mlh5599/volt-drive-mode-fixer/DESIGN.md

# Volt Drive Mode Fixer — Design

**Status:** deployed on the Pi (`voltpi`), field testing (Phase C).

- **Done:** mode-button input (`0x1E1`), current-mode status (`0x1F4` byte
  1), and shift/PRNDL (`0x1F5` byte 3) are confirmed on-road; the
  closed-loop menu walk has an on-road PASS. SOC is resolved via the
  `22 005B` UDS poll (`raw·100/255`, gauge↔SOC ≈ `7.07·bars + 19.6`,
  r = 0.999), so the level-triggered reconciler in "Mode policy" — SOC-HOLD
  floor keyed off that poll, `0x096` byte 3 as a coarse failsafe — is
  **implemented**. `--dry-run` is gone: the daemon boots **armed** on the
  first detent of the four-position selector (passive until the SOC floor
  engages), and `voltdmf-ctl disarm` is the mid-drive stop.
- **Not done:** migrating the out-of-repo `roles/voltdmf` ExecStart /
  `config.yaml` to match.

Running status, per-drive procedures, and outcomes: `docs/field-session-log.md`
and `docs/phase-c-field-checklist.md`.

## Problem

On an aging Gen 1 Chevy Volt (2011–2015), fully depleting the EV battery causes
the pack voltage to sag under load, which trips "reduced propulsion" mode: the
gas engine revs to near max RPM to generate power directly, and the car
becomes sluggish. The owner currently avoids this by manually switching
drive/charge modes before the battery runs low. This project automates that
with a device on the car's CAN bus that continuously reconciles the drive mode
(see "Mode policy" below) toward a desired mode, switching before the pack gets
low enough to cause the problem.

## Design requirements

- **DR1 — Prevent reduced-propulsion mode.** Act on EV battery SOC/range
  before the pack depletes far enough to cause voltage sag and trigger
  reduced-propulsion mode.
- **DR2 — Drive toward a chosen mode each drive cycle.** On every drive cycle
  (ignition on) hold a selected mode (MOUNTAIN or, by default, the SOC-HOLD
  floor). Realized as the reconciler's four-position selector — see "Mode
  policy".
- **DR3 — SOC floor.** When SOC drops to a configurable percentage, switch to
  Hold Mode and keep it there until the pack recovers. Realized as the floor
  in "Mode policy" — live in the `hold-soc`, `hold-now` and `mountain`
  detents, deliberately disabled in `off`.
- **DR4 — Off-the-shelf hardware preferred.** Favor a proven, reusable CAN
  interface over custom PCB/firmware design; hobbyist-level electronics
  work (soldering, wiring, light scripting) is acceptable where needed.
- **DR5 — Extensible to a future Trip Mode input.** The reconciler/injector
  architecture must accommodate a speed-based Hold input feeding the desired
  mode later without a redesign.

## Vehicle context

The Volt (both Gen 1 and Gen 2, model years 2011–2019) uses GM's **Global A**
CAN architecture. Unlike newer GM "Global B" vehicles, there is no
authenticating central gateway blocking the OBD-II port — the standard
driver-side OBD-II connector gives direct read/write access to the relevant
CAN buses. The Volt also has a second, auxiliary OBD-style connector
(passenger side) exposing the HV/battery-management bus, but the standard
port is sufficient for this project.

Gen 1 (this car) has a single physical mode button that **cycles** through
four modes, in order: **Normal → Sport → Mountain → Hold** (then presumably
back to Normal). This is the same kind of cycling control opendbc documents
for Gen 2 — plausibly even the same underlying signal (`0x1E1`, see below),
though that's only confirmed on a 2017 (Gen 2) car and needs verification on
this one.

Each mode's behavior:
- **Normal** — uses the full EV battery before switching to gasoline.
- **Sport** — same battery behavior as Normal, snappier throttle response.
- **Mountain** — lets the pack drain to ~50% SOC, then maintains ~50% by
  engaging the gas engine as needed.
- **Hold** — maintains the pack at *whatever SOC it's at* when engaged, by
  engaging the gas engine as needed.

Because it's a cycle button rather than discrete per-mode controls, reaching
a specific target mode means sending the same one button-press message a
computed number of times from the current mode — not one distinct message
per mode. See "Mode policy" and "Software architecture" below.

## Mode policy — continuous reconciler

> **Why a reconciler, not edge triggers.** An edge-triggered switch does
> nothing if the driver later bumps the mode by hand or a switch doesn't
> take. A single **level-triggered reconciler** that continuously drives the
> car toward a *desired* mode is simpler and self-healing, and satisfies both
> DR2 and DR3 without separate configurable triggers.
>
> This was originally reasoned from "ignition is effectively always on (the
> Pi only has power while the car runs), so there is no ignition edge to
> trigger on" — **falsified on-road, Session 13 (2026-09-19):** the car has a
> retained-power-like window (ignition off, door not opened) where the Pi,
> cluster, and cluster-related bus traffic all stay alive, and the reconciler
> kept trying to walk the menu in it. The level-triggered design itself still
> stands on the argument above, independent of ignition; what was missing was
> a *precondition* — **added Session 14 (2026-09-19):** `0x3ED` presence is a
> confirmed ignition-on signal, and `SafetyGate._precondition_failure()` now
> blocks both the reconciler and manual `set-mode` while it reads off.

**Desired mode = f(selector position, SOC).** One loop pass computes the mode
the car *should* be in. The result is concrete (HOLD / MOUNTAIN) **or `None`**
— `None` means "no target, leave the car alone", which is what the `hold-soc`
detent yields above the floor and what `off` yields unconditionally. If a concrete desired mode differs from
`state.drive_mode` (read from `0x1F4` byte 1) and the daemon is armed, it asks
the safety gate to walk the menu there — so a hand-picked mode change gets
walked back, at most once per 10 s cooldown. The reconcile is also skipped
entirely until `0x1F4` decodes a current mode (a fresh boot on a quiet or
just-woken bus does nothing until it can see where the menu cursor is).

**The four-position selector.** One panel button (SW1) is a rotary detent the
driver taps forward; a fifth tap returns to the first position. The daemon
owns the cycle (`voltdmf-ctl setpoint next`), so nothing can drift out of step
with it.

| position | pack above `hold_threshold_percent` | pack at/below `hold_threshold_percent` |
| --- | --- | --- |
| **1. `hold-soc`** — hold the pack at 30 % (boot default) | desired = **None** — leave the car alone | desired = **HOLD**, latched for the key cycle |
| **2. `hold-now`** — bank what is left, starting now | desired = **HOLD** | desired = **HOLD** |
| **3. `mountain`** — enforce MOUNTAIN | desired = **MOUNTAIN** | desired = **HOLD** (floor wins) |
| **4. `off`** — as if unplugged | desired = **None** | desired = **None** — *floor disabled* |

- **Position 1 is the product.** "Hold the battery at 30 %" is the whole point
  of the device, so it is both the first detent and the boot default. It is
  passive above the floor: the car drives on battery exactly as it normally
  would, and a mid-drive restart on a healthy pack leaves the car where the
  driver had it. The daemon only acts once the pack reaches
  `hold_threshold_percent`.
- **Position 2 is the same floor, brought forward.** `hold-now` asks for HOLD
  from loop 1 whatever the pack reads, and needs no SOC reading at all — for
  the drive where the driver decides *now* is the moment to stop spending
  charge (a highway leg before a city errand). It is enforcement, not the
  floor, so `floor_latched` stays false; the floor can still latch underneath
  it and would change nothing, since both ask for HOLD.
- **Position 4 turns the device off, floor included.** `off` short-circuits
  *before* the floor is evaluated and clears any standing latch, so the car
  behaves exactly as if the Pi were not plugged in. This is the one position
  in which the pack is unprotected — deliberate, so the driver always has a
  way to hand the car back to itself without pulling the connector. Entering
  `off` clears the latch rather than freezing it, because a latch surviving
  there would re-assert HOLD the instant the driver taps back round, on a
  reading that may be minutes stale — and it is, deliberately, the only way to
  release a latched floor without restarting.
- **The selector is not persisted.** The Pi runs a read-only root with an
  overlay filesystem, so there is nothing to write to, and **every boot starts
  at `default_position`** (`hold-soc`). A fresh key cycle is a fresh drive.
- **The floor latches for the key cycle.** At/below `hold_threshold_percent`
  (**30** — diag SOC from the `22 005B` poll) the floor engages (desired =
  HOLD) and **stays engaged** for the rest of the key cycle. There is no
  release percent: "drain to 30 %, then hold, and do not let it change".
  Regen or a long descent putting charge back into the pack must not hand the
  car back to EV mode and spend it again. The latch lives in memory only and
  is dropped on `reload` and on a restart; the selector position survives a
  reload — it is the driver's live choice.
- **Failsafe on a stale poll.** If the poll stops answering (older than
  ~45 s), `0x096` byte 3 ≤ `bar_failsafe_raw` (**9**, ≈ 2 gauge bars) forces
  HOLD. Because the latch is now permanent for the key cycle, the failsafe
  holds fire for the first ~45 s after start — long enough for the poll to get
  a word in — rather than committing the whole drive off a ~13 %-per-count
  proxy before the exact reading has had a chance to arrive. After that grace
  it fails safe into charge-sustaining HOLD.
- **Floor target = 2 gauge bars remaining.** On a full-drain drive the last
  bar (`1→0`) fell in **53 s** against a ~170 s average for the other nine —
  the bottom of the gauge is a cliff, so the floor engages while 2 bars still
  show. Gauge↔SOC: `SOC% ≈ 7.07·bars + 19.6` (r = 0.999); the 3→2 bar drop is
  **33.7 %** (raw 0x56), the 4→3 bar mark **41.2 %** (raw 0x69). The engage
  point is **30 %** — mid-2-bar, and the driver-facing name of position 1.
- **A spent pack takes HOLD off the menu.** Once the car gives up on the pack
  for a key cycle it starts the range extender and sits in NORMAL, and the
  centre stack stops offering HOLD and MOUNTAIN at all — observed in the field
  (a restart after parking on a nearly-flat pack) and caught on the wire in a
  full-drain capture. Walking a menu that has no such entry can
  only spend taps, so **engine running + car in NORMAL + no fresh SOC reading
  above 24 % ⇒ the reconciler withholds its target** and reports why
  (`reconciler.charge_sustaining_block`, surfaced as `ice_block` in `status`,
  `NO HOLD` on the LCD). The 24 % release keeps a cold-morning ERDTT start, an
  engine-maintenance cycle, or our own working HOLD from blocking anything.
  The check is level-triggered and self-clearing, fails **open** on an unknown
  engine reading (a car without `0x4C5`/`0x3F9` behaves exactly as before) and
  **closed** on an unknown SOC, and the SOC floor gets no exemption — a
  latched floor asking for HOLD on a written-off pack is the exact drive that
  produced it.
- **Give up after three walks.** The gate above covers the one failure we
  understand; `safety.AttemptBudget` covers every other one without needing to
  know what it is. The reconciler is level-triggered, so "mode != target"
  stays true forever if the walk never lands — before this, the only thing
  between that and a whole drive of 10 s tap bursts was the cooldown itself.
  Three walks, because a walk is already a closed loop that taps up to 12
  times reading the cursor back each time: a whole walk failing is not "a tap
  went missing", it is "the menu is not behaving", and a fourth identical walk
  is not new information. An **attempt** is a walk that put taps on the wire —
  a walk suppressed by the cooldown, a precondition, or the ICE block costs
  nothing, so a car with a quiet bus never burns the budget. It clears when
  the car reaches the mode (however it got there — the driver's own thumb
  counts), when the target changes, and on explicit intent: an SW1 tap, a
  `set-mode`, an `arm`, a `reload`, and the bus going quiet, which is this
  project's key-cycle boundary. Nothing is persisted and nothing expires on a
  timer: giving up is meant to be visible (`give_up` / `attempts` in `status`,
  `GAVE UP` on the LCD, one journal line per edge) and to stay given up until
  a person or the car says otherwise.
- **Reconcile cadence vs. the driver.** The reconcile runs every loop but
  every switch still goes through `SafetyGate` (preconditions + the 10 s
  cooldown), so if the driver fights the selector the daemon re-asserts at
  most once every ten seconds. The cooldown started at 60 s, when a runaway
  walk was the fear; field testing has landed 35/35 legs in ≤ 4 taps, and at
  60 s a driver who bumps the stalk could spend most of a minute in the wrong mode.
  10 s still rules out sustained transmission. The button is the intended
  override — tap round to `off` and the daemon stops asserting anything.

**Mechanics of reaching a target mode** (unchanged). The button cycles
Normal → Sport → Mountain → Hold, so "go to HOLD" means "press N times" where
N depends on the current mode. The current-mode status signal is confirmed
(`0x1F4` byte 1), so the controller reads it directly and closes the loop on
the live menu cursor (`0x1F4` bytes 4+5) rather than blind-counting. The
blind count `index(target) + 1` is in fact correct from any mode — the menu
always opens on NORMAL — so the closed loop buys early exit and a hard
failure on a dropped tap, not correctness.

**Trip Mode (DR5, future work — not building this yet).** The
[prior-art project](https://github.com/vix597/chevy-volt-trip-mode)'s
speed-based Hold (bank EV range on the highway, release it in the city) would
become a fifth detent or a modifier on the policy, reusing the same
reconcile + injector plumbing. Tracked, not scheduled.

Config (`config.example.yaml`; parsed by `voltdmf/config.py`):

```yaml
policy:
  default_position: hold-soc    # hold-soc | hold-now | mountain | off — boot
                                # detent, not persisted
  hold_threshold_percent: 30    # floor forces HOLD at/below this diag SOC and
                                # latches for the rest of the key cycle
  bar_failsafe_raw: 9           # 0x096 b3 <= this forces HOLD if the poll is stale

soc_poll:
  enabled: true                 # run the 22 005B UDS poll for ground-truth SOC
  period_seconds: 10            # request cadence
```

`parse_config` validates `default_position ∈ {hold-soc, hold-now, mountain,
off}`, `0 ≤ hold_threshold_percent ≤ 100`, `0 ≤ bar_failsafe_raw ≤ 255`, and
`period_seconds > 0`. The old key name `default_setpoint` is still read, and
the old detent names `auto` (two-way toggle) and `hold` (three-position cycle)
both map to `hold-soc` — that is what each meant at the time — so a config.yaml
from either era keeps loading; setting both keys is an error. The retired
`hold_reset_percent` is warned about and ignored rather than rejected, so a
host that has not converged yet still boots. The button GPIO pins live in the `button_helper.py`
unit, not here.

## Prior art (reuse this, don't rebuild it)

[`vix597/chevy-volt-trip-mode`](https://github.com/vix597/chevy-volt-trip-mode)
(blog writeup: [seanlaplante.com](https://seanlaplante.com/2021/11/13/hacking-my-chevy-volt-to-auto-switch-driving-modes-for-efficiency/))
is a 2017 Volt (Gen 2) project that does almost exactly this kind of
automation — it auto-switches modes based on speed rather than SOC, using a
comma.ai panda + Raspberry Pi. It's built directly on
[`commaai/opendbc`](https://github.com/commaai/opendbc)'s
`gm_global_a_powertrain.dbc`, which decodes the Volt/Bolt-era GM Global A
bus. Reuse this DBC file and its CAN signal IDs rather than
reverse-engineering the whole bus from scratch; this project reads/writes
CAN over PiCAN2's SocketCAN interface rather than panda, but the signal
discovery and injection logic transfer directly.

Its known gap, worth fixing rather than copying: it runs the panda in
`SAFETY_ALLOUTPUT` mode with no message whitelist, so the device is
technically capable of transmitting anything on the bus. This project has no
hardware-level safety firmware equivalent (PiCAN has none built in, unlike
panda), which makes the software-level "Safety model" below — the single
narrow send function and rate limiting — load-bearing rather than a second
layer of defense.

## Known CAN signals

| Signal | ID | Notes |
|---|---|---|
| EV battery SOC (exact) | `22 005B` (UDS PID) | **The daemon's SOC source.** `0x206` (the Gen 2 broadcast candidate) is not on this bus, and no passive frame carries SOC at usable resolution, so the daemon polls diagnostic PID `22 005B` ("Hybrid/EV Battery Pack Remaining Charge") every ~10 s: request `03 22 00 5B 55 55 55 55` to `0x7E4` then `0x7E0` (lock onto whichever answers), reply on `0x7E8..0x7EF`, `SOC% = d[4]·100/255`. Stays in the default diagnostic session, service-22 only — no session switch, no TesterPresent — so it can't suppress normal broadcasts. The poll is a second hard-coded TX path (`canio.send_soc_poll`), ungated by arm state, gated only by `soc_poll.enabled`. |
| EV battery SOC (coarse proxy / failsafe) | `0x096`, byte 3 | Only valid in the `x F0 0A xx` mux (`data[1]==0xF0 and data[2]==0x0A`). Steps ~13 % SOC per count — far too coarse to key the floor off, used only as the failsafe when the `22 005B` poll goes stale: b3 ≤ `bar_failsafe_raw` (9 ≈ 2 gauge bars ≈ 30 %) forces HOLD. `signals.decode_soc_bar_raw`. |
| Drive mode cycle button press | `0x1E1`, byte 4 bit 7 | **CONFIRMED on Gen 1, on-road.** `ASCMSteeringButton`; byte 4 low bits are a rolling counter, bit 7 is the press flag. Same ID/bit the Gen 2 prior art injects. `voltdmf/canio.send_mode_button_press()` (tracking-echo press) — one of the daemon's two hard-coded TX frames (the other is the `22 005B` SOC poll); this is the only one gated by arm state. |
| Ignition on/off | `0x3ED` (presence) | **CONFIRMED 2026-09-19, Session 14.** The Pi being powered from the switched accessory socket does *not* imply the daemon only runs while the car is on: Session 13 found a retained-power-like window ("RAP") — ignition off, door not opened — where the cluster, the Pi, and cluster-related bus traffic (`0x1F4`/`0x1F5`/`0x3E9`) all stay alive, and `state.bus_active` (fed by that same traffic) cannot tell RAP from ignition-on. Session 14's in-car ON/OFF/ON capture (reproduced across two cycles) found the ID that can: `0x3ED` is present (constant payload `80 00 00 00 00 FF`) only while the ignition is on, and vanishes entirely — the whole ID, not a byte within it — through the RAP window. `state.ignition_on`, fed by it, is now a `SafetyGate._precondition_failure()` precondition, so both the reconciler and manual `set-mode` refuse a switch in RAP. The Session-13 fast-abort mitigation (`MENU_UNRESPONSIVE_TAPS`) stays in place as defense in depth. Not yet measured: `0x3ED`'s own transmit period (`IGNITION_QUIET_TIMEOUT_S` borrows `BUS_QUIET_TIMEOUT_S` as a placeholder). |
| Vehicle speed | `0x3E9` | Bytes 0-1 big-endian ÷ 64 → km/h (× 0.621371 → mph). Per the GM Volt reverse-engineering wiki, cross-checked against a full-drain capture; not yet speedo-verified. DLC 8, 10 Hz; bytes 2 & 6 are a mux/rolling counter. Not needed for the SOC-triggered design but useful for bench testing/logging (`tools/soc_log.py` logs it plus a derived accel). |
| Shift/PRNDL position | `0x1F5`, byte 3 | **CONFIRMED on Gen 1.** `1` PARK, `2` REVERSE, `3` NEUTRAL, `4` DRIVE, `5` LOW. Reported in `status` / the trip log, **not** a `SafetyGate` precondition — a drive-mode change has no driveline implication, so PRNDL does not block a switch (see "Safety model"). `0x135` byte 0 also tracks the shifter but with a messier non-sequential encoding — left undecoded. |
| EV range remaining | — | **Not documented anywhere found.** The `22 005B` SOC poll (above) is the trigger signal instead — satisfies the design requirement to trigger on range or battery % (DR1/DR3) and is the metric that's actually accessible. |
| Reduced-propulsion / limp-mode indicator | — | **Not documented.** Not needed for this design since the goal is to act *before* this state, using the SOC threshold instead. |
| Range-extender engine running | `0x4C5` byte 2 (+ `0x3F9` bytes 1-2) | **CONFIRMED on Gen 1, offline from field captures.** `0x4C5` b2: `0x49` off, `0xDD` on an engine leg, `0x59`/`0x87`/`0xB5` a ~1.5 s ramp at either edge. `0x3F9` b1-2 BE is a fuelling accumulator whose *movement* corroborates it -- it leads `0x4C5` by 33-42 s at the head of a leg and freezes on overrun and at rest, so the two are read as a union (`VehicleState.engine_running`). Purpose: once the pack is spent the car runs the engine in NORMAL and drops HOLD/MOUNTAIN from the centre-stack menu, so the reconciler must stop walking to a mode that is not on offer (see "Mode policy" / `reconciler.charge_sustaining_block`). `docs/analysis/session12-engine-signal.md`. |
| Current drive mode (status, not button-press) | `0x1F4`, byte 1 | **CONFIRMED on Gen 1.** Latched mode: `0x00` NORMAL, `0x80` SPORT, `0x20` MOUNTAIN, `0x08` HOLD. byte 4 = live drive-mode menu cursor (steps ~40 ms after each tap; distinct byte codes), byte 5 bit 7 = menu-open hint. The daemon reads byte 1 as its current-mode source — the press-counting fallback is retired. |

## Hardware design

### Alternatives considered

DR1–DR3 require a device that can both read and write raw CAN traffic on
the vehicle's buses — not just standard OBD-II diagnostic PIDs. That rules
out generic ELM327-style OBD2 USB/Bluetooth adapters (e.g. the ones used
with Torque): they speak the OBD2 diagnostic request/response protocol
only, can't sniff non-standard manufacturer IDs like `0x206` (SOC) or the
mode-cycle button message, and generally can't transmit arbitrary frames at
all. Among devices that do speak raw CAN:

| Device | Read+Write | Approx. price | Why not chosen |
|---|---|---|---|
| **CANable / CANtact** | Yes | $30–60 | SocketCAN-compatible, works with generic `python-can`, but no GM-specific precedent or safety/ignition features — this project would own all the reverse-engineering and safety-model work with no reference to check against. |
| **PCAN-USB (PEAK-System)** | Yes | $200+ | Industrial-grade and very reliable, but priced and positioned for professional automotive tooling rather than the hobbyist car-hacking community — little overlap with existing GM Global A tribal knowledge. |
| **Kvaser Leaf Light** | Yes | $200–400+ | Similar tier to PCAN-USB — professional-grade and overkill for this project's scope. |
| **Macchina M2** | Yes | — | Purpose-built for vehicle hacking, similar spirit to panda, but reportedly hard to source or discontinued. |
| **ESP32 + SN65HVD230 transceiver** (DIY) | Yes | $20–25 | Cheapest option, but the whole CAN stack, message filtering, and safety logic would need to be written from scratch — the most custom-firmware work of any option, cutting against the off-the-shelf/light-scripting preference (DR4). |
| **Freematics ONE+** | Yes | — | Telematics-focused (built-in GPS/logging); CAN-capable but little presence in the GM/opendbc hobbyist community. |
| **comma.ai panda (red)** | Yes | $99 | Only option with a documented Volt-specific precedent ([`vix597/chevy-volt-trip-mode`](https://github.com/vix597/chevy-volt-trip-mode)) and comes with openpilot's safety-firmware rate-limiting built in. Ruled out on sourcing grounds: the red panda's vehicle-side port is a proprietary "OBD-C" connector, not standard OBD-II — reaching a vehicle's OBD-II port needs a $49 third-party adapter ([konik.ai OBD2C connector](https://konik.ai/shop/obd2c-connector/)) that ships only from an EU warehouse, with no US stock or reseller found. Older pandas with a native OBD-II connector (white/grey/black) are discontinued and only findable used. |
| **PiCAN2 / PiCAN3** (Raspberry Pi HAT) — **chosen** | Yes | $37–78 + a Pi | See below. |

**Why PiCAN2:** PiCAN2 and PiCAN3 use identical CAN silicon (MCP2515
controller / MCP2551 transceiver) — read/write capability is the same on
both. PiCAN3 adds Pi 4 support, an onboard automotive-range SMPS, reverse-polarity
protection, and an RTC, none of which this project needs: **PiCAN2** paired
with a Pi 3B is the simpler, cheaper choice. Both expose a DB9 connector
(jumper-selectable for an "OBD-II cable" pinout), and standard off-the-shelf
OBD-II-to-DB9 cables exist that carry exactly the three wires needed
(CAN-H, CAN-L, ground) — e.g. the
[iKKEGOL DB9-to-OBD2 cable](https://www.amazon.com/iKKEGOL-Adapter-Diagnostic-Extension-Connector/dp/B077SHQQ1D)
(~$10–15, ships from a US Amazon warehouse). This sidesteps the sourcing
problem that ruled out panda entirely — no proprietary connector, no
overseas shipping, no DIY fabrication required. It satisfies DR4 better
than panda on balance: slightly more wiring/config work (SocketCAN device-tree
overlay setup) in exchange for a fully off-the-shelf, US-available parts
list. Because PiCAN exposes standard Linux **SocketCAN** (`can0`), the same
interface `python-can`/`cansend` use everywhere, the reference project's
`opendbc`-based injection logic ports over by swapping the transport
backend (socketcan instead of panda), not rewriting the injection logic.
The read+write pattern itself is proven on this hardware generically (e.g.
[skpang/PiCAN-Python-examples](https://github.com/skpang/PiCAN-Python-examples)
transmits live CAN frames to drive a real instrument cluster gauge) —
there's no GM/Volt-specific PiCAN precedent, but none was needed once the
signal IDs are confirmed from the panda-based reference project's work.

Note: PiCAN2 draws its 5V entirely from the Pi's own 40-pin GPIO
header — it has no separate power input of its own. This matters for the
power design below.

**BOM — ordered 2026-08-23:**

| Part | Role | Price paid | Source |
|---|---|---|---|
| PiCAN2 (SK Pang, base version) | CAN read/write interface, DB9 connector | $59.95 | [Copperhill Technologies](https://copperhilltech.com/pican-2-can-bus-interface-for-raspberry-pi/) |
| Raspberry Pi 3B | Runs the monitor/injector daemon; PiCAN2 mounts directly on it | $35.00 | [Adafruit #3055](https://www.adafruit.com/product/3055) |
| OBD-II-to-DB9 cable (iKKEGOL) | Connects PiCAN2's DB9 port to the vehicle's OBD-II port | ~$10–15 | [Amazon](https://www.amazon.com/iKKEGOL-Adapter-Diagnostic-Extension-Connector/dp/B077SHQQ1D) — also Copperhill's own recommended replacement for their now-discontinued OBD2-DB9 cable, confirming the pinout matches PiCAN2's OBD-II jumper setting (CAN-H → OBD pin 6 → DB9 pin 3; CAN-L → OBD pin 14 → DB9 pin 5; ground → OBD pins 4/5 → DB9 pins 1/2) |
| 12V cigarette-lighter/accessory-socket USB car charger (5V) | Power for the Pi | ~$8–10 | any standard USB car charger |
| microSD card | OS storage | ~$8 | any Class 10/A1-rated card |

This is a smaller footprint than the reference project (which added a
touchscreen for a manual UI) since this design's whole point is to run
unattended — no display needed. Mount the Pi + PiCAN2 somewhere accessible
(e.g. under the dash near the OBD port) so it's easy to unplug entirely if
something needs to be debugged or disabled — that's the physical kill
switch, and it's free.

**Power.** This Volt's accessory (cigarette-lighter) socket is switched
with the car rather than always-hot, so a standard USB car charger plugged
into it is sufficient — no relay, no separate switched-12V tap, and no
ignition-sense circuitry needed to avoid draining the 12V battery while
parked. That still means power gets cut abruptly (no clean OS shutdown) on
every drive cycle, which is addressed at the OS level instead of with extra
hardware: configure Raspberry Pi OS's built-in **Overlay File System**
(`raspi-config` → Performance Options) so the root partition is mounted
read-only with a RAM (tmpfs) overlay for writes — nothing is physically
written to the SD card during normal operation, so an abrupt power cut
can't corrupt it. This requires also write-protecting `/boot/firmware`
(asked as a separate prompt in the same raspi-config flow) and disabling
swap, both easy to miss. The tradeoff: anything not explicitly persisted
outside the overlay (logs, runtime config changes) is lost on every power
cycle — acceptable here since drive-mode state is re-derived from the CAN
bus on each boot, but something to keep in mind if the daemon later needs
to persist SOC-threshold calibration or logs across drives.

**Ignition-off power blip (owner-observed 2026-09-19, not yet root-caused).**
The power cut at key-off is not always clean: pressing the ignition button
puts a momentary blip/brownout on the switched accessory socket that resets
the Pi outright. It then reboots into the RAP window described above (see
the "Ignition/drive-cycle start" row) with the daemon starting fresh —
systemd brings it up **armed**, and it immediately faces a bus that is still
carrying cluster traffic from a car that is actually off. This reframes the
Session 13 failure: it is not a long-running daemon misreading a stale
signal, it is a cold boot walking straight into RAP. Candidate fix: bulk
capacitance on the Pi's supply to ride through the blip — not yet sized or
installed. Until then, any capture meant to isolate the ignition-off
transition cleanly (e.g. `tools/ignition_diff.py`) needs the Pi on an
external battery/UPS, not the stock USB charger, or the capture process
dies with the reset. **Session 14 update:** a cold boot into RAP is no
longer a walk waiting to happen — `state.ignition_on` (fed by `0x3ED`) is a
`SafetyGate` precondition, so a fresh daemon booting straight into a RAP
window now reads ignition off and refuses to walk, same as any other RAP
case. The power-blip hardware fix is still worth doing (an unplanned reboot
mid-drive is its own problem), but it is no longer what stands between a
cold boot and a doomed menu walk.

## Software architecture

Reuse rather than rebuild:
- **`opendbc`**'s `gm_global_a_powertrain.dbc` for decoding/encoding CAN
  frames (SOC, speed, shift position, and — once discovered — the Gen 1 mode
  button signal).
- **`python-can`** (with its SocketCAN backend) for talking to PiCAN2's
  `can0` interface from the Pi.
- **SavvyCAN** (has native SocketCAN support on Linux) or **can-utils**'
  `candump`/`cansend` for the manual reverse-engineering phase (see below)
  — no need to write custom logging tools. (`cabana`, used in the panda-based
  reference project, is panda-specific and doesn't apply here.)

The custom code needed is small and specific to this project:

1. **Config loader** — reads the YAML above, validates it (detent name,
   percentage and byte ranges), and produces the policy for the run.
2. **SOC poller** — an inline loop step (`daemon._service_soc_poll`) that
   sends `22 005B` every `soc_poll.period_seconds` (`canio.send_soc_poll`,
   ungated by arm state); the RX listener folds replies on `0x7E8..0x7EF`
   into `state.soc_percent` / `soc_raw` / `soc_percent_monotonic`. `0x096`
   byte 3 is decoded passively into `state.soc_bar_raw` as the failsafe
   proxy. `0x206` is absent on this bus.
3. **Reconciler** (`voltdmf/reconciler.py`, replaces `triggers.py`) — a pure
   object, `Reconciler.desired_mode(state) -> DriveMode` (always concrete),
   per the "Mode policy" table, plus the in-memory floor-latch hysteresis and
   the b3 failsafe. The loop calls it every pass and, when `desired` differs
   from `state.drive_mode` and the daemon is armed, hands `desired` to the
   safety gate. No per-drive edge state, no once-only latch.
4. **Button helper** — a tiny separate process (system Python, `gpiozero`)
   that owns the two PiCAN2 pads (SW1 = BCM 24, SW2 = BCM 23) and dispatches
   by gesture:
   - **SW1 tap** → `voltdmf-ctl setpoint next`: advance the selector one
     detent (`hold` → `mountain` → `off` → `hold`). The daemon owns the
     cycle; the helper keeps no index of its own, so a daemon restart or a
     `setpoint` from the shell can never leave the button a tap behind.
   - **SW1 held alone ≥ 8 s, then released** → `voltdmf-ctl walk-test`: the
     daemon cycles the closed-loop mode walk through every drive mode, scores
     each landing off `0x1F4`, and walks back to the starting mode. The 5–8 s
     SW1-solo window is a dead zone so a slow reach for the combo can't trip
     it; result shows on the LCD watch screen.
   - **SW2 held ~5 s alone, then released** → launch the charge-current
     setpoint capture (`voltdmf-chargelog.service`; checklist §2e). Fires on
     release with SW1 never joined, so a hand travelling toward the combo
     below can't trip it.
   - **SW1 + SW2 held ~5 s** → launch the SOC-discovery capture
     (`voltdmf-soclog.service`).

   Both launches free the GPIO lines, claim the LCD hand-off lock, `systemctl
   start` the oneshot and block until it exits (polling `is-active`, never
   trusting the queued `start`), then re-acquire — and wait for both pads to
   be released before reading gestures again so the capture's hold-BOTH stop
   can't roll into a fresh launch. The gesture rules live in a side-effect-free
   `_Gestures` state machine (unit-tested off-Pi). Kept out of the daemon so
   its venv gains no GPIO dependency and its privilege set is unchanged; it
   reaches the daemon only through the existing control socket. Its own
   systemd unit in `roles/voltdmf`.
5. **Mode-cycle controller** — reads current mode from the status signal
   (`0x1F4` byte 1, confirmed), walks the drive-mode menu to the requested
   `target_mode` along the fixed Normal→Sport→Mountain→Hold cycle order —
   closing the loop on the live menu cursor (`0x1F4` bytes 4+5) — and sends the
   taps through the safety wrapper below. This is the one place that needs the
   actual button-press CAN frame; the reconciler and `set-mode` both just ask
   it for a `target_mode` and it doesn't care which asked.
6. **Safety wrapper** (see next section) — the only code path allowed to
   transmit.

The button-press signal (`0x1E1`) and the current-mode readback (`0x1F4`)
are both confirmed on-vehicle, so this controller now exists
(`voltdmf/modecycle.py`). The original caution still holds as a principle: a
controller built against a guessed CAN ID, or one that can't tell what mode
it's starting from, is worse than not having one.

## Safety model

CAN has no authentication, and the reference project's `SAFETY_ALLOUTPUT`
approach means the panda can transmit *anything*, not just the one message
this project needs. Tighten that:

- **Two narrow send functions, no generic sender.** `canio` has exactly two
  functions that put a frame on the bus: `send_mode_button_press()`
  (hard-coded `0x1E1` press — every mode transition reuses this one message,
  gated by arm state) and `send_soc_poll()` (hard-coded `22 005B` request,
  ungated — a read-only diagnostic poll). Each hard-codes its ID + payload;
  there is no general-purpose "send arbitrary frame" path.
- **Two sockets, split by job.** `open()` binds *two* SocketCAN sockets to the
  same interface: `_bus`, which the RX `can.Notifier` owns, and `_echo_bus`,
  hardware-filtered to `0x1E1` and used only by the press path. This is a
  correctness requirement, not an optimization. The tracking-echo press must
  mirror the module's *current* `0x1E1` counter — a stale counter is the
  frozen-counter frame the cluster ignores — and sharing one socket breaks
  that two different ways, both measured on-vehicle:
  `recv()` alongside the Notifier lost 21% of taps, because SocketCAN gives
  each frame to exactly one reader; taking the frame from the Notifier's
  decoded state instead was *worse* at 36%, because that thread lags on a busy
  Global A bus and hands back an already-stale frame. A second bound socket
  gets its own copy of every frame, so the echo is neither contended nor
  stale. It widens no privilege: the filter means it only ever queues `0x1E1`,
  and the only thing written to it is the one hard-coded press frame.
- **Rate limiting.** Cap both the size and rate of a press burst — at most
  3 presses (Normal→Hold, the longest possible cycle) with realistic
  inter-press spacing, never a sustained/looping transmission. Re-check the
  current mode (if readable) after sending to confirm it landed on the
  intended target rather than blindly trusting the press count.
- **Bounded persistence.** Rate limiting bounds how *fast* the daemon can
  tap; it does nothing about how *long*. A level-triggered reconciler chasing
  a mode the car will not take is a slow-motion runaway, and one whole drive
  of it is what a real field failure looked like. `safety.AttemptBudget`
  bounds the total: three walks per target, then it stops and says so, until
  the car reaches the mode or a person intervenes (see "Mode policy").
- **Preconditions before injecting**: a live bus and a plausible speed. Both
  are checks on the *bus* — a quiet bus means nobody is listening, an
  implausible speed means the frames being decoded are garbage. **Shift/PRNDL
  is deliberately not a precondition.** The button being pressed is the
  centre-stack energy-mode menu (Normal/Sport/Mountain/Hold); it changes how
  the car spends the pack, never what the driveline does, so pressing it
  stopped in Park is exactly what a driver does. Gating on Drive bought no
  safety and cost real behaviour — it stopped the reconciler settling the
  mode in the driveway or at a charger before the car moved. Shift is still
  decoded and reported, just not enforced.
- **Fail passive.** If the daemon crashes or hangs, it should simply stop
  transmitting — never get stuck mid-loop retrying a send. Run it under a
  process supervisor (e.g. `systemd` with restart-on-failure). The daemon
  keeps **no persisted state** (read-only overlay root): a fresh start boots
  armed at `default_position` (`hold-soc` on the shipped config → passive above
  the floor) with the floor latch clear and re-derives everything from the
  live bus, so there is no stale latch to re-fire and — absent a low pack —
  nothing to walk.
- **Physical kill switch**: unplugging the OBD connector fully removes the
  device from the bus — keep it physically easy to reach for exactly this
  reason during early testing.
- **Bench test before live testing.** Validate the discovered mode-switch
  message with the car safely stationary (ignition on, engine off, or on
  jack stands) before relying on it while driving.
- **Runtime control does not widen the transmit surface.** The daemon runs
  permanently as root under systemd; operators drive it from an unprivileged
  account through a control socket (see "Runtime control" below). Every
  command that could transmit still funnels through the *same*
  `SafetyGate.request*()` → single `send_mode_button_press()` path the
  reconciler uses. A manual `set-mode` is an out-of-band nudge that does not
  move the selector — it is still subject to preconditions, the press cap, the
  cooldown, and the menu-cursor readback, and the reconciler will pull the mode
  back on its next pass. There is still no "send arbitrary frame" path.

### Runtime control

The daemon is a long-running root service, not a set of one-shot CLI
invocations. State changes come in over an `AF_UNIX` stream socket
(`voltdmf/control.py`), reached with the unprivileged `voltdmf-ctl` client:

| command | effect | path |
| --- | --- | --- |
| `status` | daemon + vehicle snapshot | answered read-only on the socket thread |
| `arm` / `disarm` | flip the runtime transmit-enable | queued → loop thread |
| `setpoint <hold-soc\|hold-now\|mountain\|off\|next>` | move the four-position selector to a named detent, or `next` for one detent forward (what the panel button sends) | queued → loop thread |
| `set-mode <mode>` | request one mode switch now, out of band | queued → `SafetyGate.request_verbose()` |
| `reload` | re-read the config file, rebuild the policy | queued → loop thread |
| `walk-test` | self-test the closed-loop mode walk: cycle every drive mode, score each landing, restore the start mode | queued → sets a flag; the loop thread runs the ~1 min cycle inline (reconciler skipped) and reports on the LCD + journal |
| `test-mode <on\|off>` | suspend / resume the reconciler for an interactive probe session (in memory — a restart brings protection back) | queued → loop thread sets a flag; the reconcile pass is skipped while on |
| `probe <mode>` | one operator-chosen closed-loop walk to `<mode>`, densely tracing the `0x1F4` cursor; records a `LANDED` / `CURSOR_ONLY` / `MISS` / `BLOCKED` verdict in `status` + the journal | queued → sets a flag; the loop thread runs it inline with a ~50 ms cursor sampler thread |

> **All commands are implemented.** `setpoint` drives the reconciler;
> `tools/button_helper.py`'s SW1 tap drives a real toggle. `walk-test` (SW1
> solo hold ≥ 8 s) drives its own cooldown-free `SafetyGate` around the shared
> controller, so the real 10 s gate and the single-threaded TX path are
> untouched; it needs the daemon armed and refuses if a run is already queued.
> `test-mode` + `probe` are the focused replacement for blind walk-test
> debugging: an operator suspends the reconciler, sets a known start mode by
> hand, asks for one target, and reads the per-tap + dense-sample cursor trace
> back — see `docs/analysis/session10-walk-probe.md`.

- **Privilege boundary = file mode.** The `.socket` unit binds it
  `0660 root:voltdmf`; operators join the `voltdmf` group. No setuid, no
  polkit, no D-Bus.
- **systemd socket activation.** `voltdmf.socket` passes an already-bound
  listening fd as fd 3; `control.inherited_listener()` picks it up with no
  `python-systemd` dependency. The service still runs continuously
  (`WantedBy=multi-user.target`) — activation only supplies the fd, it does
  not make the daemon on-demand.
- **Single-threaded transmit preserved.** `status` is answered directly from
  a state snapshot. Everything that can transmit or mutate state is put on a
  `queue.Queue` and executed by the daemon's one loop thread — the CAN TX
  path and `SafetyGate` are never touched from the socket thread.
- **One gate: armed / disarmed.** There is no `--dry-run`. The service boots
  **armed** — injection efficacy is on-road-confirmed, so there is no reason
  to hold it back a key cycle at a time — but with `default_position: hold-soc` it
  has no target and enforces nothing until the SOC floor engages or the driver
  taps SW1 round to `hold-now` or `mountain` (see "Mode policy"). Tapping round to `off`
  stands the device down entirely, floor included. `voltdmf-ctl disarm` is the
  mid-drive stop; `voltdmf-ctl arm` undoes it. While disarmed the reconciler
  still runs and logs what it *would* do, and the `22 005B` SOC poll still
  transmits (it is a read-only diagnostic request, not a mode change).
  `--start-disarmed` boots into the stopped state for bench work.
- **`setpoint` is the normal control.** It moves the four-position selector
  (`hold-soc` → `hold-now` → `mountain` → `off`, `next` to advance one
  detent). The CLI deliberately does not accept a bare `hold`: with two hold
  detents a human typing it today could mean either. The reconciler
  then drives the car toward whatever the detent implies and holds it there,
  self-healing if the driver bumps the stalk. The position lives in memory
  only — every boot starts at `default_position` (no persisted state; see
  "Mode policy").
- **`set-mode` is a soft, out-of-band nudge.** It asks the mode-cycle
  controller for one switch now without moving the selector, so the reconciler
  will pull the mode back on its next pass (after the cooldown). Use it for
  bench pokes, not steady-state control.
- **`reload` re-reads the config file.** It rebuilds the `policy:` /
  `soc_poll:` blocks and the reconciler. The live selector position is
  preserved (the driver's choice, not a file value); the floor-latch state
  is dropped, so the floor re-evaluates from the current SOC.

## Phased plan

1. **Signal discovery (on-vehicle, stationary).** Connect PiCAN2 + laptop
   (skip the Pi for now, or use the Pi itself with a monitor/SSH), log CAN
   traffic with SavvyCAN or `candump`.
   Confirm `0x206` tracks SOC sensibly on this car. Then, with the car
   safely stationary:
   - Press the mode button once and diff CAN traffic before/after. Check
     first whether it matches `0x1E1` bit 39 from `gm_global_a_powertrain.dbc`
     — if so, this signal transfers directly from the Gen 2 reference
     project and saves the rest of this reverse-engineering step.
   - Cycle through all four modes (Normal→Sport→Mountain→Hold) while
     logging, watching for any *other* message that changes value in sync
     with the mode change — that's the current-mode status signal the
     controller needs. A good place to check: whatever message drives the
     dash cluster's mode indicator icon, since that has to be broadcast on
     the bus regardless of what triggered the change.
   - Ignition-cycle mode persistence is no longer on the critical path: the
     reconciler is level-triggered and reads the live mode from `0x1F4` every
     pass, so it converges regardless of what mode the car powers up in.
2. **Bench-safe injection test.** Using the discovered button-press message,
   replay presses from the laptop (still stationary) and confirm the mode
   actually advances one step per press, in the expected order, and that
   nothing else on the bus reacts badly (watch for new DTCs, warning
   lights).
3. **Daemon development.** Write the config loader, the SOC poller, the
   reconciler, the button helper, and safety-wrapped injector(s) described
   above, using the confirmed CAN IDs. Test on the Pi with the overlay
   filesystem enabled (see "Hardware design") before final deployment — the
   read-only root is why the reconciler keeps no persisted state.
4. **Deployment.** Mount the Pi + PiCAN2 in the car, power from the
   accessory socket, and test across several real drive cycles, tuning the
   SOC threshold based on how early the switch needs to happen to reliably
   avoid reduced-propulsion mode.

## Open items

### Resolved on-vehicle (Gen 1, HS-CAN 500k)

Full detail in `docs/signals-confirmed.md`; decoders in `voltdmf/signals.py`.

- **Mode-cycle button press → `0x1E1` byte 4 bit 7** — same ID/bit as the Gen
  2 prior art; the one frame the daemon transmits. Drove a closed-loop walk
  to all four modes on the road.
- **Current drive mode → `0x1F4` byte 1** (`0x00`/`0x80`/`0x20`/`0x08` =
  N/S/M/H) — the daemon's current-mode source. Bytes 4+5 are one field, the
  live menu cursor used to close the loop on a walk (`00`/`80` = NORMAL,
  `80`/`00` SPORT, `40` MOUNTAIN, `20` HOLD, both `00` = menu closed).
- **Shift/PRNDL → `0x1F5` byte 3** (`1`–`5` = P/R/N/D/L). Decoded and
  reported; not a `SafetyGate` precondition (see "Safety model").
- **SOC → `22 005B` UDS poll.** Exact pack percent = `raw·100/255`
  from a ~10 s service-22 poll; the gauge↔SOC curve is `SOC% ≈
  7.07·bars + 19.6` (r = 0.999). The floor engages at 30 % (mid-2-bar) and
  latches for the rest of the key cycle. This unblocked the armed reconciler.
- **Ignition on/off → `0x3ED` presence** (Session 14, 2026-09-19). Present
  with a constant payload while the ignition is on; the whole ID vanishes,
  including through the RAP window, the instant it goes off. A
  `SafetyGate._precondition_failure()` precondition for both the reconciler
  and manual `set-mode`, closing the gap Session 13 found.

### Still open

- **Drop the poll for a passive signal.** The `22 005B` poll works but it is
  an active TX on the vehicle bus every 10 s; a passive broadcast field would
  be cleaner. `0x096` byte 3 (the failsafe proxy) is far too coarse
  (~13 % SOC/count). The three broadcast candidates found in field captures — `0x3E3` bytes
  0/1/6, `0x228` byte 2, `0x186` byte 6 — still have no raw→% scaling anchor;
  the running trip logs (SOC % vs. each candidate raw, stamped every line by
  `soc_log.py`) are the data set to calibrate one against and eventually
  retire the poll.
- **Validate the 33 / b3≤9 timing on the road.** Watch the trip logs over
  several drives — does the floor engage early enough that the pack never
  reaches the 1→0 bar cliff, and does the b3 failsafe hold if a poll gap
  lands at the wrong moment.
- **Measure `0x3ED`'s transmit period.** Session 14 (2026-09-19) confirmed
  `0x3ED` presence as the real ignition-state signal (see the "Known CAN
  signals" table and `docs/field-session-log.md` Session 14) and wired it
  into `SafetyGate._precondition_failure()`, but its own frame rate wasn't
  captured before the Pi dropped off the network mid-session.
  `IGNITION_QUIET_TIMEOUT_S` (`voltdmf/state.py`) currently borrows
  `BUS_QUIET_TIMEOUT_S` (2.0 s) as a placeholder — tighten or loosen once a
  real rate is measured.

### Deferred (not blocking)

- **Drive-mode persistence across ignition cycles.** Off the critical path
  under the reconciler (it reads the live mode from `0x1F4` and converges from
  any starting mode). Still mildly interesting for tuning the first-pass delay
  — `tools/ignition_check.py`, whenever it's convenient.

### Stretch goal — force 12 A Level 1 charging

Not part of the drive-mode mission; a low-risk add-on that would reuse the
same bus tap and the same arm-gated injector safety wrapper.

The center-stack setting that raises 120 V charging from **8 A to 12 A** can
be changed at any time (even while driving), but **reverts to 8 A every time
the car leaves Park** — GM's guard against an unknown / marginal wall circuit.
The owner only ever charges on a known-good home circuit, so the revert is
pure friction; the goal is to make the car *always* Level-1-charge at 12 A.

Approach: detect the Park-exit revert (or just assert continuously) and
re-send the "12 A" setpoint frame so the faster rate always sticks.

Unknowns, all answerable from **one capture**: the setpoint frame ID / byte /
encoding (likely `0x08`↔`0x0C` amps, or `0x28`↔`0x3C` in the 0.2 A units OVMS
documents for charger telemetry on `0x5EC`), whether it carries a rolling
counter / checksum, and whether the HMI re-asserts fast enough to need
continuous TX vs a single post-revert shot. Discovery is a **standalone
garage session** — car in READY and Park, toggle the menu setting while
capturing, no drive and no discharged pack needed — see
`docs/phase-c-field-checklist.md` §2e. A P→R→P shift in the garage exercises
the forced 8 A revert; it lands on the same timestamp as `0x1F5` byte 3
leaving `0x01` (Park), a free labeled edge for the offline analysis.

Safety: 12 A at 120 V is 1.44 kW — within the car's own menu option and the
Lear charger's ~12.7 A ceiling. The only real-world caveat (the wall circuit
being rated for 12 A continuous) is one the owner controls by only ever
plugging in at home. No safety-of-motion dimension. It is still a bus TX, so
it goes through the same arm gate, error-frame watch, and DTC scan as
mode injection.

## Sources

- [vix597/chevy-volt-trip-mode](https://github.com/vix597/chevy-volt-trip-mode)
- [seanlaplante.com writeup](https://seanlaplante.com/2021/11/13/hacking-my-chevy-volt-to-auto-switch-driving-modes-for-efficiency/)
- [commaai/opendbc](https://github.com/commaai/opendbc)
- [PiCAN2 (SK Pang Electronics)](https://www.skpang.co.uk/products/pican2-can-bus-board-for-raspberry-pi-2-3)
- [skpang/PiCAN-Python-examples](https://github.com/skpang/PiCAN-Python-examples)
- [Raspberry Pi Overlay File System (read-only root)](https://learn.adafruit.com/read-only-raspberry-pi/overview)
- [OVMS voltampera_canbusnotes.txt](https://github.com/openvehicles/Open-Vehicle-Monitoring-System/blob/master/vehicle/Car%20Module/VoltAmpera/voltampera_canbusnotes.txt)
- [GM Volt Reverse Engineering Wiki](https://vehicle-reverse-engineering.fandom.com/wiki/GM_Volt)
- [GM-Volt.com OBD2 FAQ](https://www.gm-volt.com/threads/obd2-obdii-obd-ii-device-faq.110641/)
- [Understanding the openpilot Safety Model](https://blog.comma.ai/understanding-the-openpilot-safety-model/)
