mlh5599/volt-drive-mode-fixer/voltdmf/canio.py

"""SocketCAN I/O: the RX decode loop and the transmit paths.

Exactly two functions in this whole project put a frame on the bus, each
hard-coding its one address and payload:

* :meth:`CanInterface.send_mode_button_press` -- the drive-mode button tap on
  0x1E1. Gated: only transmits while the daemon is armed.
* :meth:`CanInterface.send_soc_poll` -- one ``22 005B`` UDS request. Ungated:
  it is a read, runs armed or disarmed, and every drive wants ground-truth
  SOC.

There is no "send arbitrary frame" path anywhere (DESIGN.md "Safety model").
"""

from __future__ import annotations

import logging
import time
from typing import Callable

import can

from . import signals
from .signals import SIGNAL_IDS, DriveMode
from .state import VehicleState

log = logging.getLogger(__name__)

# --- The one message this project is allowed to transmit -------------------
#
# Confirmed 2026-08-29 on-vehicle: on the Gen 1 HS-CAN (500k) the drive-mode
# button and the current-mode status share arbitration ID 0x1F4. The body
# module streams `00 <mode> 00 00 00 00` at ~40 Hz (byte 1 = latched mode).
# The mode latches ~2-3 s after the last press.
#
# (An earlier revision of this note claimed a physical tap sets 0x1F4 byte 5
# to 0x80 and then "ramps" byte 4 80->40->20 while held. That was a
# misreading: bytes 4+5 are the MENU CURSOR, and the "ramp" was the cursor
# advancing NORMAL->SPORT->MOUNTAIN->HOLD under the cluster's key-repeat.
# See the 0x1F4 block comment in signals.py.)
#
# Two different IDs:
#   MODE_STATUS_ADDR 0x1F4 -- body module streams `00 <mode> 00 00 <cursor>
#     <cursor>` at ~40 Hz; byte 1 = latched mode. READ ONLY (read_drive_mode).
#   MODE_BUTTON_ADDR 0x1E1 -- "ASCMSteeringButton". byte 4 bit 7 = drive-mode
#     button pressed. This is what we TRANSMIT. Confirmed session 2
#     (2026-08-29): during a physical press 0x1E1 byte 4 goes 00/01/02/03 ->
#     80/81/82/83 (low bits are a rolling counter; bit 7 is the press flag).
#     Same ID/bit/payload the Gen 2 prior art (vix597/chevy-volt-trip-mode)
#     injects successfully.
#
# Injection model: TRACKING ECHO PRESS.
# 0x1E1 is NOT a static frame here. byte 4 low 2 bits are a rolling counter,
# bytes 5-6 are a counter-derived tail, and the module streams the frame at
# ~40 Hz. A captured *physical* press (session 2, 2026-08-29) is ~14
# consecutive frames with byte 4 bit 7 set, the counter still advancing
# normally (..83 82 81 80..), then bit 7 clears -- ~350 ms total.
#
# We deliberately do NOT replay all ~14: that captured press was long enough
# to trigger the cluster's key-repeat (~50 ms period) and walk the menu
# several rows. A discrete single-step press is ONE frame -- see
# PRESS_TRACK_FRAMES for the on-vehicle numbers. (A human holding the button
# gets key-repeat too; they just watch the menu and let go.)
#
# For PRESS_TRACK_FRAMES iterations we wait for the
# module's next live 0x1E1, OR 0x80 into its byte 4, and send that back into
# the ~24 ms gap before the module's next frame. Every injected frame carries
# the module's current counter + tail (only bit 7 differs), and it lands
# *between* module frames rather than colliding with one -- so the cluster's
# ~40 Hz poll sees a clean run of "pressed" frames with a valid advancing
# counter, then a release edge when we stop. The caller leaves >=
# RELEASE_GAP_S of silence before the next press.
#
# What did NOT work (session 2, on-vehicle): the wrong ID (0x1F4, a status
# echo); time.sleep()-paced 0x1E1 that collided with the module (TEC ->
# ERROR-PASSIVE); a static 0x1E1 frame with a frozen counter (ignored / only
# woke the menu); and a blind back-to-back blast of a frozen echo frame --
# long blasts get punched through by module frames at random points, so the
# cluster saw an unpredictable 0-2 presses per burst.
#
# This menu takes a wake press first: from an idle menu, press 1 only opens
# it -- and it always opens with the cursor on NORMAL regardless of the
# current mode (confirmed 2026-09-03; this is why presses_to_reach is
# index(target)+1 from any mode). Spacing presses ~1.4 s apart registers each
# one cleanly and stays inside the ~3 s menu-open window. Both are the
# caller's problem (ModeCycleController), not this function's.
#
# (An earlier note here claimed the cluster rate-limits to ~5 s and ignores
# presses ~2 s apart. That was an artifact of the old 16-frame press: those
# were being key-repeated into multi-row jumps, not ignored. At 1 frame,
# 1.4 s spacing is reliable -- measured on-vehicle 2026-09-03.)
#
# Injection efficacy is on-road-confirmed: the tracking-echo press drove a
# closed-loop walk to all four modes (2026-08-29, see the 0x1E1 note in
# signals.py). tools/inject_test.py remains the bench harness for the TX path.
MODE_STATUS_ADDR = 0x1F4
MODE_BUTTON_ADDR = 0x1E1
PRESS_BYTE4 = 0x80               # 0x1E1 byte 4 bit 7 = button pressed
# Frames with bit 7 set per logical press. MUST be exactly 1: the cluster
# key-REPEATS a held button roughly every 50 ms, so any longer run of
# "pressed" frames walks the menu extra rows on what the caller thinks is one
# tap. Measured on-vehicle 2026-09-03 with tools/press_calibrate.py:
#     16 frames -> ~5-6 steps per tap   (the old value; the dominant bug)
#      8 frames -> 2 steps
#      2 frames -> 1 step, but DOUBLE-steps ~1 run in 8 (3/24 across all
#                  sessions; caught live by the probe sampler, which logged
#                  the cursor going mountain -> hold 51 ms apart on one tap)
#      1 frame  -> 1 step, 22/22, never a double
# 1 frame does occasionally get DROPPED (~5-10%: 1/22 isolated presses, and
# 1 of 10 presses in a back-to-back walk). That is the right failure to have.
# A dropped tap is visible to ``ModeCycleController._walk_closed_loop`` -- the
# cursor simply did not move -- and costs one extra tap out of MAX_WALK_TAPS
# (12, against a 4-tap worst-case walk), while the loop's 1.6 s per iteration
# stays inside the ~3 s menu-open window so nothing commits early. An
# overshoot is not recoverable in the same way: it commits the WRONG mode.
# So: never overshoot, let the closed loop absorb the drops.
PRESS_TRACK_FRAMES = 1
_TRACK_FRAME_TIMEOUT_S = 0.1    # give up waiting for the next live 0x1E1
RELEASE_GAP_S = 0.75            # min silence after a press = the "button up"
                                # (reference project's BUTTON_PRESS_COOLDOWN)
_TX_SEND_TIMEOUT_S = 0.1        # let python-can wait for a TX slot instead of
                                # raising "Transmit buffer full" immediately

# Back-compat: the old blast knobs some callers/tests still poke.
PRESS_FRAME_INTERVAL_S = 0.0
PRESS_BURST_FRAMES = PRESS_TRACK_FRAMES

#: Fallback 0x1E1 "button down" payload (no live counter) -- matches
#: vix597/chevy-volt-trip-mode's PRESS_MSG. Used only if no live 0x1E1 can be
#: read at all; the cluster has been seen to ignore this on the Gen 1.
_STATIC_PRESS_PAYLOAD = bytes((0x00, 0x00, 0x00, 0x00, PRESS_BYTE4, 0x00, 0x00))

#: Frames per logical press (compat alias for callers/tests).
SEND_CLUSTER_SIZE = PRESS_TRACK_FRAMES


class CanInterface:
    def __init__(
        self,
        channel: str = "can0",
        *,
        tx_gate: Callable[[], bool] | None = None,
    ) -> None:
        self._channel = channel
        # Runtime transmit enable, checked live on every button press. This is
        # the toggle the control socket's arm/disarm flips -- the project's one
        # and only TX lock now (``--dry-run`` is gone). When it returns False
        # ``send_mode_button_press`` logs the intended press and transmits
        # nothing. ``send_soc_poll`` ignores this -- a poll is a read.
        self._tx_gate = tx_gate
        self._bus: can.BusABC | None = None
        self._notifier: can.Notifier | None = None
        #: Second socket, filtered to 0x1E1, dedicated to the tracking-echo
        #: press -- see :meth:`open`.
        self._echo_bus: can.BusABC | None = None

    def _tx_suppressed(self) -> bool:
        return self._tx_gate is not None and not self._tx_gate()

    # -- lifecycle --------------------------------------------------------
    def open(self) -> None:
        self._bus = can.Bus(interface="socketcan", channel=self._channel)
        # SECOND socket for the press path. SocketCAN delivers every frame to
        # every socket bound to the interface, so this costs nothing and buys
        # two things the shared socket could not give at once:
        #
        #   * no contention -- a Notifier on ``_bus`` (the daemon) and a
        #     ``recv()`` here are no longer pulling from the same queue, where
        #     each frame goes to exactly one of them.
        #   * freshness -- the echo must mirror the module's CURRENT counter.
        #     Taking it from the Notifier's decoded state instead was tried
        #     (71f0fc3) and was WORSE, 36% dropped taps against 21%: the
        #     listener thread lags on a busy Global A bus, so the frame it had
        #     stashed was often already stale and the cluster ignored the echo
        #     exactly like the frozen-counter frame in session 2.
        #
        # The hardware filter means this socket only ever queues 0x1E1, so a
        # recv() here returns the newest button frame with minimal latency.
        # ``receive_own_messages`` stays False (python-can's default) so our
        # own injected frames never come back and get mistaken for the
        # module's.
        self._echo_bus = can.Bus(
            interface="socketcan", channel=self._channel,
            can_filters=[{"can_id": MODE_BUTTON_ADDR, "can_mask": 0x7FF}])
        log.info("opened %s (+ 0x%03X-filtered echo socket)",
                 self._channel, MODE_BUTTON_ADDR)

    def start_rx(self, state: VehicleState) -> None:
        if self._bus is None:
            raise RuntimeError("open() first")
        # The Notifier takes over ``_bus``. The press path is unaffected: it
        # lives on ``_echo_bus``, its own socket.
        self._notifier = can.Notifier(self._bus, [_DecodeListener(state)])

    def close(self) -> None:
        if self._notifier is not None:
            self._notifier.stop()
            self._notifier = None
        if self._echo_bus is not None:
            self._echo_bus.shutdown()
            self._echo_bus = None
        if self._bus is not None:
            self._bus.shutdown()
            self._bus = None

    def __enter__(self) -> "CanInterface":
        self.open()
        return self

    def __exit__(self, *exc) -> None:
        self.close()

    # -- observation helpers (used by the injection test) ---------------
    def _latest_status(self, decode, timeout: float) -> DriveMode | None:
        """Newest decodable 0x1F4 currently in the RX queue.

        ``recv()`` hands back the OLDEST queued frame first, and this socket
        buffers 0x1F4 at ~40 Hz the whole time ``send_mode_button_press()``
        runs (that path only drains 0x1E1). Returning the first 0x1F4 we see
        gives the caller a reading that can be >1 s stale -- enough to desync
        the closed-loop walk: it read "SPORT" while the cursor had already
        stepped to MOUNTAIN (field session 3, 2026-08-29). So block up to
        ``timeout`` for the first hit, then sweep the rest of the queue
        non-blocking and keep only the newest.
        """
        if self._bus is None:
            raise RuntimeError("open() first")
        end = time.time() + timeout
        latest: DriveMode | None = None
        while True:
            wait = 0.0 if latest is not None else max(0.0, end - time.time())
            msg = self._bus.recv(timeout=wait)
            if msg is None:
                if latest is not None or time.time() >= end:
                    return latest
                continue
            if msg.arbitration_id != MODE_STATUS_ADDR:
                continue
            decoded = decode(bytes(msg.data))
            if decoded is not None:
                latest = decoded

    def read_drive_mode(self, timeout: float = 1.0) -> DriveMode | None:
        """Return the *committed* drive mode (0x1F4 byte 1 -- lags a menu
        commit by ~3 s), from the newest frame in the RX queue."""
        return self._latest_status(signals.decode_drive_mode, timeout)

    def read_menu_cursor(self, timeout: float = 0.5) -> DriveMode | None:
        """Return the LIVE drive-mode menu cursor (0x1F4 bytes 4+5 -- steps
        ~40 ms after each button tap; see ``signals.decode_menu_cursor``),
        from the newest frame in the RX queue. Used to close the loop on a
        walk, so it MUST be current -- see :meth:`_latest_status`.

        NOTE ``_latest_status`` keeps only frames that *decode*, so a closed
        menu (cursor ``None``) is skipped rather than returned here. That is
        right for this caller -- it polls for the cursor to reach a target --
        but it is why the daemon's closed loop reads ``state.menu_cursor``
        instead, which does see the menu close."""
        return self._latest_status(signals.decode_menu_cursor, timeout)

    # -- the only transmit path ----------------------------------------
    def _next_button_frame(self, timeout: float) -> bytes | None:
        """Block up to ``timeout`` for the module's NEXT live 0x1E1 (>=7 B).

        Reads the dedicated ``_echo_bus`` socket, which is hardware-filtered to
        0x1E1 (see :meth:`open`). Nothing else consumes that socket, so this
        never races the daemon's Notifier and always returns a CURRENT frame --
        the echo has to carry the module's current counter or the cluster
        ignores it.

        DRAINS the queue first, then blocks for the next arrival. Both halves
        are load-bearing. Nothing reads this socket between taps, so during the
        walk's ~1.6 s inter-tap gap it silently accumulates a backlog, and
        ``recv()`` hands back the OLDEST frame in it. Measured on-vehicle
        2026-09-04, 0x1E1 at ~32 Hz:

            idle 0.0 s -> first recv is fresh,     0 frames queued behind it
            idle 0.2 s -> first recv  170 ms old,  5 queued
            idle 0.8 s -> first recv  791 ms old, 26 queued
            idle 1.6 s -> first recv 1582 ms old, 52 queued

        A 1.6 s-old counter is ~52 counts behind the module: exactly the
        frozen-counter echo the cluster ignored in session 2. That is why the
        walk saw the menu refuse to open for 11 straight taps. After the drain
        the returned frame is at most one frame period (~31 ms) old.
        """
        bus = self._echo_bus
        if bus is None:
            raise RuntimeError("open() first")
        while bus.recv(timeout=0.0) is not None:
            pass                      # discard the idle backlog; all stale
        end = time.time() + timeout
        while time.time() < end:
            msg = bus.recv(timeout=max(0.0, end - time.time()))
            if msg is not None and len(msg.data) >= 7:
                return bytes(msg.data)
        return None

    def send_mode_button_press(self) -> None:
        """Inject ONE logical button press on 0x1E1: a tracking echo press.

        For PRESS_TRACK_FRAMES iterations: wait for the module's next live
        0x1E1, OR 0x80 into its byte 4, and send that straight back into the
        ~24 ms gap before the module's next frame. The result on the wire is
        ~PRESS_TRACK_FRAMES frames with bit 7 set and the counter still
        advancing normally -- a replica of the captured ~14-frame physical
        press -- followed by a release edge when we stop. No collisions with
        the module (we transmit between its frames, not on top of them).

        The caller MUST leave >= RELEASE_GAP_S of silence before the next
        press, must send a wake press first if the menu is idle, and must
        space presses ~5 s apart (the cluster rate-limits) -- see the module
        comment. The car commits the new mode ~2-3 s later.
        """
        if self._tx_suppressed():
            log.info("[disarmed] would inject 0x1E1 press: track module + "
                     "byte4|=0x%02x x%d, then stop TX for >=%.2fs",
                     PRESS_BYTE4, PRESS_TRACK_FRAMES, RELEASE_GAP_S)
            return
        if self._echo_bus is None:
            raise RuntimeError("open() first")
        sent = misses = 0
        for _ in range(PRESS_TRACK_FRAMES):
            base = self._next_button_frame(_TRACK_FRAME_TIMEOUT_S)
            if base is None:
                misses += 1
                if misses > 3:
                    break  # bus went quiet -- stop rather than spin
                continue
            buf = bytearray(base)
            buf[4] |= PRESS_BYTE4
            frame = can.Message(arbitration_id=MODE_BUTTON_ADDR,
                                data=bytes(buf), is_extended_id=False)
            try:
                self._echo_bus.send(frame, timeout=_TX_SEND_TIMEOUT_S)
            except can.CanError as exc:
                log.warning("0x1E1 press: TX backpressure after %d/%d (%s)",
                            sent, PRESS_TRACK_FRAMES, exc)
                time.sleep(0.005)
                continue
            sent += 1
        if sent == 0:
            log.warning("0x1E1 press: no live frame to track -- sending static "
                        "fallback once (cluster may ignore it)")
            try:
                self._echo_bus.send(
                    can.Message(arbitration_id=MODE_BUTTON_ADDR,
                                data=_STATIC_PRESS_PAYLOAD, is_extended_id=False),
                    timeout=_TX_SEND_TIMEOUT_S)
            except can.CanError:
                pass
        else:
            log.debug("0x1E1 press: %d/%d tracked frames on the wire",
                      sent, PRESS_TRACK_FRAMES)
        # No explicit release frame -- the module's own bit-7-clear stream is it.

    def send_soc_poll(self, req_id: int) -> None:
        """Transmit ONE ``22 005B`` UDS request -- the only other frame this
        project puts on the bus.

        A fixed 8-byte ISO-TP single frame (``03 22 00 5B 55 55 55 55``) to
        ``req_id``. The caller cycles 0x7E4 / 0x7E0 until an ECU answers, then
        pins the id that did. Runs regardless of arm state -- a poll is a read,
        and every drive wants ground-truth SOC. Stays in the default
        diagnostic session, service 0x22 only (no session control, no
        TesterPresent), so it never suppresses the normal broadcasts.
        """
        if self._bus is None:
            raise RuntimeError("open() first")
        frame = can.Message(arbitration_id=req_id,
                            data=signals.uds_soc_request_payload(),
                            is_extended_id=False)
        try:
            self._bus.send(frame, timeout=_TX_SEND_TIMEOUT_S)
        except can.CanError as exc:
            log.warning("SOC poll: TX failed for 0x%03X (%s)", req_id, exc)


class _DecodeListener(can.Listener):
    """Decodes the handful of known frames into the shared VehicleState."""

    def __init__(self, state: VehicleState) -> None:
        self._state = state
        self._speed_addr = SIGNAL_IDS["speed"].addr
        self._shift_addr = SIGNAL_IDS["shift"].addr  # 0x1F5 (0x135 not decoded)
        self._status_addr = MODE_STATUS_ADDR  # 0x1F4 byte 1 = committed mode

    def on_message_received(self, msg: can.Message) -> None:
        addr = msg.arbitration_id
        if not signals.is_signal_frame(addr):
            return
        data = bytes(msg.data)
        if addr == signals.SOC_BAR_ADDR:  # 0x096 -- coarse passive SOC proxy
            raw = signals.decode_soc_bar_raw(data)
            if raw is not None:
                self._state.soc_bar_raw = raw
        elif signals.UDS_RESP_ID_LO <= addr <= signals.UDS_RESP_ID_HI:
            self._ingest_uds_soc(addr, data)
        elif addr == self._speed_addr:
            mph = signals.decode_speed_mph(data)
            if mph is not None:
                self._state.speed_mph = mph
        elif addr == self._shift_addr:  # 0x1F5 byte 3 = PRNDL
            self._state.shift = signals.decode_shift(data)
        elif addr == signals.ENGINE_STATE_ADDR:  # 0x4C5 b2 = engine run state
            self._state.engine_state = signals.decode_engine_state(data)
        elif addr == signals.ENGINE_RUN_COUNTER_ADDR:  # 0x3F9 b1-2 = run counter
            counter = signals.decode_engine_run_counter(data)
            if counter is not None:
                self._state.note_engine_run_counter(counter)
        elif addr == signals.IGNITION_ADDR:  # 0x3ED presence = ignition on
            self._state.mark_ignition_seen()
        elif addr == self._status_addr:  # 0x1F4 byte 1 = committed drive mode
            mode = signals.decode_drive_mode(data)
            if mode is not None:
                self._state.drive_mode = mode
            # Bytes 4+5 = the LIVE menu cursor (steps ~40 ms after each tap),
            # or None while the menu is closed. Assign UNCONDITIONALLY: the
            # None is real information -- it tells the closed-loop walk the
            # menu has shut, and latching the last cursor instead would let a
            # stale value match the target and stop a walk early.
            self._state.menu_cursor = signals.decode_menu_cursor(data)
            # Diagnostics only (walk-test per-tap trace): the raw byte-4/5
            # codes, kept even when they decode to nothing. Neither drives the
            # closed loop.
            if len(data) >= 6:
                self._state.menu_cursor_raw = data[4]
                self._state.menu_open_hint = signals.menu_is_open(data)
        # 0x135 is a known signal frame (keeps mark_signal_seen fresh) but its
        # shifter encoding is messier than 0x1F5 -- not decoded.
        self._state.mark_signal_seen()

    def _ingest_uds_soc(self, addr: int, data: bytes) -> None:
        """Fold a 0x7E8..0x7EF frame (our ``22 005B`` poll reply) into state."""
        kind, raw = signals.decode_uds_soc(data)
        if kind == "ok" and raw is not None:
            self._state.soc_raw = raw
            self._state.soc_percent = signals.uds_soc_percent(raw)
            self._state.soc_percent_monotonic = time.monotonic()
            self._state.soc_source = "poll"
            self._state.uds_resp_id = addr
            self._state.uds_replies += 1
        elif kind == "nrc":
            self._state.uds_nrcs += 1
