mlh5599/volt-drive-mode-fixer/voltdmf/lcddash.py

"""The idle *watch* screen the daemon paints on the LCD.

When the daemon is up and nothing else has claimed the panel (see
:mod:`voltdmf.lcdlock`), a background thread mirrors a small status screen
to the SparkFun 4x20:

    +--------------------+
    |ACTIVE -            |
    |sel 1/4 HOLD-SOC    |
    |gear D  DM MOUNTAIN |
    |SOC       84.3%     |
    +--------------------+

Row 0  the live bus state, spelled out in full (see :func:`bus_label`):
       ACTIVE spins a trailing tick so a hung watch thread would visibly
       stop, WARNING/BUS-OFF blink so a fault is something you notice.
Row 1  the VDMF selector: which of the four SW1 detents is live, and
       whether the SOC-HOLD floor has latched on top of it. Right after a
       SW1 tap this instead flashes the newly-picked setting (``-> LABEL``)
       for ``SELECTOR_FLASH_S``, then settles back to the steady-state line.
Row 2  committed drive mode (0x1F4 byte 1, labelled DM) + PRNDL gear
       (0x1F5 byte 3).
Row 3  diag SOC % from the 22 005B poll -- the one number the instrument
       cluster never shows. A trailing ``~`` marks a % that is not a live
       poll reading (poll gone stale, or the coarse bar failsafe took over).
       Right-aligned after it: ``ICE`` while the range-extender is running,
       or ``NO HOLD`` when it is running on a spent pack, which is the state
       in which the car stops offering HOLD and the daemon stops asking --
       or ``GAVE UP`` when a walk was tried and the mode would not take.

Everything here is fail-soft: the thread never raises into the daemon, a
missing / unusable serial port just means the screen stays dark, and a
purpose-driven tool taking :func:`voltdmf.lcdlock.hold` makes the thread
close the port and wait rather than fight for it.
"""

from __future__ import annotations

import logging
import re
import subprocess
import threading
import time

from . import lcdlock
from .lcd import SerLcd
from .signals import DriveMode, ShiftPosition
from .state import VehicleState

log = logging.getLogger(__name__)

#: SocketCAN "can state <x>" -> the full word :func:`bus_label` shows.
_BUS_WORD = {
    "ERROR-ACTIVE": "ACTIVE", "ERROR-WARNING": "WARNING",
    "ERROR-PASSIVE": "PASSIVE", "BUS-OFF": "BUS-OFF", "STOPPED": "STOPPED",
}
_GEAR_LETTER = {
    ShiftPosition.PARK: "P", ShiftPosition.REVERSE: "R",
    ShiftPosition.NEUTRAL: "N", ShiftPosition.DRIVE: "D",
    ShiftPosition.LOW: "L", ShiftPosition.UNKNOWN: "?",
}

_SPINNER = "-\\|/"
#: A fault should catch the eye, not blend into the row -- these blink.
_BLINKING_TAGS = ("WARNING", "BUS-OFF")

#: How often the thread repaints, and how often it forces a full refresh
#: (to recover a panel that browned out under us).
_REPAINT_S = 2.0
_REFRESH_EVERY = 15


def can_state(channel: str) -> str:
    try:
        out = subprocess.run(["ip", "-details", "link", "show", channel],
                             capture_output=True, text=True, timeout=3).stdout
    except (OSError, subprocess.SubprocessError):
        return "?"
    m = re.search(r"can state (\S+)", out)
    return m.group(1) if m else "?"


def _bus_tag(channel: str, state: VehicleState) -> str:
    if not state.bus_active:
        return "QUIET"
    if not state.ignition_on:
        # Bus alive, ignition confirmed off (0x3ED gone) -- the RAP window
        # (Session 13/14). Distinct from QUIET: this is the exact state that
        # used to read as ACTIVE and let the reconciler try to walk the menu.
        return "RAP"
    raw = can_state(channel)
    return _BUS_WORD.get(raw, raw)


def bus_label(tag: str, ticks: int) -> str:
    """Full word for a bus tag from :func:`_bus_tag`, animated.

    ACTIVE gets a spinning suffix -- a heartbeat that a hung watch thread
    would visibly stop, unlike static text. WARNING/BUS-OFF blink the whole
    word instead, so a fault is something you notice, not read.
    """
    if tag == "ACTIVE":
        return "ACTIVE" + _SPINNER[ticks % len(_SPINNER)]
    if tag in _BLINKING_TAGS and ticks % 2:
        return ""
    return tag or "?"


def _soc_label(state: VehicleState) -> str:
    if state.soc_percent is None:
        return "--"
    return f"{state.soc_percent:.1f}%"


def _status_tag(state: VehicleState, ice_blocked: bool,
                gave_up: bool = False) -> str:
    """Right-hand tag for the SOC row: why the device is or is not acting.

    Most specific first, because only one fits in the row:

    * ``NO HOLD`` -- the engine is running on a spent pack, so the car is not
      offering HOLD and the device is deliberately not reaching for it. The
      one the driver actually needs.
    * ``GAVE UP`` -- the walk was tried and did not take (see
      :class:`voltdmf.safety.AttemptBudget`); the device has stopped asking
      until the driver taps SW1 or the car reaches the mode by itself.
    * ``ICE`` -- the benign case: engine on, HOLD still on the menu (or
      already engaged).
    """
    if ice_blocked:
        return "NO HOLD"
    if gave_up:
        return "GAVE UP"
    return "ICE" if state.engine_running else ""


def render_screen(state: VehicleState, *, bus_label: str, position_label: str,
                  position_index: int, cycle_len: int, floor_latched: bool,
                  soc_fresh: bool, ice_blocked: bool = False,
                  gave_up: bool = False, flashing: bool = False) -> list[str]:
    """Compose the four watch-screen rows. Pure -- easy to unit-test.

    ``bus_label`` is a resolved string, not the :func:`bus_label` function --
    the caller resolves the tag and animation tick before calling this.
    ``soc_fresh`` marks the displayed % with ``~`` when it is not a live
    poll reading (stale poll, or the coarse bar failsafe took over) -- the
    number stays on screen either way, but a stale one should not be trusted
    the way a live one is. ``flashing`` swaps the selector row for a "new
    setting" confirmation right after a SW1 tap -- the caller (the daemon)
    owns the timeout, this just draws whichever state it's told.
    """
    mode = state.drive_mode.value.upper() if state.drive_mode else "no 1F4"
    gear = _GEAR_LETTER.get(state.shift, "?")
    if flashing:
        sel = f"-> {position_label.upper()}"
    else:
        sel = f"sel {position_index}/{cycle_len} {position_label.upper()}"
        if floor_latched:
            sel += " FLR"
    stale_mark = "" if (state.soc_percent is None or soc_fresh) else "~"
    soc_row = f"SOC {_soc_label(state):>6}{stale_mark}"
    tag = _status_tag(state, ice_blocked, gave_up)
    if tag:
        soc_row = f"{soc_row}{tag:>{20 - len(soc_row)}}"
    rows = [
        bus_label,
        sel,
        f"gear {gear}  DM {mode}",
        soc_row,
    ]
    return [r[:20] for r in rows]


def _default_selector() -> dict:
    return {"label": "--", "index": 0, "floor_latched": False,
            "soc_fresh": False, "ice_blocked": False, "gave_up": False,
            "flashing": False}


class LcdDashboard:
    """Background thread that paints :func:`render_screen` on a real LCD.

    Parameters
    ----------
    state:        the shared :class:`VehicleState` the RX loop updates.
    selector_fn:  ``() -> dict`` with ``label``, ``index``, ``floor_latched``
                  -- the daemon's live reconciler position. Defaults to a
                  placeholder so callers that don't care (most tests) don't
                  have to supply one.
    """

    def __init__(self, state: VehicleState, *, selector_fn=None,
                 channel: str = "can0", port: str = "/dev/serial0",
                 baud: int = 9600, backlight: int = 45,
                 interval: float = _REPAINT_S, dry_run: bool = False) -> None:
        self._state = state
        self._selector_fn = selector_fn or _default_selector
        self._channel = channel
        self._lcd_kwargs = dict(port=port, baud=baud, backlight=backlight,
                                dry_run=dry_run)
        self._interval = interval
        self._stop = threading.Event()
        self._thread: threading.Thread | None = None
        self._lcd: SerLcd | None = None
        self._yielded = False
        self._open_warned = False

    # -- lifecycle -----------------------------------------------------
    def start(self) -> None:
        self._thread = threading.Thread(target=self._run, name="lcd-dash",
                                        daemon=True)
        self._thread.start()
        log.info("LCD watch screen thread started (port %s)",
                 self._lcd_kwargs["port"])

    def stop(self) -> None:
        self._stop.set()
        if self._thread is not None:
            self._thread.join(timeout=3.0)
        if self._lcd is not None:
            try:
                self._lcd.lines("VOLT DMF", "daemon stopped", "", "")
            except OSError:
                pass
            self._close_lcd()

    # -- internals ---------------------------------------------------------
    def _open_lcd(self) -> bool:
        if self._lcd is not None:
            return True
        try:
            self._lcd = SerLcd(**self._lcd_kwargs).open()
            self._lcd.lines("VOLT DMF", "starting up...", "", "")
            self._open_warned = False
            return True
        except OSError as exc:
            if not self._open_warned:
                log.warning("LCD unavailable (%s); watch screen idle, retrying",
                            exc)
                self._open_warned = True
            self._lcd = None
            return False

    def _close_lcd(self) -> None:
        if self._lcd is not None:
            try:
                self._lcd.close()
            finally:
                self._lcd = None

    def _run(self) -> None:
        ticks = 0
        while not self._stop.is_set():
            try:
                self._tick(ticks)
            except Exception:  # never take the daemon down
                log.exception("LCD watch tick failed; backing off 5s")
                self._close_lcd()
                self._stop.wait(5.0)
            ticks += 1
            self._stop.wait(self._interval)

    def _tick(self, ticks: int) -> None:
        if lcdlock.is_held_by_other():
            if self._lcd is not None or not self._yielded:
                log.info("LCD claimed by another process; releasing the panel")
            self._close_lcd()
            self._yielded = True
            return
        if self._yielded:
            log.info("LCD free again; resuming the watch screen")
            self._yielded = False
        if not self._open_lcd():
            return
        sel = self._selector_fn()
        rows = render_screen(
            self._state,
            bus_label=bus_label(_bus_tag(self._channel, self._state), ticks),
            position_label=sel["label"],
            position_index=sel["index"],
            cycle_len=sel.get("cycle_len", 4),
            floor_latched=sel["floor_latched"],
            soc_fresh=sel.get("soc_fresh", False),
            ice_blocked=sel.get("ice_blocked", False),
            gave_up=sel.get("gave_up", False),
            flashing=sel.get("flashing", False),
        )
        for i, text in enumerate(rows):
            self._lcd.line(i, text)
        if ticks % _REFRESH_EVERY == 0:
            self._lcd.refresh()
