mlh5599/volt-drive-mode-fixer/tools/soc_log.py

#!/usr/bin/env python3
"""Unattended SOC-discovery drive log. Passive by default; one opt-in poll.

The Gen 1 dash shows no state-of-charge percentage, only EV range (miles)
and a 10-increment battery gauge, so SOC cannot be read off one frame
directly. This tool does the only thing that works: capture the whole bus
for a long drive that takes the pack from full to well down, record when
each gauge increment drops, then find the monotonically-falling field
offline with ``tools/mine_capture.py --monotonic`` and anchor it to those
drops.

Session 8 narrowed the broadcast SOC field to three energy-linked
candidates (``0x3E3`` b0/b1/b6, ``0x228`` b2, ``0x186`` b6) but logged no
reading at a known SOC, so none could be scaled. This tool now stamps
those candidate raw values on every log line, so a Session-9 anchor drive
(full charge -> idle -> steady drive -> HOLD) calibrates them straight
from the capture. ``--diag-soc`` additionally polls the diagnostic charge
PID for a continuous ground-truth percent -- that is the one transmit
path; everything else is read-only.

What it does (read-only unless ``--diag-soc`` is given):

  * spawns ``candump -l`` for the entire session -> ``candump-<ts>.log``
    (this is the actual data; everything else just helps you align it)
  * writes its own event log -> ``~/vdmf-soclog-<ts>.log`` on a shared
    ``t+<seconds>`` clock
  * two panel buttons on the Pi's GPIO (``--buttons``) track the battery
    gauge hands-free -- no voice memo needed:
        A  = gauge just dropped one increment   (10 -> 9 -> 8 ...)
        B  = gauge went back up one             (regen bump, or undo an
             accidental A press)
    the tool keeps the running level, so every log line carries the
    absolute reading (``level=7/10``). Hold BOTH for ``--stop-hold`` s to
    end the session cleanly without SSH.
  * every ``--mark-every`` s also logs a plain ``SOC-MARK`` time anchor
    (with the current gauge level) as a backstop between increment drops
  * each log line also carries live speed + a derived longitudinal accel
    (``spd~44mph  a~-0.3``), decoded from ``0x3E9`` via a second
    ``candump`` pipe -- purely for context when correlating the SOC
    candidate against load. Decode is cross-checked (wiki + capture) but
    not speedo-verified; accel is a slope over ~1 s of samples, no IMU.
  * each log line also carries the current raw value of every broadcast
    SOC candidate (``cand[3E3.0=161 3E3.1=161 3E3.6=160 228.2=79
    186.6=63]``) from a third passive ``candump`` pipe -- so a mark taken
    at a known SOC on the next drive pins the raw->% scale
  * ``--diag-soc`` (ACTIVE TX -- the only transmit path): every
    ``--diag-soc-every`` s send the UDS ReadDataByIdentifier poll
    ``22 005B`` ("Hybrid/EV Battery Pack Remaining Charge", raw*100/255 %)
    and stamp the decoded percent on each line (``soc22=61.2%(0x9C@7EC)``).
    Default session, mode-22 only -- no session switch, no TesterPresent --
    so it will not suppress the normal broadcasts. Single ISO-TP frame each
    way, so it needs only ``cansend`` + a filtered ``candump``.
  * optional: ``--lcd`` mirrors the ``t+<s>`` clock and the live gauge
    level to a SparkFun serial 4x20 (see ``tools/lcd.py``)

Runs for ``--minutes`` then stops itself; Ctrl-C (parked) also stops it
cleanly and closes the capture.

  DO NOT touch the Pi while driving -- use the panel buttons. Start it
  before you pull away.

Afterwards:
  tools/mine_capture.py ~/candump-<ts>.log --ids
  tools/mine_capture.py ~/candump-<ts>.log --monotonic --top 25
  tools/mine_capture.py ~/candump-<ts>.log --series <ID>:<OFF>:<W>[:le] --every 20

Usage:
  # 90 min capture, gauge buttons, LCD, SOC-MARK backstop every 2 min
  ./soc_log.py --yes --minutes 90 --buttons --lcd

  # Session-9 anchor drive: also poll the diagnostic charge PID every 10 s
  ./soc_log.py --yes --minutes 90 --buttons --lcd --diag-soc

  # capture + periodic anchors only, no buttons wired
  ./soc_log.py --yes --minutes 60

  # show the plan, touch no hardware
  ./soc_log.py --dry-run
"""

from __future__ import annotations

import argparse
import datetime as _dt
import pathlib
import re
import signal
import subprocess
import sys
import threading
import time

sys.path.insert(0, str(pathlib.Path(__file__).resolve().parent.parent))

from voltdmf import lcdlock  # noqa: E402
from voltdmf.lcd import SerLcd  # noqa: E402
from voltdmf.signals import SIGNAL_IDS  # noqa: E402

_SPEED_ADDR = SIGNAL_IDS["speed"].addr  # 0x3E9 -- present in the Session-8 capture (10 Hz)

# Broadcast SOC candidates from the Session-8 timer-rejection analysis, as
# (addr, (byte offsets,)). Logged raw on every line -- passive -- so a mark
# taken at a known SOC on the next drive calibrates raw->% straight from
# the capture. 0x3E3 is triple-redundant (b0/b1/b6); require agreement to
# reject noise once one is picked.
_SOC_CANDIDATES: tuple[tuple[int, tuple[int, ...]], ...] = (
    (0x3E3, (0, 1, 6)),
    (0x228, (2,)),
    (0x186, (6,)),
)

# UDS ReadDataByIdentifier for "Hybrid/EV Battery Pack Remaining Charge"
# (GM Volt RE wiki: 22 005B, value * 100/255 %). Request and response each
# fit one ISO-TP single frame, so cansend + a filtered candump is enough --
# no isotp / python-can. Target ECU is not in the wiki table; try the
# BECM/hybrid id first, then powertrain, and lock onto whichever answers.
_DIAG_DID = 0x005B
_DIAG_REQ_CANDIDATES = (0x7E4, 0x7E0)


def _uds_soc_percent(raw: int) -> float:
    """22 005B raw byte -> battery charge percent (raw * 100 / 255)."""
    return raw * 100.0 / 255.0


# -- can0 state (read-only, via iproute2) ---------------------------------
def can_state(channel: str) -> str:
    try:
        out = subprocess.run(["ip", "-details", "link", "show", channel],
                             capture_output=True, text=True, timeout=3).stdout
    except (OSError, subprocess.SubprocessError):
        return "?"
    m = re.search(r"can state (\S+)", out)
    return m.group(1) if m else "?"


# -- raw candump -l capture for the whole session -----------------------
def start_capture(channel: str, outdir: str, log):
    d = pathlib.Path(outdir).expanduser()
    d.mkdir(parents=True, exist_ok=True)
    before = set(d.glob("candump-*.log"))
    try:
        proc = subprocess.Popen(["candump", "-l", channel], cwd=d,
                                stdout=subprocess.DEVNULL,
                                stderr=subprocess.DEVNULL)
    except OSError as exc:
        log(f"  candump did not start ({exc}); NO RAW CAPTURE -- abort and fix")
        return None, None
    time.sleep(0.8)
    if proc.poll() is not None:
        log("  candump exited immediately; NO RAW CAPTURE -- abort and fix")
        return None, None
    new = sorted(set(d.glob("candump-*.log")) - before)
    path = new[-1] if new else None
    log(f"  raw capture: candump -l {channel} -> "
        f"{path or (str(d) + '/candump-*.log')}")
    return proc, path


def stop_capture(proc, path, log) -> None:
    if proc is None:
        return
    proc.send_signal(signal.SIGINT)
    try:
        proc.wait(timeout=5)
    except subprocess.TimeoutExpired:
        proc.kill()
    sz = (path.stat().st_size / 1e6) if path and path.exists() else 0.0
    log(f"raw capture closed: {path} ({sz:.1f} MB)")


# -- speed + accel context from 0x3E9 (best-effort, decode cross-checked) --
class SpeedProbe:
    """Live vehicle speed and derived longitudinal accel from ``0x3E9``.

    Reads a dedicated ``candump`` pipe filtered to the one ID -- no
    ``python-can`` dependency (it is not installed for the system
    interpreter on the Pi, which is what the systemd unit runs). A daemon
    thread keeps the latest decoded value; ``mph()`` / ``accel_mps2()``
    never block.

    Decode: ``0x3E9`` bytes 0-1 big-endian / 64 = km/h -> mph
    (``voltdmf.signals.decode_speed_mph``). Cross-checked against the GM
    Volt reverse-engineering wiki and the Session-8 full-drain capture, but
    not yet against a reference speedo -- so marks tag it ``spd~`` (no
    guarantee). Accel is a least-squares slope over the last ~1.2 s of
    speed samples; there is no IMU, so hard bumps and road grade are
    invisible -- treat it as "are we speeding up or slowing down".
    """

    _MPH_TO_MPS = 0.44704
    _WIN_S = 1.2

    def __init__(self, channel: str, log) -> None:
        self._proc = None
        self._lock = threading.Lock()
        self._mph: float | None = None
        self._samples: list[tuple[float, float]] = []  # (ts, mph), newest last
        filt = f"{channel},{_SPEED_ADDR:X}:7FF"
        try:
            self._proc = subprocess.Popen(
                ["candump", "-L", filt],
                stdout=subprocess.PIPE, stderr=subprocess.DEVNULL, text=True)
        except OSError as exc:
            log(f"  speed probe off ({exc}); marks will show spd~n/a")
            return
        threading.Thread(target=self._reader, daemon=True).start()
        log(f"  speed probe: candump -L {filt}  "
            f"(0x3E9 b0-1 BE / 64 kph -> mph; decode not speedo-checked)")

    def _reader(self) -> None:
        # candump -L line format:  (1693500000.123456) can0 3E9#1600...
        for line in self._proc.stdout:
            parts = line.split()
            if len(parts) != 3 or "#" not in parts[2]:
                continue
            try:
                ts = float(parts[0].strip("()"))
                data = bytes.fromhex(parts[2].split("#", 1)[1])
            except ValueError:
                continue
            if len(data) < 2:
                continue
            mph = ((data[0] << 8 | data[1]) / 64.0) * 0.621371
            with self._lock:
                self._mph = mph
                self._samples.append((ts, mph))
                cutoff = ts - self._WIN_S
                while len(self._samples) > 2 and self._samples[0][0] < cutoff:
                    self._samples.pop(0)

    def mph(self):
        with self._lock:
            return self._mph

    def accel_mps2(self):
        """Longitudinal accel (m/s^2) from the last ~1.2 s of speed samples,
        least-squares slope of v(t). ``None`` until enough samples land."""
        with self._lock:
            s = list(self._samples)
        if len(s) < 3:
            return None
        t0 = s[0][0]
        xs = [p[0] - t0 for p in s]
        ys = [p[1] * self._MPH_TO_MPS for p in s]
        n = len(s)
        mx = sum(xs) / n
        my = sum(ys) / n
        den = sum((x - mx) ** 2 for x in xs)
        if den <= 1e-6:
            return None
        return sum((xs[i] - mx) * (ys[i] - my) for i in range(n)) / den

    def close(self) -> None:
        if self._proc is None:
            return
        self._proc.send_signal(signal.SIGINT)
        try:
            self._proc.wait(timeout=3)
        except subprocess.TimeoutExpired:
            self._proc.kill()


# -- broadcast SOC candidates (passive) --------------------------------
class CandidateProbe:
    """Latest raw byte value of every broadcast SOC candidate, from a
    dedicated ``candump`` pipe. Passive -- never transmits. ``fmt()`` gives
    the ``cand[...]`` tail stamped on every log line; ``snapshot()`` returns
    ``[("3E3.0", 161), ("228.2", 79), ...]`` (value ``None`` until a frame
    for that id has landed)."""

    def __init__(self, channel: str, log) -> None:
        self._proc = None
        self._lock = threading.Lock()
        self._latest: dict[int, bytes] = {}
        self._ids = {addr for addr, _ in _SOC_CANDIDATES}
        filt = ",".join(f"{a:X}:7FF" for a in sorted(self._ids))
        try:
            self._proc = subprocess.Popen(
                ["candump", "-L", f"{channel},{filt}"],
                stdout=subprocess.PIPE, stderr=subprocess.DEVNULL, text=True)
        except OSError as exc:
            log(f"  candidate probe off ({exc}); marks will show cand~n/a")
            return
        threading.Thread(target=self._reader, daemon=True).start()
        log(f"  candidate probe: candump -L {channel},{filt}  "
            f"(0x3E3 b0/b1/b6, 0x228 b2, 0x186 b6 -- passive)")

    def _reader(self) -> None:
        for line in self._proc.stdout:
            parts = line.split()
            if len(parts) != 3 or "#" not in parts[2]:
                continue
            cid, _, hx = parts[2].partition("#")
            try:
                addr = int(cid, 16)
                data = bytes.fromhex(hx)
            except ValueError:
                continue
            if addr in self._ids:
                with self._lock:
                    self._latest[addr] = data

    def snapshot(self) -> list[tuple[str, int | None]]:
        out: list[tuple[str, int | None]] = []
        with self._lock:
            for addr, offs in _SOC_CANDIDATES:
                data = self._latest.get(addr)
                for off in offs:
                    have = data is not None and len(data) > off
                    out.append((f"{addr:X}.{off}", data[off] if have else None))
        return out

    def fmt(self) -> str:
        body = " ".join(f"{k}={'--' if v is None else v}"
                        for k, v in self.snapshot())
        return f"cand[{body}]"

    def close(self) -> None:
        if self._proc is None:
            return
        self._proc.send_signal(signal.SIGINT)
        try:
            self._proc.wait(timeout=3)
        except subprocess.TimeoutExpired:
            self._proc.kill()


# -- diagnostic SOC poll (OPT-IN; the only transmit path) --------------
class DiagSocProbe:
    """``--diag-soc``: send ``22 005B`` every ``period`` s and decode the
    reply as battery charge percent. THIS IS THE ONLY TRANSMIT PATH in this
    tool. Stays in the default diagnostic session and uses mode-22 only --
    no session switch, no TesterPresent -- so it cannot put an ECU into a
    state that suppresses the normal broadcasts. Request and response each
    fit one ISO-TP single frame, so it needs only ``cansend`` + a filtered
    ``candump``. Tries the candidate request ids until one answers, locks
    onto it, and disables itself (one log line) if none do."""

    def __init__(self, channel: str, period: float, log,
                 req_id: int | None = None) -> None:
        self._chan = channel
        self._period = max(2.0, period)
        self._log = log
        self._reqs = (req_id,) if req_id else _DIAG_REQ_CANDIDATES
        self._pinned = req_id is not None
        self._req_id: int | None = req_id
        self._lock = threading.Lock()
        self._pct: float | None = None
        self._raw: int | None = None
        self._rx_id: int | None = None
        self._at: float | None = None
        self.polls = 0
        self.replies = 0
        self.nrcs = 0
        self._stop = threading.Event()
        self._proc = None
        try:
            # any standard 11-bit ECU response id 0x7E8..0x7EF
            self._proc = subprocess.Popen(
                ["candump", "-L", f"{channel},7E8:7F8"],
                stdout=subprocess.PIPE, stderr=subprocess.DEVNULL, text=True)
        except OSError as exc:
            log(f"  DIAG poll OFF -- candump listener did not start ({exc})")
            return
        threading.Thread(target=self._reader, daemon=True).start()
        threading.Thread(target=self._poller, daemon=True).start()
        who = (f"{req_id:X}" if req_id else
               "auto " + "/".join(f"{r:X}" for r in self._reqs))
        log(f"  DIAG poll ON (ACTIVE TX): 22 005B every {self._period:.0f}s, "
            f"req id {who}")

    def _send(self, req_id: int) -> None:
        frame = f"{req_id:03X}#0322{_DIAG_DID:04X}55555555"
        try:
            subprocess.run(["cansend", self._chan, frame],
                           stdout=subprocess.DEVNULL, stderr=subprocess.DEVNULL,
                           timeout=2, check=False)
        except (OSError, subprocess.SubprocessError) as exc:
            self._log(f"  DIAG cansend failed ({exc})")

    def _poller(self) -> None:
        while not self._stop.wait(self._period):
            targets = (self._req_id,) if self._req_id else self._reqs
            for r in targets:
                if r is None:
                    continue
                self.polls += 1
                self._send(r)
                if self._req_id:
                    break
                time.sleep(0.4)  # settle one reply before trying the next id

    def _reader(self) -> None:
        for line in self._proc.stdout:
            parts = line.split()
            if len(parts) != 3 or "#" not in parts[2]:
                continue
            cid, _, hx = parts[2].partition("#")
            try:
                rx = int(cid, 16)
                d = bytes.fromhex(hx)
            except ValueError:
                continue
            if len(d) < 4:
                continue
            # positive: 04 62 00 5B XX ...    negative: 03 7F 22 <NRC> ...
            if (d[0] >= 4 and d[1] == 0x62
                    and (d[2] << 8 | d[3]) == _DIAG_DID and len(d) >= 5):
                with self._lock:
                    self._raw = d[4]
                    self._pct = _uds_soc_percent(d[4])
                    self._rx_id = rx
                    self._at = time.time()
                    self.replies += 1
                    if self._req_id is None:
                        self._req_id = rx - 8  # lock onto the ECU that answered
                        self._log(f"  DIAG locked: {rx - 8:X} -> {rx:X}  "
                                  f"first read {self._pct:.1f}% (0x{d[4]:02X})")
            elif d[1] == 0x7F and d[2] == 0x22:
                with self._lock:
                    self.nrcs += 1

    def snapshot(self):
        with self._lock:
            if self._pct is None:
                return None
            age = None if self._at is None else time.time() - self._at
            return (self._pct, self._raw, self._rx_id, age)

    def fmt(self) -> str:
        s = self.snapshot()
        if s is None:
            return "soc22=n/a"
        pct, raw, rx, age = s
        stale = "" if (age is not None and age < self._period * 3) else "!"
        return f"soc22={pct:.1f}%{stale}(0x{raw:02X}@{rx:X})"

    def close(self) -> None:
        self._stop.set()
        if self._proc is not None:
            self._proc.send_signal(signal.SIGINT)
            try:
                self._proc.wait(timeout=3)
            except subprocess.TimeoutExpired:
                self._proc.kill()


# -- LCD mirror (optional; no-ops when lcd is None) ---------------------
class Dash:
    def __init__(self, lcd, t0: float, level: int, total: int) -> None:
        self.lcd = lcd
        self.t0 = t0
        self.level = level
        self.total = total
        self.marks = 0
        self.last_mark_s = None
        self.phase = "starting"
        self.flash_until = 0.0
        self._paints = 0
        if lcd is not None:
            self.paint()

    def set_phase(self, text: str) -> None:
        self.phase = text
        self.paint()

    def note_mark(self, n: int, t_s: float) -> None:
        self.marks = n
        self.last_mark_s = t_s
        self.paint()

    def note_gauge(self, level: int, total: int, t_s: float) -> None:
        self.level = level
        self.total = total
        self.last_mark_s = t_s
        self.flash_until = time.time() + 5.0
        self.paint()

    def paint(self) -> None:
        if self.lcd is None:
            return
        el = int(time.time() - self.t0)
        last = "--" if self.last_mark_s is None else f"+{self.last_mark_s:.0f}s"
        self.lcd.line(0, f"t+{el:>5}s  {_dt.datetime.now():%H:%M:%S}")
        self.lcd.line(1, self.phase[:20])
        self.lcd.line(2, f"GAUGE {self.level:>2}/{self.total:<2}  "
                      f"mk {self.marks:<2} {last}")
        self.lcd.line(3, ">> gauge logged" if time.time() < self.flash_until
                      else "A=down  B=up  (2x=stop)")
        self._paints += 1
        if self._paints % 20 == 0:
            self.lcd.refresh()  # recover a browned-out panel


# -- the session ------------------------------------------------------
class Session:
    """Shared clock, gauge tracker and mark recorder. Thread-safe: GPIO
    button callbacks and the main loop all land here."""

    def __init__(self, log, speed: "SpeedProbe", cand: "CandidateProbe",
                 diag: "DiagSocProbe | None", dash: "Dash", channel: str,
                 level: int, total: int) -> None:
        self.log = log
        self.speed = speed
        self.cand = cand
        self.diag = diag
        self.dash = dash
        self.channel = channel
        self.level = level
        self.total = total
        self.t0 = time.time()
        self.n = 0
        self._lock = threading.Lock()

    def _prefix(self, dt: float) -> str:
        sp = self.speed.mph()
        spd = "n/a" if sp is None else f"{sp:.0f}mph"
        ac = self.speed.accel_mps2()
        acc = "a~n/a" if ac is None else f"a~{ac:+.1f}"
        line = (f"+{dt:7.1f}s  spd~{spd:<6} {acc:<7} "
                f"gauge={self.level}/{self.total}"
                f"  can0={can_state(self.channel)}"
                f"  {self.cand.fmt()}")
        if self.diag is not None:
            line += f"  {self.diag.fmt()}"
        return line

    def mark(self, kind: str, note: str = "") -> None:
        """A plain time anchor: START / END / periodic SOC-MARK."""
        with self._lock:
            self.n += 1
            dt = time.time() - self.t0
            tail = f"  {note}" if note else ""
            self.log(f"  {kind:<11} {self._prefix(dt)}  (#{self.n}){tail}")
            self.dash.note_mark(self.n, dt)

    def gauge(self, delta: int) -> None:
        """Button A/B: the dash battery gauge moved one increment."""
        with self._lock:
            new = max(0, min(self.total, self.level + delta))
            dt = time.time() - self.t0
            if new == self.level:
                self.log(f"  GAUGE-EDGE   {self._prefix(dt)}  "
                         f"(ignored: already {self.level}/{self.total})")
                return
            self.level = new
            self.n += 1
            kind = "GAUGE-DOWN" if delta < 0 else "GAUGE-UP"
            self.log(f"  {kind:<11} {self._prefix(dt)}  (#{self.n})")
            self.dash.note_gauge(new, self.total, dt)


# -- GPIO buttons (optional; lazy import so this runs on any box) -------
class Buttons:
    """Two momentary buttons to GND on the Pi header, internal pull-ups.
    A = gauge dropped one increment, B = gauge went up one. ``gpiozero``
    only; if it is missing the tool runs without them."""

    def __init__(self, session: "Session", gpio_a: int, gpio_b: int,
                 stop_hold: float, log) -> None:
        self._session = session
        self._stop_hold = stop_hold
        self._both_since: float | None = None
        self.stop_requested = False
        self._btns = None
        # Poll-driven gesture state (no when_pressed callbacks): a tap only
        # commits on *release*, and only if the other button was never down
        # during that press -- so reaching for the two-button stop can't slip
        # a stray GAUGE-UP/DOWN in first (you never hit both pads on the same
        # millisecond).
        self._a_down_at: float | None = None
        self._b_down_at: float | None = None
        self._a_saw_b = False
        self._b_saw_a = False
        try:
            from gpiozero import Button  # noqa: PLC0415
        except Exception as exc:  # noqa: BLE001
            log(f"  buttons off (no gpiozero: {exc})")
            return
        # When button_helper.py launches us it has only just handed these pins
        # back; lgpio's release on the other side can lag a second or two, and
        # a half-done claim here poisons the retry. Between tries, close what
        # we got AND drop the pin factory (frees the gpiochip fd) before the
        # next attempt. ~15 s of headroom, then run button-less.
        from gpiozero import Device  # noqa: PLC0415

        def _drop_factory() -> None:
            try:
                if Device.pin_factory is not None:
                    Device.pin_factory.close()
                    Device.pin_factory = None
            except Exception:  # noqa: BLE001
                pass

        a = b = None
        tries = 15
        for attempt in range(1, tries + 1):
            try:
                a = Button(gpio_a, pull_up=True, bounce_time=0.05)
                b = Button(gpio_b, pull_up=True, bounce_time=0.05)
                break
            except Exception as exc:  # noqa: BLE001
                for x in (a, b):
                    if x is not None:
                        try:
                            x.close()
                        except Exception:  # noqa: BLE001
                            pass
                a = b = None
                _drop_factory()
                if attempt == tries:
                    log(f"  buttons off (GPIO {gpio_a}/{gpio_b} unavailable "
                        f"after {attempt} tries: {exc})")
                    return
                time.sleep(1.0)
        # No when_pressed: the main loop calls tick() ~5x/s and that is the
        # single place presses are interpreted (see tick()).
        self._btns = (a, b)
        log(f"  buttons: GPIO{gpio_a}=A gauge-down  GPIO{gpio_b}=B gauge-up  "
            f"(tap = on release)   hold both {stop_hold:.0f}s = stop")

    def tick(self) -> bool:
        """Call from the main loop. Interprets both pads from ``is_pressed``
        edges: a lone tap fires ``gauge(-/+1)`` on release, a held pair fires
        the stop. Returns True once both have been held for ``stop_hold`` s."""
        if self._btns is None:
            return False
        a, b = self._btns
        now = time.time()
        a_p, b_p = a.is_pressed, b.is_pressed

        # -- press edges
        if a_p and self._a_down_at is None:
            self._a_down_at, self._a_saw_b = now, b_p
        if b_p and self._b_down_at is None:
            self._b_down_at, self._b_saw_a = now, a_p
        # -- the other pad joined an in-progress press -> neither is a tap
        if a_p and b_p:
            self._a_saw_b = self._b_saw_a = True

        # -- release edges: commit a tap only if this press stayed solo
        if not a_p and self._a_down_at is not None:
            if not self._a_saw_b:
                self._session.gauge(-1)
            self._a_down_at, self._a_saw_b = None, False
        if not b_p and self._b_down_at is not None:
            if not self._b_saw_a:
                self._session.gauge(+1)
            self._b_down_at, self._b_saw_a = None, False

        # -- both held for stop_hold -> stop
        if self._stop_hold > 0 and a_p and b_p:
            if self._both_since is None:
                self._both_since = now
            elif now - self._both_since >= self._stop_hold:
                self.stop_requested = True
        elif not (a_p and b_p):
            self._both_since = None
        return self.stop_requested

    def close(self) -> None:
        if self._btns:
            for btn in self._btns:
                btn.close()


def make_logger(path: pathlib.Path):
    fh = open(path, "a", buffering=1)

    def log(msg: str = "") -> None:
        line = f"{_dt.datetime.now():%H:%M:%S}  {msg}" if msg else ""
        print(line, flush=True)
        fh.write(line + "\n")

    return log, fh


def _build_parser() -> argparse.ArgumentParser:
    ap = argparse.ArgumentParser(
        description=__doc__, formatter_class=argparse.RawDescriptionHelpFormatter)
    ap.add_argument("--yes", action="store_true",
                    help="required for a live run: you are set up and about "
                         "to drive; passive unless --diag-soc is also given")
    ap.add_argument("--channel", default="can0")
    ap.add_argument("--minutes", type=float, default=60.0,
                    help="session length before it stops itself (default 60)")
    ap.add_argument("--mark-every", type=float, default=120.0, metavar="SECS",
                    help="seconds between periodic SOC-MARK time anchors, a "
                         "backstop between gauge drops (0 = off; default 120)")
    ap.add_argument("--capture-dir", default="~",
                    help="where candump -l writes its log (default ~)")
    ap.add_argument("--buttons", action="store_true",
                    help="wire two GPIO panel buttons: A = gauge dropped one "
                         "increment, B = gauge went up one")
    ap.add_argument("--button-a-gpio", type=int, default=24, metavar="BCM",
                    help="BCM pin for button A / gauge-down (default 24 = "
                         "PiCAN2 switch SW1)")
    ap.add_argument("--button-b-gpio", type=int, default=23, metavar="BCM",
                    help="BCM pin for button B / gauge-up (default 23 = "
                         "PiCAN2 switch SW2)")
    ap.add_argument("--bars", type=int, default=10, metavar="N",
                    help="increments in the dash battery gauge (default 10)")
    ap.add_argument("--bars-start", type=int, default=None, metavar="N",
                    help="gauge level at kickoff if not full (default --bars)")
    ap.add_argument("--stop-hold", type=float, default=3.0, metavar="SECS",
                    help="hold BOTH buttons this long to end the session "
                         "(0 = disable; default 3)")
    ap.add_argument("--lcd", action="store_true",
                    help="mirror the clock and live gauge level to a "
                         "SparkFun serial 4x20 LCD (see tools/lcd.py)")
    ap.add_argument("--lcd-port", default="/dev/serial0")
    ap.add_argument("--lcd-baud", type=int, default=9600)
    ap.add_argument("--lcd-backlight", type=int, default=45, metavar="PCT",
                    help="LCD backlight 0..100 (default 45; lower it if the "
                         "panel resets -- that is a 5 V sag, not software)")
    ap.add_argument("--logfile", default=None,
                    help="log path (default ~/vdmf-soclog-<timestamp>.log)")
    ap.add_argument("--diag-soc", action="store_true",
                    help="ACTIVE TX: also poll the diagnostic charge PID "
                         "(UDS 22 005B) for a continuous ground-truth SOC "
                         "percentage. This is the only path that transmits.")
    ap.add_argument("--diag-soc-every", type=float, default=10.0, metavar="SECS",
                    help="seconds between 22 005B polls (default 10)")
    ap.add_argument("--diag-req-id", default=None, metavar="HEX",
                    help="pin the UDS request id (e.g. 0x7E4); default tries "
                         "0x7E4 then 0x7E0 and locks onto whichever answers")
    ap.add_argument("--dry-run", action="store_true",
                    help="print the plan and exit; no hardware touched")
    return ap


def main() -> None:
    ap = _build_parser()
    args = ap.parse_args()

    diag_req_id = None
    if args.diag_req_id is not None:
        try:
            diag_req_id = int(args.diag_req_id, 16)
        except ValueError:
            ap.error(f"--diag-req-id: not hex: {args.diag_req_id!r}")

    total = max(1, args.bars)
    start_level = total if args.bars_start is None else args.bars_start
    start_level = max(0, min(total, start_level))
    mark_desc = (f"every {args.mark_every:.0f}s"
                 if args.mark_every > 0 else "off (buttons only)")
    btn_desc = (f"GPIO{args.button_a_gpio} down / GPIO{args.button_b_gpio} up"
                if args.buttons else "OFF")

    if args.diag_soc:
        who = f"{diag_req_id:X}" if diag_req_id else "auto 7E4/7E0"
        diag_desc = (f"ACTIVE TX -- 22 005B every {args.diag_soc_every:.0f}s "
                     f"(req id {who})")
    else:
        diag_desc = "off (passive run)"

    print(f"SOC-discovery drive log ({'ACTIVE TX -- --diag-soc' if args.diag_soc else 'PASSIVE -- no TX'})")
    print(f"plan: {args.minutes:.0f} min capture on {args.channel}")
    print(f"  gauge: {start_level}/{total} at start   buttons: {btn_desc}")
    print(f"  SOC-MARK backstop: {mark_desc}   LCD: {'on' if args.lcd else 'off'}")
    print(f"  broadcast SOC candidates: 0x3E3 b0/b1/b6, 0x228 b2, 0x186 b6 "
          f"(passive, on every line)")
    print(f"  diagnostic SOC poll: {diag_desc}")
    print(f"  raw capture -> {args.capture_dir}/candump-<ts>.log "
          f"(mine with tools/mine_capture.py)")

    if args.dry_run:
        print("\n[DRY RUN] nothing started.")
        return

    if not args.yes:
        sys.exit("refusing to start without --yes (or pass --dry-run)")

    st = can_state(args.channel)
    if st in ("STOPPED", "?"):
        sys.exit(f"{args.channel} is {st} -- bring the bus up first "
                 f"(sudo ip link set {args.channel} up type can bitrate 500000)")

    logpath = pathlib.Path(
        args.logfile or pathlib.Path.home() /
        f"vdmf-soclog-{_dt.datetime.now():%Y%m%d-%H%M%S}.log")
    log, fh = make_logger(logpath)
    log(f"soc_log start  channel={args.channel}  minutes={args.minutes:.0f}  "
        f"mark-every={args.mark_every:.0f}s  logfile={logpath}")
    log(f"mode: {'ACTIVE TX (--diag-soc: 22 005B poll)' if args.diag_soc else 'PASSIVE (no TX)'}")
    log(f"can0 state: {st}")

    cap_proc, cap_path = start_capture(args.channel, args.capture_dir, log)
    if cap_proc is None:
        log("no raw capture -- aborting (that IS the deliverable).")
        fh.close()
        sys.exit(1)

    lcd = None
    if args.lcd:
        lcdlock.claim("soc_log.py")  # daemon watch screen yields the panel
        try:
            lcd = SerLcd(args.lcd_port, args.lcd_baud,
                         backlight=args.lcd_backlight).open()
            log(f"LCD mirror on {args.lcd_port} @ {args.lcd_baud} "
                f"(backlight {args.lcd_backlight}%)")
        except OSError as exc:
            log(f"LCD open failed ({exc}); continuing without the mirror")

    t0 = time.time()
    dash = Dash(lcd, t0, start_level, total)
    speed = SpeedProbe(args.channel, log)
    cand = CandidateProbe(args.channel, log)
    diag = (DiagSocProbe(args.channel, args.diag_soc_every, log,
                         req_id=diag_req_id)
            if args.diag_soc else None)
    session = Session(log, speed, cand, diag, dash, args.channel,
                      start_level, total)
    session.t0 = t0  # share the exact origin with the Dash

    buttons = Buttons(session, args.button_a_gpio, args.button_b_gpio,
                      args.stop_hold, log) if args.buttons else None

    log("")
    log(f"logging -- drive the pack down from gauge {start_level}/{total}. "
        "Tap A each time an increment drops (B if it climbs back). "
        "Ctrl-C (parked) or hold both buttons to stop.")
    session.mark("START")

    end = t0 + args.minutes * 60
    next_mark = args.mark_every
    stopped_by = "duration"
    last_tick = 0  # whole-second gate for the LCD repaint + can0 poll
    try:
        while time.time() < end:
            time.sleep(0.2)  # keep button-hold detection responsive
            now = time.time() - t0

            if args.mark_every > 0 and now >= next_mark:
                session.mark("SOC-MARK")
                while next_mark <= now:
                    next_mark += args.mark_every

            if buttons is not None and buttons.tick():
                stopped_by = "button hold"
                break

            sec = int(now)
            if sec != last_tick:  # once a second is plenty for these
                last_tick = sec
                dash.set_phase(f"LOGGING  {(end - time.time()) / 60:.0f}min left")
                if sec % 30 == 0:
                    cs = can_state(args.channel)
                    if cs in ("BUS-OFF", "STOPPED"):
                        log(f"  can0 went {cs} -- capture continues, "
                            f"but check the bus")
    except KeyboardInterrupt:
        stopped_by = "Ctrl-C"
        log("\ninterrupted -- stopping (hope you're parked).")

    session.mark("END")
    log("")
    log(f"================ SUMMARY  (stopped: {stopped_by}) ================")
    log(f"  {session.n} marks over {(time.time() - t0) / 60:.1f} min")
    log(f"  gauge {start_level}/{total} -> {session.level}/{total}  "
        f"({start_level - session.level} increment(s) dropped)")
    if diag is not None:
        s = diag.snapshot()
        last = f"{s[0]:.1f}% (0x{s[1]:02X}@{s[2]:X})" if s else "no reply"
        log(f"  diag poll: {diag.polls} sent, {diag.replies} replies, "
            f"{diag.nrcs} NRC; last {last}")
    stop_capture(cap_proc, cap_path, log)
    speed.close()
    cand.close()
    if diag is not None:
        diag.close()
    if buttons is not None:
        buttons.close()
    if lcd is not None:
        dash.set_phase("DONE -- review log")
        lcd.close()
    if args.lcd:
        lcdlock.release()  # hand the panel back to the daemon watch screen
    if cap_path:
        log(f"  raw capture:  {cap_path}")
        log(f"  next:  tools/mine_capture.py {cap_path} --monotonic --top 25")
    log(f"  log written to {logpath}")
    log("========================================================")
    fh.close()


if __name__ == "__main__":
    main()
