mlh5599/volt-drive-mode-fixer/tests/test_daemon_control.py

"""Daemon control-command handling: arm/disarm, manual set-mode, setpoint,
reload, and the transmit-enable gate that sits in front of the CAN layer."""

import json
import time

import pytest

from voltdmf import daemon as daemon_mod
from voltdmf.canio import CanInterface
from voltdmf.config import parse_config
from voltdmf.daemon import SELECTOR_FLASH_S, Daemon
from voltdmf.safety import RequestOutcome
from voltdmf.reconciler import Position
from voltdmf.signals import DriveMode, EngineState, ShiftPosition
from voltdmf.state import VehicleState


def _config(*, position="hold-soc", **over):
    raw = {
        "policy": {"default_position": position, "hold_threshold_percent": 30,
                   "bar_failsafe_raw": 9},
        "soc_poll": {"enabled": True, "period_seconds": 10},
    }
    raw.update(over)
    return parse_config(raw)


def _daemon(*, start_armed=True, config_path=None, position="hold-soc"):
    return Daemon(_config(position=position), lcd=False, start_armed=start_armed,
                  control_enabled=False, config_path=config_path)


class _FakeGate:
    def __init__(self, outcome):
        self.outcome = outcome
        self.calls = []
        self.request_calls = []

    def request_verbose(self, target, state, *, force=False):
        self.calls.append((target, force))
        if not state.bus_active:
            # What the real gate does with the ignition off. Worth honouring
            # here: "no taps went out" is what the retry budget counts on.
            return RequestOutcome(False, 0, True, "blocked: bus is quiet (car off?)")
        if not state.ignition_on:
            # RAP window: bus_active alone stays True, so this needs its own
            # check -- see SafetyGate._precondition_failure.
            return RequestOutcome(False, 0, True, "blocked: ignition is off (RAP window?)")
        # Both entry points feed request_calls: _reconcile switched to
        # request_verbose when the retry budget needed the tap count, and a
        # test asking "did it walk?" should not care which one it used.
        self.request_calls.append(target)
        return self.outcome

    def request(self, target, state):
        return self.request_verbose(target, state).sent

    def cooldown_remaining(self):
        return 0.0


def _active_state(**kw):
    st = VehicleState(**kw)
    if st.soc_percent is not None:
        # A percentage only counts as a poll reading, and the reconciler only
        # trusts a fresh one -- so stamp it like a real reply would.
        st.soc_percent_monotonic = time.monotonic()
        st.soc_source = "poll"
    st.mark_signal_seen()
    st.mark_ignition_seen()
    return st


# --- arm / disarm --------------------------------------------------------
def test_boots_armed():
    assert _daemon()._transmit_enabled() is True


def test_start_disarmed_flag():
    assert _daemon(start_armed=False)._transmit_enabled() is False


def test_arm_then_disarm():
    d = _daemon(start_armed=False)
    assert d._handle_command("arm", {}) == {"ok": True, "armed": True}
    assert d._transmit_enabled() is True
    assert d._handle_command("disarm", {}) == {"ok": True, "armed": False}
    assert d._transmit_enabled() is False


# --- set-mode ----------------------------------------------------------
def test_set_mode_refused_when_disarmed():
    d = _daemon(start_armed=False)
    d._state = _active_state()
    reply = d._handle_command("set-mode", {"mode": "hold"})
    assert reply["ok"] is False
    assert reply["would_switch_to"] == "hold"


def test_set_mode_unknown_mode():
    d = _daemon()
    d._state = _active_state()
    reply = d._handle_command("set-mode", {"mode": "ludicrous"})
    assert reply["ok"] is False
    assert "unknown mode" in reply["error"]


def test_set_mode_calls_gate_and_sets_manual_override():
    d = _daemon()
    d._state = _active_state(shift=ShiftPosition.DRIVE)
    d._gate = _FakeGate(RequestOutcome(True, 3, False, "switched toward hold"))
    reply = d._handle_command("set-mode", {"mode": "hold", "force": True})
    assert reply["ok"] is True
    assert reply["sent"] == 3
    assert d._gate.calls == [(DriveMode.HOLD, True)]
    assert d._manual_target is DriveMode.HOLD


def test_set_mode_blocked_outcome_is_not_ok_and_no_override():
    d = _daemon()
    d._state = _active_state()
    d._gate = _FakeGate(RequestOutcome(False, 0, True, "blocked: shift is park"))
    reply = d._handle_command("set-mode", {"mode": "sport"})
    assert reply["ok"] is False
    assert reply["result"] == "blocked: shift is park"
    assert d._manual_target is None


# --- setpoint (the four-position selector) ----------------------------
def test_setpoint_jumps_to_an_explicit_detent():
    d = _daemon()
    assert d._reconciler.position is Position.HOLD_SOC
    reply = d._handle_command("setpoint", {"mode": "mountain"})
    assert reply["ok"] is True
    assert reply["setpoint"] == "mountain"
    assert reply["previous"] == "hold-soc"
    assert reply["description"] == "enforce mountain mode"
    assert d._reconciler.position is Position.MOUNTAIN


def test_setpoint_next_walks_the_sw1_cycle_and_wraps():
    """What an SW1 tap sends. The daemon owns the cycle, not the helper."""
    d = _daemon()
    seen = []
    for _ in range(5):
        seen.append(d._handle_command("setpoint", {"mode": "next"})["setpoint"])
    assert seen == ["hold-now", "mountain", "off", "hold-soc", "hold-now"]


@pytest.mark.parametrize("bad", ["normal", "sport", "ludicrous"])
def test_setpoint_rejects_a_non_detent(bad):
    d = _daemon()
    reply = d._handle_command("setpoint", {"mode": bad})
    assert reply["ok"] is False
    assert d._reconciler.position is Position.HOLD_SOC


def test_setpoint_change_starts_the_lcd_flash():
    d = _daemon()
    assert d._lcd_selector()["flashing"] is False
    d._handle_command("setpoint", {"mode": "mountain"})
    assert d._lcd_selector()["flashing"] is True


def test_setpoint_flash_expires_after_the_timeout():
    d = _daemon()
    d._handle_command("setpoint", {"mode": "mountain"})
    d._selector_flash_until -= SELECTOR_FLASH_S + 1  # fast-forward past it
    assert d._lcd_selector()["flashing"] is False


def test_setpoint_to_the_same_detent_does_not_flash():
    d = _daemon()  # already hold-soc
    d._handle_command("setpoint", {"mode": "hold-soc"})
    assert d._lcd_selector()["flashing"] is False


def test_rejected_setpoint_does_not_flash():
    d = _daemon()
    d._handle_command("setpoint", {"mode": "ludicrous"})
    assert d._lcd_selector()["flashing"] is False


# --- reconcile -----------------------------------------------------
def test_reconcile_acts_when_armed_and_clears_manual_override():
    d = _daemon(position="mountain")
    d._state = _active_state(shift=ShiftPosition.DRIVE, drive_mode=DriveMode.NORMAL)
    d._gate = _FakeGate(RequestOutcome(True, 1, False, "ok"))
    d._manual_target = DriveMode.SPORT
    d._reconcile()
    # selector on MOUNTAIN, car reads NORMAL -> a walk is requested
    assert d._gate.request_calls == [DriveMode.MOUNTAIN]
    assert d._manual_target is None


def test_reconcile_is_logging_only_when_disarmed():
    d = _daemon(start_armed=False, position="mountain")
    d._state = _active_state(shift=ShiftPosition.DRIVE, drive_mode=DriveMode.NORMAL)
    d._gate = _FakeGate(RequestOutcome(True, 1, False, "ok"))
    d._reconcile()
    assert d._gate.request_calls == []


def test_reconcile_noop_when_already_in_desired_mode():
    d = _daemon(position="mountain")
    d._state = _active_state(shift=ShiftPosition.DRIVE,
                             drive_mode=DriveMode.MOUNTAIN)
    d._gate = _FakeGate(RequestOutcome(True, 1, False, "ok"))
    d._reconcile()
    assert d._gate.request_calls == []


def test_reconcile_noop_on_the_hold_soc_detent_with_a_healthy_pack():
    """Detent 1 is passive above the floor -- the shipped boot behaviour."""
    d = _daemon()
    assert d._reconciler.position is Position.HOLD_SOC
    d._state = _active_state(shift=ShiftPosition.DRIVE,
                             drive_mode=DriveMode.NORMAL, soc_percent=80)
    d._gate = _FakeGate(RequestOutcome(True, 1, False, "ok"))
    d._reconcile()
    assert d._gate.request_calls == []          # healthy pack -> no target


def test_reconcile_noop_on_the_off_detent_even_with_a_flat_pack():
    """`off` means the car is on its own -- the floor does not act either."""
    d = _daemon(position="off")
    d._state = _active_state(shift=ShiftPosition.DRIVE,
                             drive_mode=DriveMode.NORMAL, soc_bar_raw=0)
    d._gate = _FakeGate(RequestOutcome(True, 1, False, "ok"))
    d._reconcile()
    assert d._gate.request_calls == []
    assert d._reconciler.floor_latched is False


def test_reconcile_walks_to_hold_when_the_soc_floor_engages():
    d = _daemon()                               # passive detent...
    d._state = _active_state(shift=ShiftPosition.DRIVE,
                             drive_mode=DriveMode.NORMAL, soc_percent=28.0)
    d._gate = _FakeGate(RequestOutcome(True, 1, False, "ok"))
    d._reconcile()                              # ...until the floor engages
    assert d._gate.request_calls == [DriveMode.HOLD]
    assert d._reconciler.floor_latched is True


def test_reconcile_holds_now_from_the_first_pass_on_the_hold_now_detent():
    """Detent 2 does not wait for the pack -- "bank what I have, starting now"."""
    d = _daemon(position="hold-now")
    d._state = _active_state(shift=ShiftPosition.DRIVE,
                             drive_mode=DriveMode.NORMAL, soc_percent=95.0)
    d._gate = _FakeGate(RequestOutcome(True, 1, False, "ok"))
    d._reconcile()
    assert d._gate.request_calls == [DriveMode.HOLD]
    assert d._reconciler.floor_latched is False   # enforced, not floored


def test_reconcile_does_not_latch_off_b3_alone_at_boot():
    """The latch is permanent for the key cycle now, so the coarse b3 proxy
    must not commit the drive before the 22 005B poll has had a chance."""
    d = _daemon()
    d._state = _active_state(shift=ShiftPosition.DRIVE,
                             drive_mode=DriveMode.NORMAL, soc_bar_raw=9)
    d._gate = _FakeGate(RequestOutcome(True, 1, False, "ok"))
    d._reconcile()
    assert d._gate.request_calls == []
    assert d._reconciler.floor_latched is False


def test_reconcile_waits_for_a_decodable_current_mode():
    d = _daemon(position="mountain")
    d._state = _active_state(shift=ShiftPosition.DRIVE, drive_mode=None)
    d._gate = _FakeGate(RequestOutcome(True, 1, False, "ok"))
    d._reconcile()
    assert d._gate.request_calls == []          # no 0x1F4 yet -> don't walk


# --- post-walk settle guard --------------------------------------------
def test_reconcile_arms_walk_settle_after_a_sent_walk():
    d = _daemon(position="mountain")
    d._state = _active_state(shift=ShiftPosition.DRIVE, drive_mode=DriveMode.NORMAL)
    d._gate = _FakeGate(RequestOutcome(True, 3, False, "ok"))  # request() -> sent
    d._reconcile()
    assert d._gate.request_calls == [DriveMode.MOUNTAIN]
    assert d._walk_settle_until > time.monotonic()


def test_reconcile_holds_off_while_walk_settle_is_active():
    d = _daemon(position="mountain")
    d._state = _active_state(shift=ShiftPosition.DRIVE, drive_mode=DriveMode.NORMAL)
    d._gate = _FakeGate(RequestOutcome(True, 3, False, "ok"))
    d._reconcile()                              # walk 1 -> settle armed
    d._reconcile()                              # byte-1 still NORMAL (commit lag)
    assert d._gate.request_calls == [DriveMode.MOUNTAIN]   # not re-requested


def test_reconcile_does_not_arm_settle_when_no_walk_went_out():
    d = _daemon(position="mountain")
    d._state = _active_state(shift=ShiftPosition.DRIVE, drive_mode=DriveMode.NORMAL)
    d._gate = _FakeGate(RequestOutcome(False, 0, True, "blocked"))  # request() -> False
    d._reconcile()
    assert d._walk_settle_until == 0.0


def test_setpoint_command_clears_walk_settle():
    d = _daemon()
    d._walk_settle_until = time.monotonic() + 999
    d._handle_command("setpoint", {"mode": "mountain"})
    assert d._walk_settle_until == 0.0


# --- walk-test (panel mode-walk self-test) ----------------------------
class _FakeController:
    """Stands in for ModeCycleController: each switch_to lands the mode."""

    def __init__(self, state, *, land=True):
        self._state = state
        self._land = land
        self.calls = []

    def switch_to(self, target, force=False):
        self.calls.append((target, force))
        if self._land:
            self._state.drive_mode = target   # simulate the committed byte-1
        return 1


def test_walk_test_refused_when_disarmed():
    d = _daemon(start_armed=False)
    d._state = _active_state(shift=ShiftPosition.PARK, drive_mode=DriveMode.HOLD)
    reply = d._handle_command("walk-test", {})
    assert reply["ok"] is False
    assert d._walk_test_pending is False
    assert d._last_action == "WALK-TEST: DISARMED"  # driver sees it on the LCD


def test_walk_test_refused_without_a_decoded_mode():
    d = _daemon()
    d._state = _active_state(shift=ShiftPosition.PARK, drive_mode=None)
    reply = d._handle_command("walk-test", {})
    assert reply["ok"] is False
    assert d._walk_test_pending is False
    assert d._last_action == "WALK-TEST: NO BUS"


def test_walk_test_queues_and_returns_started():
    d = _daemon()
    d._state = _active_state(shift=ShiftPosition.PARK, drive_mode=DriveMode.SPORT)
    reply = d._handle_command("walk-test", {})
    assert reply == {"ok": True, "started": True, "origin": "sport"}
    assert d._walk_test_pending is True
    assert d._last_action == "WALK-TEST QUEUED"
    # a second request while one is queued is refused, and does NOT stomp the
    # LCD (it is already showing progress)
    assert d._handle_command("walk-test", {})["ok"] is False
    assert d._last_action == "WALK-TEST QUEUED"


def test_walk_test_cycle_walks_every_mode_then_restores(monkeypatch):
    monkeypatch.setattr(daemon_mod, "WALK_TEST_LEG_SETTLE_S", 0.0)
    d = _daemon()
    st = _active_state(shift=ShiftPosition.PARK, drive_mode=DriveMode.SPORT)
    d._state = st
    d._controller = _FakeController(st)
    d._walk_test_pending = True

    d._run_walk_test_cycle()

    assert d._walk_test_pending is False
    assert [c[0] for c in d._controller.calls] == [
        DriveMode.NORMAL, DriveMode.SPORT, DriveMode.MOUNTAIN,
        DriveMode.HOLD, DriveMode.SPORT,          # 4-mode cycle + restore origin
    ]
    assert all(force for _, force in d._controller.calls)
    res = d._walk_test_result
    assert res["ok"] is True
    assert res["origin"] == "sport"
    assert len(res["legs"]) == 5
    assert res["legs"][-1]["restore"] is True
    assert st.drive_mode is DriveMode.SPORT       # left where it started
    assert "OK" in d._last_action
    json.dumps(d._status_snapshot())              # result stays serialisable


def test_walk_test_cycle_reports_fail_when_a_leg_lands_wrong(monkeypatch):
    monkeypatch.setattr(daemon_mod, "WALK_TEST_LEG_SETTLE_S", 0.0)
    d = _daemon()
    st = _active_state(shift=ShiftPosition.PARK, drive_mode=DriveMode.SPORT)
    d._state = st
    d._controller = _FakeController(st, land=False)  # walk never commits
    d._walk_test_pending = True

    d._run_walk_test_cycle()

    res = d._walk_test_result
    assert res["ok"] is False
    assert "FAIL" in d._last_action
    # the SPORT legs still "land" (state never left SPORT); N/M/H do not
    scored = [leg for leg in res["legs"] if not leg["restore"]]
    assert [leg["ok"] for leg in scored] == [False, True, False, False]


# --- test-mode / focused probe -------------------------------------------
class _ProbeController:
    """Stands in for ModeCycleController inside _run_probe: switch_to lands
    the cursor (byte 4), the committed mode (byte 1), both, or neither."""

    def __init__(self, state, *, land_cursor=True, land_byte1=True, taps=3):
        self._state = state
        self._land_cursor = land_cursor
        self._land_byte1 = land_byte1
        self._taps = taps
        self.calls = []

    def switch_to(self, target, force=False):
        self.calls.append((target, force))
        if self._land_cursor:
            self._state.menu_cursor = target
        if self._land_byte1:
            self._state.drive_mode = target
        return self._taps


def test_test_mode_on_off_toggles_flag_and_suspends_reconcile():
    d = _daemon(position="mountain")
    d._state = _active_state(shift=ShiftPosition.DRIVE, drive_mode=DriveMode.NORMAL)
    d._gate = _FakeGate(RequestOutcome(True, 1, False, "ok"))

    reply = d._handle_command("test-mode", {"on": True})
    assert reply["ok"] is True and reply["test_mode"] is True
    assert d._test_mode is True
    d._reconcile()                       # suspended -> gate untouched
    assert d._gate.request_calls == []

    assert d._handle_command("test-mode", {"on": False})["test_mode"] is False
    d._reconcile()                       # resumed -> acts
    assert d._gate.request_calls == [DriveMode.MOUNTAIN]


def test_probe_refused_when_disarmed():
    d = _daemon(start_armed=False)
    d._state = _active_state(shift=ShiftPosition.PARK, drive_mode=DriveMode.NORMAL)
    reply = d._handle_command("probe", {"mode": "hold"})
    assert reply["ok"] is False
    assert d._probe_pending is None
    assert d._last_action == "PROBE: DISARMED"


def test_probe_refused_without_a_decoded_mode():
    d = _daemon()
    d._state = _active_state(shift=ShiftPosition.PARK, drive_mode=None)
    reply = d._handle_command("probe", {"mode": "hold"})
    assert reply["ok"] is False
    assert d._last_action == "PROBE: NO BUS"
    assert d._probe_pending is None


def test_probe_unknown_mode_is_rejected():
    d = _daemon()
    d._state = _active_state(drive_mode=DriveMode.NORMAL)
    reply = d._handle_command("probe", {"mode": "ludicrous"})
    assert reply["ok"] is False
    assert "unknown mode" in reply["error"]


def test_probe_queues_and_refuses_a_second():
    d = _daemon()
    d._state = _active_state(shift=ShiftPosition.PARK, drive_mode=DriveMode.NORMAL)
    reply = d._handle_command("probe", {"mode": "mountain"})
    assert reply == {"ok": True, "started": True, "target": "mountain",
                     "origin": "normal", "test_mode": False}
    assert d._probe_pending is DriveMode.MOUNTAIN
    assert d._handle_command("probe", {"mode": "hold"})["ok"] is False
    assert d._probe_pending is DriveMode.MOUNTAIN


def test_run_probe_landed_when_cursor_and_byte1_reach_target(monkeypatch):
    monkeypatch.setattr(daemon_mod, "WALK_TEST_LEG_SETTLE_S", 0.0)
    d = _daemon()
    st = _active_state(shift=ShiftPosition.PARK, drive_mode=DriveMode.NORMAL)
    d._state = st
    d._controller = _ProbeController(st)

    d._run_probe(DriveMode.HOLD)

    res = d._probe_result
    assert res["verdict"] == "LANDED"
    assert res["ok"] is True
    assert res["target"] == "hold" and res["origin"] == "normal"
    assert res["cursor_reached"] is True
    assert res["byte1_after"] == "hold"
    assert d._probe_pending is None
    assert d._last_action == "PROBE HOLD LANDED"
    json.dumps(d._status_snapshot())         # probe result stays serialisable


def test_probe_running_is_true_while_the_probe_actually_runs(monkeypatch):
    """``probe_running`` must cover the RUN, not just the queued window.

    It used to be ``_probe_pending is not None``, and ``_run_probe`` clears
    ``_probe_pending`` on its first line -- so the flag read False for the
    entire duration of the probe. A client polling "not probe_running, read
    the result" therefore got handed the PREVIOUS probe's result. That
    produced a full round of bogus verdicts on 2026-09-04: rows reporting
    LANDED whose byte1_after did not match their own target.
    """
    monkeypatch.setattr(daemon_mod, "WALK_TEST_LEG_SETTLE_S", 0.0)
    d = _daemon()
    st = _active_state(shift=ShiftPosition.PARK, drive_mode=DriveMode.NORMAL)
    d._state = st
    seen = []

    class _Watching(_ProbeController):
        def switch_to(self, target, force=False):
            seen.append(d._status_snapshot()["probe_running"])
            return super().switch_to(target, force)

    d._controller = _Watching(st)
    assert d._status_snapshot()["probe_running"] is False   # idle
    d._handle_command("probe", {"mode": "hold"})
    assert d._status_snapshot()["probe_running"] is True    # queued
    d._run_probe(DriveMode.HOLD)

    assert seen == [True], "flag was False while the walk was in flight"
    assert d._status_snapshot()["probe_running"] is False   # done
    assert d._status_snapshot()["probe_queued"] is False


def test_probe_seq_advances_once_per_probe(monkeypatch):
    """A client can tell a fresh result from a stale one without a flag."""
    monkeypatch.setattr(daemon_mod, "WALK_TEST_LEG_SETTLE_S", 0.0)
    d = _daemon()
    st = _active_state(shift=ShiftPosition.PARK, drive_mode=DriveMode.NORMAL)
    d._state = st
    d._controller = _ProbeController(st)

    assert d._status_snapshot()["probe_seq"] == 0
    d._run_probe(DriveMode.HOLD)
    assert d._probe_result["seq"] == 1
    assert d._status_snapshot()["probe_seq"] == 1
    d._run_probe(DriveMode.SPORT)
    assert d._probe_result["seq"] == 2
    assert d._status_snapshot()["probe_seq"] == 2


def test_probe_clears_running_when_the_walk_blows_up(monkeypatch):
    """A stuck ``probe_running`` would wedge every later probe's client.

    SafetyGate absorbs an exception from the controller into a blocked
    outcome rather than letting it out, so the probe completes normally with
    a MISS -- but the flag has to be clear either way, which is why
    ``_probe_active`` is released in a ``finally``.
    """
    monkeypatch.setattr(daemon_mod, "WALK_TEST_LEG_SETTLE_S", 0.0)
    d = _daemon()
    st = _active_state(shift=ShiftPosition.PARK, drive_mode=DriveMode.NORMAL)
    d._state = st

    class _Exploding(_ProbeController):
        def switch_to(self, target, force=False):
            raise RuntimeError("bus went away mid-walk")

    d._controller = _Exploding(st)
    d._run_probe(DriveMode.HOLD)
    assert d._probe_result["verdict"] == "MISS"
    assert d._status_snapshot()["probe_running"] is False
    assert d._status_snapshot()["probe_seq"] == 1


def test_run_probe_cursor_only_when_byte1_never_commits(monkeypatch):
    monkeypatch.setattr(daemon_mod, "WALK_TEST_LEG_SETTLE_S", 0.0)
    d = _daemon()
    st = _active_state(shift=ShiftPosition.PARK, drive_mode=DriveMode.NORMAL)
    d._state = st
    d._controller = _ProbeController(st, land_byte1=False)  # parked-car case

    d._run_probe(DriveMode.MOUNTAIN)

    res = d._probe_result
    assert res["verdict"] == "CURSOR_ONLY"
    assert res["ok"] is True
    assert res["cursor_reached"] is True
    assert res["byte1_after"] == "normal"


def test_run_probe_miss_when_cursor_never_arrives(monkeypatch):
    monkeypatch.setattr(daemon_mod, "WALK_TEST_LEG_SETTLE_S", 0.0)
    d = _daemon()
    st = _active_state(shift=ShiftPosition.PARK, drive_mode=DriveMode.NORMAL)
    d._state = st
    d._controller = _ProbeController(st, land_cursor=False, land_byte1=False)

    d._run_probe(DriveMode.HOLD)

    res = d._probe_result
    assert res["verdict"] == "MISS"
    assert res["ok"] is False
    assert res["cursor_reached"] is False


def test_run_probe_blocked_by_precondition(monkeypatch):
    monkeypatch.setattr(daemon_mod, "WALK_TEST_LEG_SETTLE_S", 0.0)
    d = _daemon()
    # Shift no longer blocks anything; an implausible speed still does, since
    # it means the frames we are decoding are garbage.
    st = _active_state(shift=ShiftPosition.REVERSE, speed_mph=250,
                       drive_mode=DriveMode.NORMAL)
    d._state = st
    d._controller = _ProbeController(st)

    d._run_probe(DriveMode.HOLD)

    res = d._probe_result
    assert res["verdict"] == "BLOCKED"
    assert res["ok"] is False
    assert d._controller.calls == []         # never tapped


def test_run_probe_arms_and_disarms_the_per_tap_trace(monkeypatch):
    monkeypatch.setattr(daemon_mod, "WALK_TEST_LEG_SETTLE_S", 0.0)
    d = _daemon()
    st = _active_state(shift=ShiftPosition.PARK, drive_mode=DriveMode.NORMAL)
    d._state = st

    seen = []

    class _TracingController(_ProbeController):
        def switch_to(self, target, force=False):
            d._log_walk_tap(1, target)       # emulate the real tap_observer
            seen.append(d._trace_active)
            return super().switch_to(target, force)

    d._controller = _TracingController(st)
    d._run_probe(DriveMode.SPORT)

    assert seen == [True]                    # trace live during the walk
    assert d._trace_active is False          # cleared afterwards
    assert d._trace_tag == "probe"
    assert d._probe_result["taps_trace"][0]["tap"] == 1


# --- reload ----------------------------------------------------------
_RELOAD_YAML = (
    "policy:\n  default_position: hold-soc\n  hold_threshold_percent: 20\n"
    "  bar_failsafe_raw: 8\n"
    "soc_poll:\n  enabled: true\n  period_seconds: 15\n"
)


def test_reload_without_path():
    reply = _daemon()._handle_command("reload", {})
    assert reply["ok"] is False
    assert "reload unavailable" in reply["error"]


def test_reload_rereads_file_and_keeps_the_selector_position(tmp_path):
    cfg = tmp_path / "c.yaml"
    cfg.write_text(_RELOAD_YAML)
    d = _daemon(config_path=str(cfg))
    d._handle_command("setpoint", {"mode": "mountain"})  # driver's live choice
    d._walk_settle_until = time.monotonic() + 999
    reply = d._handle_command("reload", {})
    assert reply["ok"] is True
    assert reply["setpoint"] == "mountain"  # survives the reload
    assert reply["floor_latched"] is False
    assert d._config.policy.hold_threshold_percent == 20
    assert d._walk_settle_until == 0.0  # re-evaluate against the new policy now


def test_reload_bad_config_reports_error(tmp_path):
    cfg = tmp_path / "bad.yaml"
    cfg.write_text("policy: {default_position: banana}\n")
    d = _daemon(config_path=str(cfg))
    reply = d._handle_command("reload", {})
    assert reply["ok"] is False
    assert "reload failed" in reply["error"]


# --- charge-sustaining block ------------------------------------------
#
# The 2026-09-05 drive: restart on a written-off pack and the car comes up
# with the engine running in NORMAL and no HOLD on the menu. Without this the
# daemon walked, failed, and walked again every 10 s cooldown all drive.

def _spent_state(**kw):
    kw.setdefault("drive_mode", DriveMode.NORMAL)
    kw.setdefault("shift", ShiftPosition.DRIVE)
    kw.setdefault("engine_state", EngineState.RUNNING)
    return _active_state(**kw)


def test_reconcile_does_not_tap_when_the_menu_has_no_hold():
    d = _daemon(position="hold-now")
    d._state = _spent_state(soc_percent=21.0)
    d._gate = _FakeGate(RequestOutcome(True, 1, False, "ok"))
    d._reconcile()
    assert d._gate.request_calls == []
    assert d._last_action.endswith("ICE no-hold")
    assert d._status_snapshot()["ice_block"] is not None


def test_reconcile_resumes_once_the_engine_stops():
    d = _daemon(position="hold-now")
    d._gate = _FakeGate(RequestOutcome(True, 1, False, "ok"))
    d._state = _spent_state(soc_percent=21.0)
    d._reconcile()
    assert d._gate.request_calls == []
    d._state = _spent_state(soc_percent=21.0, engine_state=EngineState.OFF)
    d._reconcile()
    assert d._gate.request_calls == [DriveMode.HOLD]
    assert d._status_snapshot()["ice_block"] is None


def test_the_block_is_logged_on_the_edges_not_every_pass(caplog):
    """A 1 Hz reconcile loop with a stuck block would otherwise fill the
    journal for the rest of the drive."""
    d = _daemon(position="hold-now")
    d._gate = _FakeGate(RequestOutcome(True, 1, False, "ok"))
    d._state = _spent_state(soc_percent=21.0)
    with caplog.at_level("INFO", logger="voltdmf.daemon"):
        for _ in range(5):
            d._reconcile()
        assert sum("holding off" in r.message for r in caplog.records) == 1
        d._state = _spent_state(soc_percent=21.0, engine_state=EngineState.OFF)
        d._reconcile()
        assert sum("block cleared" in r.message for r in caplog.records) == 1


def test_the_lcd_selector_carries_the_block():
    d = _daemon(position="hold-now")
    d._state = _spent_state(soc_percent=21.0)
    d._gate = _FakeGate(RequestOutcome(True, 1, False, "ok"))
    assert d._lcd_selector()["ice_blocked"] is False
    d._reconcile()
    assert d._lcd_selector()["ice_blocked"] is True


def test_status_snapshot_reports_the_engine_read():
    d = _daemon()
    d._state = _spent_state(soc_percent=21.0)
    d._state.note_engine_run_counter(0x0102)
    d._gate = _FakeGate(RequestOutcome(False, 0, False, ""))
    snap = d._status_snapshot()
    json.dumps(snap)  # EngineState is a str enum -- must stay serialisable
    assert snap["engine_state"] == "running"
    assert snap["engine_running"] is True
    assert snap["engine_run_counter"] == 0x0102


# --- status snapshot -------------------------------------------------
def test_status_snapshot_is_json_serialisable():
    d = _daemon()
    d._state = _active_state(soc_percent=42, speed_mph=15,
                             drive_mode=DriveMode.NORMAL,
                             shift=ShiftPosition.DRIVE)
    d._gate = _FakeGate(RequestOutcome(False, 0, False, ""))
    snap = d._status_snapshot()
    json.dumps(snap)  # must not raise
    assert snap["armed"] is True
    assert snap["transmit_enabled"] is True
    assert snap["drive_mode"] == "normal"
    assert snap["setpoint"] == "hold-soc"
    assert snap["position_index"] == 1
    assert snap["cycle"] == ["hold-soc", "hold-now", "mountain", "off"]
    assert snap["floor_latched"] is False
    assert "dry_run" not in snap


def test_status_snapshot_reports_ignition_on():
    d = _daemon()
    d._state = _active_state()  # marks both bus_active and ignition_on
    d._gate = _FakeGate(RequestOutcome(False, 0, False, ""))
    assert d._status_snapshot()["ignition_on"] is True


def test_status_snapshot_reports_ignition_off_in_the_rap_window():
    """bus_active alone would still read True here -- ignition_on is the
    field that actually distinguishes RAP (Session 13/14)."""
    d = _daemon()
    d._state = _active_state()
    d._state.last_ignition_signal_monotonic = None
    d._gate = _FakeGate(RequestOutcome(False, 0, False, ""))
    snap = d._status_snapshot()
    assert snap["bus_active"] is True
    assert snap["ignition_on"] is False


def test_unhandled_command_name():
    reply = _daemon()._handle_command("frobnicate", {})
    assert reply["ok"] is False


# --- CanInterface transmit gate ------------------------------------
def test_can_tx_gate_suppresses_when_false():
    iface = CanInterface.__new__(CanInterface)
    iface._tx_gate = lambda: False
    iface._bus = None
    assert iface._tx_suppressed() is True
    # send takes the no-op path (no bus needed, no RuntimeError)
    iface.send_mode_button_press()


def test_can_tx_gate_allows_when_true():
    iface = CanInterface.__new__(CanInterface)
    iface._tx_gate = lambda: True
    iface._bus = None
    assert iface._tx_suppressed() is False


def test_can_tx_gate_absent_means_enabled():
    iface = CanInterface.__new__(CanInterface)
    iface._tx_gate = None
    assert iface._tx_suppressed() is False


# --- LCD watch-screen selector ------------------------------------------
def test_lcd_selector_reports_soc_fresh_for_a_live_poll():
    d = _daemon()
    d._state = _active_state(soc_percent=61.0)
    assert d._lcd_selector()["soc_fresh"] is True


def test_lcd_selector_reports_soc_not_fresh_when_stale():
    d = _daemon()
    d._state = _active_state(soc_percent=61.0)
    d._state.soc_percent_monotonic -= 999  # well past poll_stale_s
    assert d._lcd_selector()["soc_fresh"] is False


def test_lcd_selector_reports_soc_not_fresh_off_the_bar_failsafe():
    """A reading sourced from the 0x096 proxy, not the poll, is never 'fresh'
    -- the watch screen must flag it even if it arrived a second ago."""
    d = _daemon()
    d._state = VehicleState(soc_bar_raw=9)
    d._state.mark_signal_seen()
    assert d._lcd_selector()["soc_fresh"] is False


def test_lcd_selector_reports_the_position_and_floor():
    d = _daemon(position="hold-now")
    d._state = _active_state()
    snap = d._lcd_selector()
    assert snap["label"] == "hold-now"
    assert snap["index"] == 2
    assert snap["cycle_len"] == 4
    assert snap["floor_latched"] is False


# --- retry backoff: give up on a target the car will not take ----------
#
# The level-triggered reconciler has no memory of its own: "mode != target"
# stays true forever if the walk never lands, so before this the only thing
# between it and a whole drive of 10 s tap bursts was the cooldown. The ICE
# block covers the one failure we understand; this covers the rest.

def _walking(position="mountain", *, presses=1, sent=True):
    """A daemon whose selector wants MOUNTAIN and whose car reads NORMAL, with
    a gate that reports ``presses`` taps on the wire every time."""
    d = _daemon(position=position)
    d._state = _active_state(shift=ShiftPosition.DRIVE,
                             drive_mode=DriveMode.NORMAL)
    d._gate = _FakeGate(RequestOutcome(sent, presses, not sent, "walked"))
    return d


def _passes(d, n):
    for _ in range(n):
        d._walk_settle_until = 0.0   # skip the post-walk settle
        d._reconcile()


def test_it_stops_walking_after_the_attempt_budget_is_spent():
    d = _walking()
    _passes(d, 6)
    assert d._gate.request_calls == [DriveMode.MOUNTAIN] * 3
    assert d._status_snapshot()["give_up"] is not None


def test_a_walk_that_failed_mid_menu_still_burns_an_attempt():
    """sent=False but taps went out -- the case the closed loop raises on."""
    d = _walking(presses=12, sent=False)
    _passes(d, 6)
    assert len(d._gate.request_calls) == 3


def test_a_walk_the_gate_never_dispatched_costs_nothing():
    """Cooldown / precondition blocks report 0 presses: not an attempt."""
    d = _walking(presses=0, sent=False)
    _passes(d, 6)
    assert len(d._gate.request_calls) == 6
    assert d._status_snapshot()["give_up"] is None


def test_the_count_clears_when_the_car_reaches_the_mode():
    d = _walking()
    _passes(d, 2)
    d._state.drive_mode = DriveMode.MOUNTAIN     # the commit landed
    _passes(d, 1)
    assert d._attempts.attempts == 0
    d._state.drive_mode = DriveMode.NORMAL       # driver bumped it back out
    _passes(d, 3)
    assert len(d._gate.request_calls) == 5       # 2 + a fresh budget of 3


def test_giving_up_is_logged_once_not_every_pass(caplog):
    d = _walking()
    with caplog.at_level("INFO", logger="voltdmf.daemon"):
        _passes(d, 8)
    assert sum("giving up:" in r.message for r in caplog.records) == 1


def test_a_sw1_tap_is_the_drivers_way_out():
    d = _walking()
    _passes(d, 5)
    d._handle_command("setpoint", {"mode": "mountain"})   # same detent, retap
    _passes(d, 1)
    assert len(d._gate.request_calls) == 4
    assert d._status_snapshot()["give_up"] is None


def test_set_mode_by_hand_unsticks_a_given_up_target():
    d = _walking()
    _passes(d, 5)
    d._handle_command("set-mode", {"mode": "mountain"})
    assert d._attempts.target is None
    _passes(d, 1)
    assert len(d._gate.request_calls) == 5   # the manual one, then a fresh walk


def test_arming_hands_the_budget_back():
    d = _walking()
    _passes(d, 5)
    d._handle_command("arm", {})
    _passes(d, 1)
    assert len(d._gate.request_calls) == 4


def test_the_bus_going_quiet_ends_the_key_cycle():
    d = _walking()
    _passes(d, 5)
    d._state.last_signal_monotonic = time.monotonic() - 60.0  # ignition off
    _passes(d, 1)
    d._state.mark_signal_seen()                               # and back on
    _passes(d, 1)
    assert len(d._gate.request_calls) == 4


def test_the_rap_window_also_ends_the_key_cycle():
    """Session 13/14: bus_active alone stays True through RAP (door not
    opened), so a spent budget must also hand itself back on 0x3ED alone
    going stale -- otherwise a driver who cycles the key inside the RAP
    window comes back to a budget that thinks it already tried and failed."""
    d = _walking()
    _passes(d, 5)
    assert len(d._gate.request_calls) == 3          # budget spent
    d._state.last_ignition_signal_monotonic = None  # RAP: bus stays live, 0x3ED gone
    _passes(d, 1)
    d._state.mark_ignition_seen()                    # ignition confirmed back on
    _passes(d, 1)
    assert len(d._gate.request_calls) == 4


def test_the_selector_dict_carries_the_give_up_for_the_lcd():
    d = _walking()
    assert d._lcd_selector()["gave_up"] is False
    _passes(d, 5)
    assert d._lcd_selector()["gave_up"] is True


def test_the_attempt_count_is_json_serialisable():
    d = _walking()
    _passes(d, 2)
    snap = json.loads(json.dumps(d._status_snapshot()))
    assert snap["attempts"] == {"target": "mountain", "attempts": 2,
                                "max_attempts": 3, "gave_up": False}
