mlh5599/volt-drive-mode-fixer/tests/test_canio.py

"""RX-reader tests: the 0x1F4 status/cursor reads must return the NEWEST
queued frame, not the oldest.

Field session 3 (2026-08-29): the closed-loop walk committed MOUNTAIN when
asked for SPORT because ``read_menu_cursor`` returned a stale frame from the
RX backlog -- ``recv()`` hands back the oldest queued frame first, and the
socket buffers 0x1F4 at ~40 Hz while ``send_mode_button_press`` runs.
"""

import pytest

from voltdmf import canio as canio_module
from voltdmf import signals
from voltdmf.canio import MODE_STATUS_ADDR, CanInterface, _DecodeListener
from voltdmf.signals import DriveMode, ShiftPosition
from voltdmf.state import VehicleState


class _Frame:
    def __init__(self, arbitration_id, data):
        self.arbitration_id = arbitration_id
        self.data = data


class _FakeBus:
    """recv() pops the oldest frame, then returns None (queue drained)."""

    def __init__(self, frames):
        self._frames = list(frames)
        self.recv_calls = 0

    def recv(self, timeout=0.0):
        self.recv_calls += 1
        return self._frames.pop(0) if self._frames else None

    def shutdown(self):
        self.shut_down = True


def _cursor_frame(byte4):
    return _Frame(MODE_STATUS_ADDR, bytes((0x00, 0x00, 0x00, 0x00, byte4, 0x00)))


def _iface_with(frames):
    iface = CanInterface.__new__(CanInterface)
    iface._bus = _FakeBus(frames)
    return iface


def test_read_menu_cursor_returns_newest_not_oldest():
    # backlog: cursor stepped NORMAL -> SPORT -> MOUNTAIN; newest is MOUNTAIN
    iface = _iface_with([
        _cursor_frame(0x00),   # NORMAL  (stale)
        _cursor_frame(0x80),   # SPORT   (stale -- this is what the old code returned)
        _cursor_frame(0x40),   # MOUNTAIN (current)
    ])
    assert iface.read_menu_cursor(timeout=0.1) is DriveMode.MOUNTAIN


def test_read_menu_cursor_drains_the_whole_backlog():
    bus = _FakeBus([_cursor_frame(0x00), _cursor_frame(0x80), _cursor_frame(0x20)])
    iface = CanInterface.__new__(CanInterface)
    iface._bus = bus
    assert iface.read_menu_cursor(timeout=0.1) is DriveMode.HOLD
    # 3 frames + 1 None to learn the queue is empty
    assert bus.recv_calls == 4


def test_read_menu_cursor_ignores_other_ids():
    iface = _iface_with([
        _Frame(0x1E1, bytes(7)),
        _cursor_frame(0x80),
        _Frame(0x206, bytes(8)),
    ])
    assert iface.read_menu_cursor(timeout=0.1) is DriveMode.SPORT


def test_read_menu_cursor_none_when_no_status_frame():
    iface = _iface_with([_Frame(0x1E1, bytes(7)), _Frame(0x206, bytes(8))])
    assert iface.read_menu_cursor(timeout=0.05) is None


def test_read_drive_mode_returns_newest_committed_byte1():
    # byte 1 codes: 00 N / 80 S / 20 M / 08 H
    iface = _iface_with([
        _Frame(MODE_STATUS_ADDR, bytes((0x00, 0x00, 0, 0, 0, 0))),
        _Frame(MODE_STATUS_ADDR, bytes((0x00, 0x80, 0, 0, 0, 0))),
        _Frame(MODE_STATUS_ADDR, bytes((0x00, 0x20, 0, 0, 0, 0))),
    ])
    assert iface.read_drive_mode(timeout=0.1) is DriveMode.MOUNTAIN


# -- _DecodeListener: 0x1F4 byte 1 feeds VehicleState.drive_mode ---------
def test_decode_listener_populates_drive_mode_from_1f4():
    state = VehicleState()
    listener = _DecodeListener(state)
    assert state.drive_mode is None

    listener.on_message_received(
        _Frame(MODE_STATUS_ADDR, bytes((0x00, 0x20, 0, 0, 0, 0))))
    assert state.drive_mode is DriveMode.MOUNTAIN

    listener.on_message_received(
        _Frame(MODE_STATUS_ADDR, bytes((0x00, 0x80, 0, 0, 0, 0))))
    assert state.drive_mode is DriveMode.SPORT


def test_decode_listener_leaves_drive_mode_alone_on_unknown_byte1():
    state = VehicleState()
    state.drive_mode = DriveMode.HOLD
    listener = _DecodeListener(state)

    listener.on_message_received(
        _Frame(MODE_STATUS_ADDR, bytes((0x00, 0xFF, 0, 0, 0, 0))))
    assert state.drive_mode is DriveMode.HOLD  # undecodable -> unchanged


# -- _DecodeListener: 0x1F4 bytes 4+5 feed VehicleState.menu_cursor -----
#
# The cursor is ONE field spanning bytes 4 and 5, confirmed 2026-09-03 from a
# 2432-frame 0x1F4 capture across a full walk:
#     b4=0x00 b5=0x80  NORMAL      b4=0x40 b5=0x00  MOUNTAIN
#     b4=0x80 b5=0x00  SPORT       b4=0x20 b5=0x00  HOLD
#     b4=0x00 b5=0x00  menu CLOSED (no cursor)
# All 403 frames with b5 bit 7 set carried b4 == 0x00 -- zero exceptions -- so
# bit 7 is the NORMAL cursor code, not a separate "menu open" flag, and a
# frame with b4 != 0 AND bit 7 set does not occur on the wire.
_NORM = 0x80   # 0x1F4 byte 5: cursor is on NORMAL


def test_decode_listener_populates_menu_cursor_from_bytes_4_and_5():
    state = VehicleState()
    listener = _DecodeListener(state)
    assert state.menu_cursor is None

    listener.on_message_received(
        _Frame(MODE_STATUS_ADDR, bytes((0x00, 0x00, 0, 0, 0x40, 0x00, 0, 0))))
    assert state.menu_cursor is DriveMode.MOUNTAIN

    listener.on_message_received(
        _Frame(MODE_STATUS_ADDR, bytes((0x00, 0x00, 0, 0, 0x20, 0x00, 0, 0))))
    assert state.menu_cursor is DriveMode.HOLD

    # NORMAL is carried by byte 5, not byte 4
    listener.on_message_received(
        _Frame(MODE_STATUS_ADDR, bytes((0x00, 0x00, 0, 0, 0x00, _NORM, 0, 0))))
    assert state.menu_cursor is DriveMode.NORMAL


def test_decode_listener_clears_cursor_when_the_menu_closes():
    """b4=0 b5=0 is menu-CLOSED and must null the cursor.

    Latching the last reading instead would let a stale value match the walk's
    target and stop it early -- and it is exactly what made a closed-loop walk
    read a cursor that was no longer on screen (session 10).
    """
    state = VehicleState()
    listener = _DecodeListener(state)
    listener.on_message_received(
        _Frame(MODE_STATUS_ADDR, bytes((0x00, 0x00, 0, 0, 0x80, 0x00, 0, 0))))
    assert state.menu_cursor is DriveMode.SPORT

    listener.on_message_received(
        _Frame(MODE_STATUS_ADDR, bytes((0x00, 0x08, 0, 0, 0x00, 0x00, 0, 0))))
    assert state.menu_cursor is None                # menu closed
    assert state.drive_mode is DriveMode.HOLD       # byte 1 still decoded


def test_decode_listener_records_raw_cursor_and_open_hint_for_diagnostics():
    state = VehicleState()
    listener = _DecodeListener(state)

    # an unmapped byte-4 code: decoded cursor stays None, raw is still captured
    listener.on_message_received(
        _Frame(MODE_STATUS_ADDR, bytes((0x00, 0x00, 0, 0, 0x11, 0x00, 0, 0))))
    assert state.menu_cursor is None
    assert state.menu_cursor_raw == 0x11
    assert state.menu_open_hint is False

    # a real open frame -> hint True and the cursor decodes
    listener.on_message_received(
        _Frame(MODE_STATUS_ADDR, bytes((0x00, 0x00, 0, 0, 0x40, 0x00, 0, 0))))
    assert state.menu_cursor_raw == 0x40
    assert state.menu_open_hint is True


def test_decode_listener_ignores_short_frame_without_byte5():
    """A frame too short to carry byte 5 cannot resolve a cursor at all."""
    state = VehicleState()
    listener = _DecodeListener(state)
    listener.on_message_received(
        _Frame(MODE_STATUS_ADDR, bytes((0x00, 0x00, 0, 0, 0x40, 0x00, 0, 0))))
    assert state.menu_cursor is DriveMode.MOUNTAIN

    listener.on_message_received(_Frame(MODE_STATUS_ADDR, bytes((0x00, 0x08))))
    assert state.menu_cursor is None                # cannot decode -> no cursor
    assert state.drive_mode is DriveMode.HOLD


# -- the live 0x1E1 the tracking-echo press mirrors ---------------------
#
# The press path owns its OWN socket (``_echo_bus``, hardware-filtered to
# 0x1E1) rather than sharing ``_bus`` with the daemon's can.Notifier. Two
# earlier designs were measured on-vehicle 2026-09-03 and both lost taps:
#   * recv() on the shared socket -- 21% dropped taps, because SocketCAN gives
#     each frame to exactly one of the two readers.
#   * reading the frame the listener stashed in VehicleState -- WORSE, 36%,
#     because the Notifier thread lags on a busy bus and the stashed frame was
#     already stale; a stale counter is the frozen-counter echo the cluster
#     ignored in session 2.
#   * a dedicated 0x1E1-filtered socket, read only during a press -- still
#     stale, and worst of the three at 58% (2 MISSes in 12 probes). Nothing
#     drains it between taps, so it queued ~52 frames over the 1.6 s walk gap
#     and recv() returned the oldest, 1582 ms behind the module.
# All three are the same root cause in different disguises: the echo carried a
# spent counter. The fix is a second bound socket (SocketCAN fans every frame
# out, so no contention) that is DRAINED before each press (so no staleness).
class _EchoFakeBus:
    """Models a socket with a stale BACKLOG and later ARRIVALS.

    The distinction is the whole point of the drain. ``recv(timeout=0)`` is a
    non-blocking peek at what is already queued -- on the car that is up to
    1.6 s of accumulated 0x1E1 (~52 frames), every one of them carrying a
    counter the cluster has long since moved past. ``recv(timeout>0)`` blocks
    for the module's next transmission, which is the only frame the echo may
    mirror. A fake that cannot tell the two apart cannot test this.
    """

    def __init__(self, backlog=(), arrivals=()):
        self.backlog = list(backlog)
        self.arrivals = list(arrivals)
        self.sent = []
        self.recv_calls = 0

    def recv(self, timeout=0.0):
        self.recv_calls += 1
        queue = self.backlog if not timeout else self.arrivals
        return queue.pop(0) if queue else None

    def send(self, msg, timeout=None):
        self.sent.append(msg)

    def shutdown(self):
        self.shut_down = True


def _iface_with_echo(backlog=(), arrivals=()):
    iface = CanInterface.__new__(CanInterface)
    iface._bus = None            # must NOT be touched on the press path
    iface._echo_bus = _EchoFakeBus(backlog, arrivals)
    iface._tx_gate = None
    return iface


def test_next_button_frame_reads_the_echo_socket_not_the_shared_bus():
    payload = bytes((0x00, 0x11, 0x22, 0x33, 0x05, 0x66, 0x77))
    iface = _iface_with_echo(arrivals=[_Frame(0x1E1, payload)])
    # _bus is None: reaching for the shared socket here would raise
    assert iface._next_button_frame(0.05) == payload


def test_next_button_frame_discards_the_backlog_and_waits_for_the_next_frame():
    """The counter in a queued frame is already spent.

    Nothing reads this socket between taps, so it accumulates ~1.6 s of 0x1E1
    during the walk's inter-tap gap. Echoing any of that mirrors a counter the
    module has moved ~52 counts past -- the frozen-counter echo the cluster
    ignores, measured on-vehicle 2026-09-04 as a menu that would not open for
    11 straight taps.
    """
    stale = [_Frame(0x1E1, bytes((0x00, 0x11, 0x22, 0x33, n, 0x66, 0x77)))
             for n in range(5)]
    fresh = bytes((0x00, 0x11, 0x22, 0x33, 0x09, 0x66, 0x77))
    iface = _iface_with_echo(backlog=stale, arrivals=[_Frame(0x1E1, fresh)])
    assert iface._next_button_frame(0.05) == fresh
    assert iface._echo_bus.backlog == []          # drained, not left to rot


def test_next_button_frame_does_not_drain_the_frame_it_returns():
    """The drain is non-blocking, so it must not eat a live arrival.

    Once the queue is empty the press has to reply into the gap behind the
    very next frame, not the one after it.
    """
    first = bytes((0x00, 0x11, 0x22, 0x33, 0x05, 0x66, 0x77))
    second = bytes((0x00, 0x11, 0x22, 0x33, 0x06, 0x66, 0x77))
    iface = _iface_with_echo(
        arrivals=[_Frame(0x1E1, first), _Frame(0x1E1, second)])
    assert iface._next_button_frame(0.05) == first
    assert iface._next_button_frame(0.05) == second


def test_next_button_frame_skips_a_short_frame():
    """< 7 B cannot carry the counter tail the echo has to mirror."""
    good = bytes((0x00, 0x11, 0x22, 0x33, 0x05, 0x66, 0x77))
    iface = _iface_with_echo(
        arrivals=[_Frame(0x1E1, bytes(4)), _Frame(0x1E1, good)])
    assert iface._next_button_frame(0.05) == good


def test_next_button_frame_times_out_when_the_bus_is_quiet():
    iface = _iface_with_echo()
    assert iface._next_button_frame(0.02) is None


def test_next_button_frame_requires_open():
    iface = CanInterface.__new__(CanInterface)
    iface._echo_bus = None
    with pytest.raises(RuntimeError):
        iface._next_button_frame(0.01)


def test_press_mirrors_the_live_frame_and_sends_on_the_echo_socket():
    live = bytes((0x00, 0x11, 0x22, 0x33, 0x05, 0x66, 0x77))
    iface = _iface_with_echo(arrivals=[_Frame(0x1E1, live)] * 8)
    iface.send_mode_button_press()
    sent = iface._echo_bus.sent
    assert len(sent) == canio_module.PRESS_TRACK_FRAMES
    for msg in sent:
        assert msg.arbitration_id == canio_module.MODE_BUTTON_ADDR
        # byte 4 bit 7 set, everything else mirrored verbatim
        assert bytes(msg.data) == live[:4] + bytes(
            (live[4] | canio_module.PRESS_BYTE4,)) + live[5:]


def test_press_falls_back_to_the_static_frame_on_a_quiet_bus():
    iface = _iface_with_echo([])
    iface.send_mode_button_press()
    assert [bytes(m.data) for m in iface._echo_bus.sent] == [
        canio_module._STATIC_PRESS_PAYLOAD]


def test_press_transmits_nothing_while_disarmed():
    live = bytes((0x00, 0x11, 0x22, 0x33, 0x05, 0x66, 0x77))
    iface = _iface_with_echo(arrivals=[_Frame(0x1E1, live)] * 8)
    iface._tx_gate = lambda: False
    iface.send_mode_button_press()
    assert iface._echo_bus.sent == []


def test_start_rx_leaves_the_press_path_on_its_own_socket():
    """The Notifier takes ``_bus``; ``_echo_bus`` must be untouched by it."""
    state = VehicleState()
    iface = CanInterface.__new__(CanInterface)
    iface._bus = _FakeBus([])
    iface._echo_bus = _FakeBus([])
    iface._notifier = None

    captured = {}

    class _FakeNotifier:
        def __init__(self, bus, listeners):
            captured["bus"] = bus
            captured["listeners"] = listeners

        def stop(self):
            captured["stopped"] = True

    real_notifier = canio_module.can.Notifier
    canio_module.can.Notifier = _FakeNotifier
    try:
        echo = iface._echo_bus
        iface.start_rx(state)
        assert captured["bus"] is iface._bus     # Notifier owns the SHARED bus
        assert iface._echo_bus is echo           # press socket untouched
        iface.close()
        assert captured["stopped"] is True
        assert echo.shut_down is True            # both sockets closed
        assert iface._echo_bus is None
    finally:
        canio_module.can.Notifier = real_notifier


def test_decode_listener_ignores_non_signal_frames():
    state = VehicleState()
    listener = _DecodeListener(state)
    listener.on_message_received(_Frame(0x1E1, bytes(7)))
    listener.on_message_received(_Frame(0x206, bytes(8)))  # not on this bus
    assert state.drive_mode is None
    assert state.shift is ShiftPosition.UNKNOWN
    assert state.soc_percent is None


# -- _DecodeListener: SOC poll reply (0x7E8..0x7EF) --------------------
def test_decode_listener_folds_in_a_uds_soc_reply():
    state = VehicleState()
    listener = _DecodeListener(state)
    # 7E8#04 62 005B 54 ...  -> raw 0x54 == 32.9 %
    listener.on_message_received(
        _Frame(0x7E8, bytes((0x04, 0x62, 0x00, 0x5B, 0x54, 0, 0, 0))))
    assert state.soc_raw == 0x54
    assert state.soc_percent == signals.uds_soc_percent(0x54)
    assert state.soc_source == "poll"
    assert state.uds_resp_id == 0x7E8
    assert state.uds_replies == 1
    assert state.soc_percent_monotonic is not None


def test_decode_listener_counts_a_negative_response():
    state = VehicleState()
    listener = _DecodeListener(state)
    listener.on_message_received(
        _Frame(0x7E8, bytes((0x03, 0x7F, 0x22, 0x31, 0, 0, 0, 0))))
    assert state.uds_nrcs == 1
    assert state.soc_percent is None


# -- _DecodeListener: 0x096 byte 3 coarse proxy ---------------------
def test_decode_listener_reads_the_soc_bar_proxy():
    state = VehicleState()
    listener = _DecodeListener(state)
    listener.on_message_received(
        _Frame(0x096, bytes((0x00, 0xF0, 0x0A, 0x09, 0, 0, 0, 0))))
    assert state.soc_bar_raw == 9
    # a non-mux 0x096 frame must not clobber it
    listener.on_message_received(
        _Frame(0x096, bytes((0x00, 0x00, 0x00, 0x00, 0, 0, 0, 0))))
    assert state.soc_bar_raw == 9


# -- send_soc_poll: the second (ungated) transmit path -----------------
class _SendBus:
    def __init__(self):
        self.sent = []

    def send(self, msg, timeout=None):
        self.sent.append(msg)


def test_send_soc_poll_emits_the_fixed_request_frame():
    iface = CanInterface.__new__(CanInterface)
    iface._bus = bus = _SendBus()
    iface._tx_gate = lambda: True
    iface.send_soc_poll(0x7E0)
    assert len(bus.sent) == 1
    msg = bus.sent[0]
    assert msg.arbitration_id == 0x7E0
    assert bytes(msg.data) == bytes.fromhex("0322005B55555555")
    assert msg.is_extended_id is False


def test_send_soc_poll_runs_even_while_disarmed():
    iface = CanInterface.__new__(CanInterface)
    iface._bus = bus = _SendBus()
    iface._tx_gate = lambda: False  # disarmed
    iface.send_soc_poll(0x7E4)
    assert len(bus.sent) == 1
    assert bus.sent[0].arbitration_id == 0x7E4


# -- _DecodeListener: the engine frames (0x4C5 / 0x3F9) -----------------
def test_decode_listener_populates_engine_state_from_4c5():
    state = VehicleState()
    listener = _DecodeListener(state)
    listener.on_message_received(
        _Frame(signals.ENGINE_STATE_ADDR, bytes.fromhex("0000490000")))
    assert state.engine_state is signals.EngineState.OFF
    listener.on_message_received(
        _Frame(signals.ENGINE_STATE_ADDR, bytes.fromhex("0000DD0000")))
    assert state.engine_state is signals.EngineState.RUNNING


def test_decode_listener_tracks_the_3f9_run_counter():
    state = VehicleState()
    listener = _DecodeListener(state)
    listener.on_message_received(
        _Frame(signals.ENGINE_RUN_COUNTER_ADDR,
               bytes.fromhex("0000022851598964")))
    assert state.engine_run_counter == 0x0002
    assert state.engine_counter_moved_monotonic is None
    listener.on_message_received(
        _Frame(signals.ENGINE_RUN_COUNTER_ADDR,
               bytes.fromhex("00000A2851598964")))
    assert state.engine_run_counter == 0x000A
    assert state.engine_counter_moved_monotonic is not None


def test_decode_listener_ignores_a_short_engine_frame():
    state = VehicleState()
    listener = _DecodeListener(state)
    listener.on_message_received(_Frame(signals.ENGINE_STATE_ADDR, b"\x00\x00"))
    listener.on_message_received(_Frame(signals.ENGINE_RUN_COUNTER_ADDR, b"\x00"))
    assert state.engine_state is signals.EngineState.UNKNOWN
    assert state.engine_run_counter is None


# -- _DecodeListener: ignition (0x3ED presence, Session 14) --------------
def test_decode_listener_marks_ignition_seen_from_3ed():
    state = VehicleState()
    assert state.ignition_on is False
    listener = _DecodeListener(state)
    listener.on_message_received(
        _Frame(signals.IGNITION_ADDR, bytes.fromhex("800000000000")))
    assert state.ignition_on is True
