mlh5599/volt-drive-mode-fixer/tests/test_safety.py

import pytest

from voltdmf.modecycle import ModeSwitchFailed
from voltdmf.safety import (AttemptBudget, MODE_SWITCH_COOLDOWN_S,
                            SafetyGate)
from voltdmf.signals import DriveMode, EngineState, ShiftPosition
from voltdmf.state import VehicleState


class FakeController:
    def __init__(self, result=1, raises=None):
        self.result = result
        self.raises = raises
        self.calls = 0

    def switch_to(self, target):
        self.calls += 1
        if self.raises is not None:
            raise self.raises
        return self.result


class FakeClock:
    def __init__(self):
        self.t = 1000.0

    def __call__(self):
        return self.t


def _state(**kw):
    # Default to a drivable car: DRIVE clears the shift precondition, so tests
    # that aren't about shift gating don't have to spell it out. SafetyGate
    # now blocks on UNKNOWN by default (decode_shift is confirmed on-vehicle).
    kw.setdefault("shift", ShiftPosition.DRIVE)
    st = VehicleState(**kw)
    st.mark_signal_seen()
    st.mark_ignition_seen()
    return st


def test_blocks_when_bus_quiet():
    ctl = FakeController()
    gate = SafetyGate(ctl)
    assert gate.request(DriveMode.HOLD, VehicleState()) is False
    assert ctl.calls == 0


def test_blocks_in_the_rap_window_even_though_the_bus_is_active():
    """The case Session 13/14 exist for: bus_active alone stays True through
    the retained-power window (ignition off, door not opened), so ignition
    must be its own precondition -- see the SafetyGate._precondition_failure
    docstring."""
    ctl = FakeController()
    gate = SafetyGate(ctl)
    st = _state()
    st.last_ignition_signal_monotonic = None  # never seen 0x3ED this cycle
    outcome = gate.request_verbose(DriveMode.HOLD, st)
    assert outcome.sent is False
    assert outcome.blocked is True
    assert "ignition" in outcome.reason
    assert ctl.calls == 0


def test_allows_when_ignition_is_confirmed_on():
    ctl = FakeController(result=1)
    gate = SafetyGate(ctl)
    assert gate.request(DriveMode.HOLD, _state()) is True
    assert ctl.calls == 1


@pytest.mark.parametrize("shift", list(ShiftPosition))
def test_shift_position_never_blocks_a_switch(shift):
    """PRNDL is not a precondition. The mode button is the centre-stack
    energy-mode menu, not a gear selector -- pressing it in Park is what a
    driver does, and gating on shift only stopped the reconciler settling
    the mode before the car moved."""
    ctl = FakeController()
    gate = SafetyGate(ctl)
    assert gate.request(DriveMode.HOLD, _state(shift=shift)) is True
    assert ctl.calls == 1


def test_switches_while_parked():
    """The case that used to be blocked and is now the point: sitting in the
    driveway with the car on, the daemon can walk to the target mode."""
    ctl = FakeController(result=3)
    gate = SafetyGate(ctl)
    outcome = gate.request_verbose(DriveMode.HOLD,
                                   _state(shift=ShiftPosition.PARK, speed_mph=0))
    assert outcome.sent is True
    assert outcome.blocked is False


def test_blocks_on_implausible_speed():
    ctl = FakeController()
    gate = SafetyGate(ctl)
    assert gate.request(DriveMode.HOLD, _state(speed_mph=250)) is False
    assert ctl.calls == 0


def test_happy_path():
    ctl = FakeController(result=2)
    gate = SafetyGate(ctl)
    assert gate.request(DriveMode.HOLD, _state(speed_mph=30)) is True
    assert ctl.calls == 1


def test_cooldown_suppresses_second_burst():
    ctl = FakeController()
    clock = FakeClock()
    gate = SafetyGate(ctl, cooldown_s=60.0, monotonic=clock)
    assert gate.request(DriveMode.HOLD, _state()) is True
    clock.t += 30.0
    assert gate.request(DriveMode.HOLD, _state()) is False
    assert ctl.calls == 1
    clock.t += 31.0
    assert gate.request(DriveMode.HOLD, _state()) is True
    assert ctl.calls == 2


def test_fail_passive_on_controller_error():
    ctl = FakeController(raises=RuntimeError("boom"))
    clock = FakeClock()
    gate = SafetyGate(ctl, monotonic=clock)
    # no exception propagates
    assert gate.request(DriveMode.HOLD, _state()) is False
    # cooldown still applied so we don't hammer a failing path
    clock.t += MODE_SWITCH_COOLDOWN_S / 2
    assert gate.request(DriveMode.HOLD, _state()) is False
    assert ctl.calls == 1


def test_default_cooldown_walks_a_manual_change_back_within_seconds():
    """The re-assert budget. Session 11 landed 35/35 legs in <=4 taps, so a
    minute-long cooldown would strand a driver who bumped the stalk in the
    wrong mode for most of that minute."""
    assert MODE_SWITCH_COOLDOWN_S <= 15.0
    ctl = FakeController()
    clock = FakeClock()
    gate = SafetyGate(ctl, monotonic=clock)
    assert gate.request(DriveMode.HOLD, _state()) is True
    clock.t += MODE_SWITCH_COOLDOWN_S + 0.1
    assert gate.request(DriveMode.HOLD, _state()) is True   # driver bumped it
    assert ctl.calls == 2


def test_zero_presses_reports_false():
    ctl = FakeController(result=0)
    gate = SafetyGate(ctl)
    assert gate.request(DriveMode.HOLD, _state()) is False
    assert ctl.calls == 1
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
