mlh5599/volt-drive-mode-fixer/(commit log)

2026-08-23 Add initial project design for Volt drive-mode automation
    Documents the CAN bus approach, hardware BOM, and phased plan for
    auto-switching drive mode based on EV battery SOC.
2026-08-23 Add configurable on-start/SOC-threshold triggers, note Trip Mode roadmap
    Replaces the single SOC-triggered Mountain Mode design with two
    independently configurable strategies (on-start -> Mountain, SOC
    threshold -> Hold), sharing one injector. Notes Trip Mode (speed-based
    Hold, from vix597/chevy-volt-trip-mode) as future work.
2026-08-23 Correct Gen 1 mode control: cycling button, not discrete Mountain switch
    Owner confirmed Gen 1 uses the same style cycling button as Gen 2
    (Normal->Sport->Mountain->Hold), not a discrete Mountain-only button.
    Reworks the injector into a mode-cycle controller that computes press
    count from current mode, elevates current-mode readback from
    nice-to-have to a hard requirement, and notes 0x1E1 as an untested but
    likely-transferable candidate signal. Also records accurate per-mode
    battery behavior from the owner.
2026-08-23 Document hardware alternatives considered for the CAN interface
    Adds a comparison of raw-CAN devices (CANable, PCAN-USB, Kvaser,
    PiCAN2/3, Macchina M2, DIY ESP32, Freematics ONE+) against the chosen
    comma.ai panda, explaining why generic OBD2 adapters are ruled out and
    why panda wins on precedent and DR4 fit.
2026-08-23 Correct panda connector: OBD-C, not native OBD-II, needs OBD2C adapter
    Comma's own OBD-C cable connects to their harness box, not a vehicle's
    OBD-II port. Add the third-party konik.ai OBD2C connector to the BOM
    as the actual part needed to bridge panda's OBD-C port to the car's
    standard OBD-II port, and note the open-source (dzid26/OBD2C) DIY option.
2026-08-23 Switch hardware recommendation from panda to PiCAN2
    Sourcing the OBD2C adapter for panda proved impractical (EU-only
    warehouse, no US listings). PiCAN2 + Pi 3B avoids this entirely: it
    connects via a standard off-the-shelf OBD-II-to-DB9 cable available
    from US Amazon. Also drop the Mausberry-switch ignition-sense design in
    favor of powering from the car's switched accessory socket directly,
    paired with Raspberry Pi OS's overlay filesystem so an abrupt power
    cut on every drive cycle can't corrupt the SD card.
2026-08-23 Record hardware order: BOM with actual sources/prices, status update
    Hardware is ordered as of 2026-08-23. Lock the BOM to the specific
    purchased parts (Copperhill PiCAN2, Adafruit Pi 3B, iKKEGOL OBD-DB9
    cable) with purchase links and confirmed pinout, and mark both docs'
    status as "awaiting arrival" so the project picks up cleanly at Phase 1
    signal discovery once the parts show up.
2026-08-29 Scaffold the voltdmf daemon, discovery tools, and host config
    The repo was docs-only (DESIGN.md, README.md); this adds the code that
    DESIGN.md's phased plan describes. Everything hardware-dependent is a
    clearly-marked UNCONFIRMED / TODO_CALIBRATE constant with a `confirmed`
    flag, so nothing transmits against a guessed CAN ID until on-vehicle
    signal discovery (DESIGN.md Phase C) fills the values in.
    - voltdmf/ -- the daemon: config, signals (hardcoded struct decoders),
    state, triggers (on-start + SOC-threshold latch/re-arm), modecycle
    (press-count math over the NORMAL->SPORT->MOUNTAIN->HOLD cycle), safety
    (single narrow TX path, rate limit, preconditions, fail-passive), canio
    (Socket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
    [__main__.py, canio.py, config.py, cycle_modes.py, daemon.py, ignition_check.py, inject_test.py]
2026-08-29 Add on-vehicle field checklist for Phase A -> C.5
    A single printable checklist covering CAN bring-up (Phase A), signal
    discovery (Phase C), and the injection gate (Phase C.5) from DESIGN.md,
    plus the pack list and abort criteria. Kept generic - no host, network,
    or vehicle-identifying specifics - so it is usable by anyone doing the
    same work on a Gen 1 Volt.
    Claude-Session: https://claude.ai/code/session_019iryjcXxR4AWEM3qc7sdr8
2026-08-29 Phase C: confirm 0x1F4 drive-mode signal; start Phase C.5 injection
    On-vehicle session 1 (2026-08-29).
    Phase A: can0 comes up clean at 500 kbit/s, ERROR-ACTIVE, no fallback.
    Phase C -- current-mode STATUS signal CONFIRMED:
    0x1F4, 6-byte ~40 Hz body-module frame `00 <mode> 00 00 <ramp> <down>`.
    byte 1 = latched mode: NORMAL 0x00 / SPORT 0x80 / MOUNTAIN 0x20 / HOLD 0x08
    (720/720 frames steady per mode across a full button walk). byte 5 = 0x80
    button-down; byte 4 = post-release decay ramp. The Gen-2 candidate 0x1E1
    does not exist on this bus; retired.
    - signals.py: 0x1F4 in SIGNAL_IDS, drive_mode_status confirmed=True,
    new decode_drive_mode() + _DRIVE_MODE_BY_BYTE1.
    - canio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
    [canio.py, inject_test.py, signals.py, test_signals.py]
2026-08-29 Rework injection to burst-and-release with closed-loop verification
    Insight from the Gen 2 prior art (vix597/chevy-volt-trip-mode): it sends one
    press as a short burst of identical "button down" frames then STOPS -- the
    real steering module's own idle frames are the "button up" -- with a 0.75 s
    cooldown between bursts, and blind-counts (no status signal). That structure
    addresses both our symptoms.
    canio.py -- send_mode_button_press() is now burst-and-release:
    - burst of PRESS_BURST_FRAMES x byte5=0x80 at PRESS_FRAME_INTERVAL_S
    (default 45 @ 100 Hz = 0.45 s), then return; no release frame, no ramp.
    - new RELEASE_GAP_S = 0.75: callers must leave that much silence before
    the next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
    [canio.py, inject_test.py, modecycle.py]
2026-08-29 Retarget injection to 0x1E1 tracking-echo; document the menu-walk model
    Session 2 on-vehicle follow-up. The earlier "reflow the PiCAN2" call this
    session was wrong (owner: soldering is fine). The failed injection was
    software:
    - Wrong ID. 0x1F4 is the drive-mode status/echo (byte 1 = latched mode,
    still confirmed). Time-paced frames we sent on 0x1F4 collided same-ID
    with the body module's 40 Hz stream -> bit errors -> TEC to ERROR-PASSIVE.
    That "intermittent TX" was contention, not a bad joint.
    - 0x1E1 "ASCMSteeringButton" IS the button: byte 4 bit 7 = pressed. It was
    mis-ruled-out by diffing only bytes 0-3. A captured physical press is
    ~14 consecutive frames with bit 7 set, byte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
    [canio.py, inject_test.py, signals.py]
2026-08-29 Record the vehicle: 2014-2015 Volt (Gen 1), Premier trim
    Owner confirmed it is fine to note make / model / generation / year in the
    signals doc (unlike a VIN or plate, this is not identifying and it matters
    for the decode -- signal IDs and scaling shift by model year and market).
    Exact year is 2014 or 2015; both are late Gen 1 with the same powertrain.
    Claude-Session: https://claude.ai/code/session_01UrK9kTkXAsPGy9pJ537t6c
2026-08-29 Pin the vehicle year: 2014 Volt (Gen 1), Premier
    Owner confirmed the model year is 2014 (not "2014 or 2015").
    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
2026-08-29 Phase C.5: close the drive-mode loop on the 0x1F4 byte-4 live cursor
    The menu-walk injection was unreliable ("steps too far", second-cycle
    breakage). Two root causes, both fixed:
    1. WALK_GAP_S was 0.75s -- taps closer than ~1.2s coalesce/auto-repeat
    into extra cursor steps. Now 1.4s (clean window ~1.2-2.5s). Frame
    count (PRESS_TRACK_FRAMES 1..16) was never the lever.
    2. read_menu_cursor returned the OLDEST queued 0x1F4, not the newest --
    the RX socket buffers ~40Hz of 0x1F4 while send_mode_button_press
    runs (it only drains 0x1E1), so the closed loop read a stale "SPORT"
    frame while the cursor had already stepped to MOUNTAIN. CanInterface
    ._latest_status now drains the queu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
    [canio.py, modecycle.py, set_mode.py, signals.py, test_canio.py, test_modecycle.py]
2026-08-29 Add tools/drive_log.py: unattended mode-hold logging for a drive
    The parked car can select every mode but MOUNTAIN/HOLD revert after the
    commit; proving they hold needs the car moving, and live SSH from a
    moving car is impractical. drive_log.py runs autonomously: start it
    parked, drive normally. For each mode in --sequence it walks through the
    same closed-loop path as set_mode.py, polls 0x1F4 byte 1 for the commit,
    then samples byte 1 (and a tentative speed off 0x3E9) every --sample
    seconds for --hold seconds, logging every change to
    ~/vdmf-drivelog-<ts>.log. A parked-only revert vs a moving-car hold is
    then plain in the log, reviewed at home.
    --start-delay gives time to pull away; --dry-ru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
    [drive_log.py]
2026-08-29 Add SparkFun 4x20 LCD driver + offline candump miner
    voltdmf/lcd.py: SerLcd, a stdlib-termios (no pyserial) driver for the
    SparkFun serial 4x20 on the Pi's free hardware UART. Keeps an in-memory
    screen image; dry_run keeps only the image (what the tests and
    tools/lcd.py --dry-run exercise). Backlight control -- dimming is the
    cheapest fix for a board that resets on a sagging 5 V feed -- plus a
    boot-splash wait, skip-unchanged-row writes, and a periodic refresh() to
    recover a browned-out panel.
    tools/lcd.py: --selftest / --message / --watch. The --watch dashboard
    rides along with drive_log.py: shared t+<s> clock so a voice memo lines
    up with the log + capture, committed mode, can0 state, opt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
    [lcd.py, mine_capture.py, test_lcd.py]
2026-08-29 drive_log: add shift routine, SOC marks, raw capture, LCD mirror
    One unattended run now gathers three things instead of just mode-hold:
    1. MODE HOLD (unchanged) -- walk each --sequence mode through the closed
    loop, watch 0x1F4 byte 1 commit and hold.
    2. SHIFT / PRNDL -- new --shift-routine SECS parked phase: log 0x135 /
    0x1F5 and any frame that moved while the driver walks P-R-N-D-L-P.
    3. SOC -- spawn a full `candump -l` capture for the whole session and
    drop SOC-MARK timeline anchors every --mark-every s. This dash shows
    no % (only EV range + a coarse bar), so the raw capture + a voice
    memo narrated against the marks is the whole approach; mine it later
    with tools/mine_ca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
2026-08-29 Phase C session 4: mode-hold PASS on the road; decode PRNDL (0x1F5 b3)
    First drive (tools/drive_log.py, unattended, ~9 min). Results:
    MODE HOLD -- PASS for all four modes while moving. Each walked through
    the production closed loop, 0x1F4 byte 1 committed at +2.8 s and held
    the full 90 s (21-51 mph), can0 ERROR-ACTIVE throughout. Confirmed
    independently by mining the raw capture (byte 1 = 00/80/20/08 per
    block, in order). This settles session 3's open question: MOUNTAIN and
    HOLD, which drift toward NORMAL within ~1 min parked, hold while moving
    -- the parked reversion is stationary-only.
    PRNDL -- 0x1F5 byte 3 is the shift detent: 1 PARK, 2 REVERSE,
    3 NEUTRAL, 4 DRIVE, 5 LOW. Stepped 1->2->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
    [canio.py, signals.py, test_signals.py]
2026-08-29 Add tools/soc_log.py: passive SOC-discovery drive log with GPIO marks
    The SOC-focused successor to drive_log.py, per the plan in
    field-session-log session 4. Strips the mode walk and shift routine --
    SOC discovery is now the whole job -- and drops the --yes-unattended TX
    gate: this tool never transmits.
    * spawns candump -l for the whole --minutes N session (the deliverable;
    mine it afterward with tools/mine_capture.py --monotonic)
    * SOC-MARK timeline anchors every --mark-every s on a shared t+<s> clock
    * --buttons: two momentary buttons on the Pi header (BCM 5 / 6 to GND,
    gpiozero, lazy import + graceful fallback) for hand marks the instant
    the EV range or a battery bar ti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
2026-08-29 soc_log: buttons track the battery-gauge level, not generic marks
    The dash gauge has 10 increments, so encode the reading in the buttons
    and skip the parallel voice memo entirely:
    A (GPIO 5) = gauge just dropped one increment 10 -> 9 -> 8 ...
    B (GPIO 6) = gauge climbed back one (regen, or undo A)
    soc_log keeps the running level (--bars, default 10; --bars-start if you
    don't begin full), clamps at 0 and full, and stamps the absolute reading
    onto every log line as gauge=N/10 -- GAUGE-DOWN / GAUGE-UP edges plus the
    periodic SOC-MARK backstop. The LCD shows the live level. Summary reports
    gauge travel (start -> end, increments dropped).
    Afterward: mine_capture.py --monotonic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
    [soc_log.py]
2026-08-29 Add daemon LCD watch screen, hand-off lock, and 0x1F4 mode decode
    The daemon now brings up the SparkFun 4x20 itself and paints an idle
    status screen -- uptime/clock, committed drive mode, PRNDL gear + can0
    state, and what the fixer is armed to do -- whenever no purpose-driven
    tool wants the panel.
    - voltdmf/lcddash.py: LcdDashboard background thread + a pure
    render_screen(). Fail-soft -- never raises into the daemon loop; a
    missing/unusable serial port is just a dark screen with one warning.
    Always drives the real panel: --dry-run gates CAN TX only, not the
    display.
    - voltdmf/lcdlock.py: advisory single-writer hand-off lock
    (~/.voltdmf-lcd.lock, VOLTDMF_LCD_LOCK over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
    [__main__.py, button_check.py, canio.py, daemon.py, drive_log.py, lcd.py, lcddash.py, lcdlock.py]
2026-08-29 docs: update session-5 next-session notes post-merge
    Record that all Phase C work is now merged to main and the phase-c-*
    branches are gone. Add the deferred "installed daemon as the idle
    display" task with its three concrete blockers (stale /opt/voltdmf,
    voltdmf user not in dialout, ProtectHome lock-path mismatch).
    Claude-Session: https://claude.ai/code/session_01Xp4oqhmotNBFXX2LWxcADM
2026-08-30 Add runtime control socket: permanent root daemon steered by voltdmf-ctl
    The daemon now runs continuously as a root systemd service instead of being
    invoked as one-shot CLI runs. Operators change modes and daemon state from an
    unprivileged account over an AF_UNIX control socket; the privilege boundary is
    the socket file mode (0660 root:voltdmf) plus voltdmf-group membership -- no
    setuid, polkit, or D-Bus.
    - voltdmf/control.py: ControlServer accept loop on a daemon thread. `status`
    answered inline from a snapshot; set-mode/arm/disarm/reload go on a
    queue.Queue and run on the single daemon loop thread, so the CAN TX path and
    SafetyGate stay strictly single-threaded. inherited_listener()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
2026-08-30 Use live 0x1F4 status as the daemon's mode source; block on unknown shift
    daemon.py: replace PressCountingModeTracker with a direct read of
    state.drive_mode (fed by the RX listener decoding 0x1F4 byte 1). The
    blind NORMAL-on-start assumption and its ASSUMED_START_MODE constant are
    gone; an unreadable bus now yields ModeUnknownError and no injection,
    which is the fail-safe we want on a bus we cannot observe.
    safety.py: SafetyGate now defaults allow_unknown_shift=False. decode_shift
    is confirmed on-vehicle (0x1F5 byte 3 PRNDL, session 4, 2026-08-29), so an
    UNKNOWN shift now means a short/garbled frame, not a missing decoder --
    treat it as blocking. Bench rigs without a 0x1F5 stream can still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
    [daemon.py, safety.py, test_safety.py]
2026-08-30 docs: mark keyboard follow-ups done (daemon mode source, shift gate)
    commit 4013ea3 wired decode_drive_mode into the daemon and flipped
    SafetyGate to block on UNKNOWN shift. 0x1F4 RX decode was already in
    c9acafa. Shift/PRNDL is resolved (0x1F5 byte 3). Remaining keyboard work
    is the homelab-ansible restart-ms change and the post-injection version
    bump; the injection road test is still the gating item.
    Claude-Session: https://claude.ai/code/session_01UrExvzZSGk9TCtjR2ULvKF
2026-08-30 docs: mark the can0 restart-ms follow-up done
    homelab-ansible onboard-voltpi 665ed5d adds voltdmf_can_restart_ms (100)
    and puts restart-ms on the can0 bring-up unit, so the in-car interface
    self-recovers from BUS-OFF.
    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
2026-08-30 DESIGN: reconcile Open items + signal table with confirmed signals
    0x1E1 (button), 0x1F4 (mode status + menu cursor), and 0x1F5 byte 3
    (PRNDL) are all confirmed on-vehicle (2026-08-29). Move them out of "Open
    items" into a Resolved subsection, update the Known CAN signals table, and
    drop the now-moot "no status signal / press-counting fallback" hedging
    from the Trigger-strategies and Daemon-design prose.
    Still open: the real SOC message ID (0x206 is absent on this Gen 1 bus)
    and drive-mode persistence across ignition cycles.
    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
2026-08-30 field-session-log: point "next session" at the SOC discovery drive
    The stationary burst-and-release injection sweep was the headline next
    session; demote it to a warm-up and make SOC signal discovery the lead.
    0x206 is absent on this Gen 1 bus, so this is a from-scratch hunt that
    needs a real discharge drive: capture passively with tools/soc_log.py
    (candump -l + the two panel buttons to mark each gauge-increment change),
    then mine offline with tools/mine_capture.py --monotonic and calibrate
    SOC_KWH_PER_COUNT / GEN1_PACK_USABLE_KWH in voltdmf/signals.py.
    Also refresh the restart-ms notes now that can0 boots ERROR-ACTIVE
    restart-ms 100 on voltpi (ansible converge 665ed5d) -- no hand ip link.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
2026-08-30 field-session-log: control socket deployed + voltdmf_version bumped
    Mark two more "back at a keyboard" follow-ups done: the runtime control
    socket (voltdmf.socket + voltdmf-ctl) is in roles/voltdmf and converged +
    verified on voltpi (homelab-ansible c76c592), and voltdmf_version is
    pinned to 380e924 (6fbf2cd) -- done early because the socket needs
    voltdmf/control.py, and it also unstuck the frozen /opt/voltdmf/repo
    checkout. Daemon still armed=False, dry_run=True.
    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
2026-08-30 docs: field-session-log — LCD dialout fix + control-socket restart bug
    homelab-ansible 7388119: voltdmf.service gains SupplementaryGroups=dialout
    (daemon can open /dev/serial0 for the watch screen) and both units get
    RuntimeDirectoryPreserve=yes so a bare `systemctl restart voltdmf.service`
    stops wiping /run/voltdmf and orphaning voltdmf.socket's endpoint.
    Converged + verified on voltpi 2026-08-30. Marks item 3(a)/(b) done; 3(c)
    (VOLTDMF_LCD_LOCK path) still open.
    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
2026-08-30 lcdlock: default to /run/lock, not a $HOME dotfile
    The deployed daemon runs as User=voltdmf under ProtectHome=/
    ProtectSystem=strict; the by-hand LCD tools run as the login user out of
    ~/vdmf. They share no writable $HOME, so the old
    `Path.home()/".voltdmf-lcd.lock"` default had the tool writing
    /home/mike/.voltdmf-lcd.lock while the daemon watched
    /opt/voltdmf/.voltdmf-lcd.lock — the hand-off never fired.
    _default_lock_path() now prefers /run/lock/voltdmf-lcd.lock (FHS, tmpfs,
    1777 — reachable by both), falling back to the $HOME dotfile only where
    /run/lock is absent (dev boxes, non-Linux). VOLTDMF_LCD_LOCK still
    overrides; LOCK_PATH stays a reassignable module attribute for tests.
    Fu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
2026-08-30 soc-drive: document the ~/vdmf clone-refresh bench-prep step
    The Pi's ~/vdmf is a by-hand rsync/scp target and drifts. On 2026-08-29 it
    sat 25 commits behind origin/main with soc_log.py / mine_capture.py present
    only as untracked ad-hoc copies, so their CLI didn't match the writeup. Add
    a Bench prep block to the SOC-discovery section: the stash + reset --hard
    origin/main + clean one-liner, the "match the deployed voltdmf_version pin"
    rule, stash-pop recovery, and the --dry-run sanity check. Records that it
    was done this session (clone now at 312ea1d) with the on-Pi backup names.
    Claude-Session: https://claude.ai/code/session_01UrExvzZS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
2026-08-30 docs: SOC-drive bench prep complete; LCD-lock fix landed on voltpi
    Session 6 (2026-08-30, keyboard + Pi bench):
    - New field-session-log Session 6 entry.
    - LCD hand-off lock fix (volt 9dc7a77 + voltdmf_version 312ea1d converge)
    marked landed + verified in the Follow-ups section; the earlier
    "needs a bump + converge" note is resolved.
    - ~/vdmf clone drift (25 commits behind, untracked ad-hoc tool copies)
    recorded as fixed via git reset --hard origin/main; recovery artifacts
    noted.
    - SOC-discovery-drive section: bench-verified block (button_check +
    soc_log --buttons --lcd, two-way LCD hand-off timings, spd~n/a non-issue).
    - phase-c-field-checklist 2b rewritten off the stale watch_soc.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
2026-08-30 design: replace edge triggers with a continuous level-triggered reconciler
    Ignition is effectively always on (the Pi only has power while the car
    runs), so there is no ignition edge. Replace OnStartTrigger +
    SocThresholdTrigger with one reconciler: each loop pass computes
    desired_mode(setpoint, soc, floor_latched) and walks the car there
    through the unchanged SafetyGate -> ModeCycleController.
    - setpoint is a 2-state toggle HOLD <-> MOUNTAIN on one panel button,
    set via a system-Python gpiozero helper calling `voltdmf-ctl setpoint`
    over the existing control socket (daemon venv stays GPIO-free)
    - SOC-HOLD floor always wins; hysteresis latch in memory only
    - no persisted state (read-only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
2026-08-30 buttons: panel-launched SOC capture via a gesture-dispatch helper
    tools/button_helper.py owns the two PiCAN2 switch pads as one long-lived
    process and dispatches by gesture:
    SW1 tap -> voltdmf-ctl setpoint <hold|mountain> (a logged no-op
    until `setpoint` lands in voltdmf-ctl)
    SW1+SW2 held 5s -> systemctl start voltdmf-soclog.service, block until
    the SOC-discovery capture finishes
    The helper releases both GPIO lines before the capture oneshot starts and
    re-acquires after; it also detects an in-progress capture on its own
    startup and waits it out, so a restart mid-capture is safe. Runs under the
    system interpreter (gpiozero/lgpio live ther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
2026-08-30 buttons: give voltdmf-btn.service a writable runtime dir for lgpio
    The first gpiozero Button() callback makes lgpio's alert thread drop its
    .lgd-nfy* notify FIFO into $HOME (or the CWD). A systemd service inherits
    CWD=/ and, once User= / ProtectSystem=strict put a read-only home under it,
    the FIFO create fails -- gpiozero then silently walks its fallback chain
    down to the NativeFactory, which can't drive the pins on a current kernel
    ("[Errno 22] Invalid argument"). Add RuntimeDirectory=voltdmf-btn and point
    HOME + WorkingDirectory + LG_WD at it so the real LGPIOFactory loads.
    Reference unit only; the deployed copy is roles/voltdmf's template in
    homelab-ansible, fixed in lockstep.
    Co-Author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
2026-08-30 buttons: helper stole the GPIO lines seconds into a capture
    _wait_out_unit(start=True) trusted the exit of a blocking `systemctl start`
    to mean the oneshot had finished. That only holds for a root caller on the
    system bus; over the polkit path the helper uses (User=voltdmf-btn) the
    start returns as soon as the job is queued, so the helper's finally-block
    re-acquired SW1/SW2 a few seconds into the 90-minute capture. soc_log.py
    then came up with "GPIO 24/23 unavailable: GPIO busy" and ran the whole
    drive with its buttons dead.
    - button_helper: track the capture by `systemctl is-active` (start with
    --no-block, wait for it to come up, then poll until it is gone). Never
    look at the start com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
2026-08-30 buttons: force a real GPIO release on the helper's capture hand-off
    The 5b951da hand-off still failed on the car: soc_log.py logged
    "buttons off (GPIO 24/23 unavailable after 8 tries: 'GPIO busy')" and
    /proc/<helper>/fd showed voltdmf-btn still holding both gpio-line fds
    straight through the capture.
    gpiozero's Button.close() drops the Python object but leaves lgpio's
    gpiochip handle open, so the kernel lines stay claimed -- the per-object
    close is not enough. _release_buttons() now also closes the gpiozero pin
    factory (Device.pin_factory.close(); = None), which shuts the gpiochip fd
    and frees every line lgpio held; the next Button() rebuilds the factory
    lazily. soc_log.py's acquire retry d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
    [button_helper.py, soc_log.py]
2026-08-30 soc_log: stop gesture no longer leaks a gauge tap
    You can't press both pads on the same millisecond, so the first one down
    was firing its when_pressed (GAUGE-UP/DOWN) before the hold-both stop was
    recognised. Drop the callbacks: the main loop's tick() now reads both pads
    by is_pressed edge and only commits a tap on *release*, and only if the
    other pad was never down during that press. A staggered two-button hold
    therefore records no gauge move, just the stop.
    Claude-Session: https://claude.ai/code/session_012h5AVQfRUp9kqjg639qrBu
    [soc_log.py]
2026-08-30 docs: field-session-log — panel-launched SOC capture working in-car
    Session 7: the SW1+SW2 gesture launched voltdmf-soclog.service first try,
    but soc_log.py's A/B/stop buttons took three rounds -- helper re-grabbing
    the lines on a queued `systemctl start` (5b951da), gpiozero Button.close()
    never freeing the lgpio-held kernel lines (e69cb44), and the hold-both stop
    leaking a GAUGE tap because the pads never land together (55fe176). All
    three landed and verified in the car; discharge drive still to do.
    tools/README.md: soc_log taps commit on release; button_helper frees the
    lines by tearing down the pin factory, not a bare Button.close().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
2026-08-30 docs: phase-c checklist — SOC capture panel-launch verified in-car
    Session 7 note + 2b: the SOC discharge drive can now be started and stopped
    from the driver's seat (SW1+SW2 hold-5s -> voltdmf-soclog.service; in-logger
    A/B/stop work) after the three GPIO hand-off fixes. Only the drive itself
    and mine_capture.py analysis remain for SOC.
    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
2026-08-30 docs: add "force 12A Level 1 charging" stretch goal + charge-mode prelude
    The center-stack 8A->12A charge-rate setting reverts to 8A on every Park
    exit; owner always charges on a known-good home circuit, so holding 12A is
    a safe convenience win. DESIGN.md gets a stretch-goal writeup (goal,
    approach, unknowns, safety). phase-c-field-checklist gets a new 2e: a
    ~2-min charge-mode prelude on the SOC drive (toggle 8<->12A in Park, note
    times, shift to Drive for the free forced-revert edge timestamped by
    0x1F5 byte 3), plus the offline --shift-window analysis steps.
    signals-confirmed.md gets a NOT CONFIRMED stub for the setpoint frame.
    Claud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
2026-08-30 session8: SOC drive analysis, speed/accel logging fix, 2-bar HOLD floor
    Full-drain SOC discharge drive (Session 8) captured and analysed. Documents
    the findings and fixes the speed logging that recorded spd~n/a for the
    whole drive.
    Analysis (docs/field-session-log.md, docs/phase-c-field-checklist.md):
    - SOC narrowed to 3 energy-linked broadcast candidates (0x3E3 b0/b1/b6
    strongest, 0x228 b2, 0x186 b6); 4 elapsed-time counters positively
    excluded via a per-bar delta-vs-duration correlation test.
    - 0x206 re-confirmed absent (0 frames in 213 MB). GM Volt RE wiki carries
    battery % only as diagnostic PID 22 005B, not a broadcast.
    - No absolute scaling anchor yet; Session 9 plan written int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
    [signals.py, soc_log.py, test_signals.py]
2026-08-30 session9-prep: docs pass + soc_log --diag-soc / candidate probes
    Align all docs with the level-triggered reconciler model (commit 2d9fd8c)
    and prep the Session-9 SOC anchor drive:
    - README / DESIGN / signals-confirmed / phase-c-field-checklist: replace
    the two-edge-trigger framing with the single reconciler (SOC-HOLD floor
    + panel-button setpoint); refresh stale status lines; mark the 0x1F4
    mode-source wiring and allow_unknown_shift=False done (4013ea3); note
    setpoint / the reconciler itself are designed but not yet built.
    - Drop the published-artifact links; the Session-8 SOC analysis now lives
    in-repo at docs/analysis/session8-soc-candidates.md with committed SVGs,
    regenerable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
    [soc_log.py, soc_report.py, test_soc_log.py]
2026-08-30 docs: condense README/DESIGN to current state; US English spelling
    Strip session-by-session history and "originally X, now Y" framing from
    README.md and DESIGN.md — current state only; the running narrative lives
    in docs/field-session-log.md and docs/phase-c-field-checklist.md.
    Normalize spelling to US English repo-wide (behaviour->behavior,
    normalise*->normalize*, artefact->artifact, honour->honor, analyse->analyze,
    recognis*->recogniz*, deprioritis*->deprioritiz*, mislabelled->mislabeled,
    summarise->summarize, grey band->gray band). Comment/help-text only in
    voltdmf/*.py and tools/*.py; no code change. Suite green (183).
    Claude-Se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
2026-08-30 soc_log: fix --help crash from a bare % in the --diag-soc help text
    argparse %-expands each action's help string, so the literal "SOC %." in
    --diag-soc's help raised ValueError: unsupported format character ' '
    whenever --help was rendered (normal runs were unaffected). Reword to
    "SOC percentage" and pull the parser into _build_parser() so it can be
    exercised directly. Adds two regression tests (help renders; --diag-soc
    flags parse). Suite 185.
    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
    [soc_log.py, test_soc_log.py]
2026-08-30 session9-prep: SW2-solo-hold panel gesture -> charge-mode capture
    button_helper.py grows a third gesture: hold SW2 alone ~5 s, then
    release (SW1 never joined) launches voltdmf-chargelog.service -- a
    passive soc_log.py run for the charge-current-setpoint garage session
    (phase-c checklist section 2e). Fires on release so a hand reaching for
    the SW1+SW2 SOC combo cannot pre-empt it.
    - extract the gesture rules into a side-effect-free _Gestures state
    machine; _loop() is now a thin dispatch wrapper. New
    tests/test_button_helper.py (13 cases) covers all three gestures.
    - parameterize _do_launch / _unit_running / _wait_out_unit by unit so
    both captures share the LCD-lock / GPIO-handoff / pol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
2026-09-01 session9: SOC anchor drive — 22 005B confirmed as SOC source, gauge↔SOC calibrated
    Diag poll 22 005B (SOC% = raw*100/255) ran the whole ~31 min drive: 185/186
    replies, can0 stayed ERROR-ACTIVE. Gauge-bar to SOC is near-perfectly linear
    (SOC% ~= 7.07*bars + 19.6, r = 0.999); 2-bar band ~= 27-34% SOC, so the
    reconciler SOC-HOLD floor = force HOLD at diag SOC <= ~33% (raw <= 0x54).
    HOLD verified charge-sustaining at ~30% (SOC floored 29.8%, climbed to 33.7%
    over ~11 min of further driving, gauge pinned at 2 bars).
    Session-8 broadcast candidates falsified against the diag ground truth:
    0x3E3 b0/b1/b6, 0x228 b2, 0x186 b6 collapse to a vertical smear at the HOLD
    plateau (powertrain load/curre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
    [soc_report9.py]
2026-09-01 session9: reconciler cutover — level-triggered mode control + always-on 22 005B SOC poll
    Session 9 resolved SOC: the `22 005B` UDS poll gives exact pack percent
    (raw·100/255) and the gauge↔SOC curve is near-linear (SOC% ≈ 7.07·bars + 19.6,
    r = 0.999), with the 3→2 bar drop at 33.7%. That unblocks the reconciler.
    Core change: replace the edge-triggered `triggers.py` (OnStartTrigger /
    SocThresholdTrigger) with a single level-triggered `voltdmf/reconciler.py`.
    - Reconciler.desired_mode(state) -> DriveMode, always concrete. Armed = enforce
    the setpoint (HOLD ⇄ MOUNTAIN); a hand-picked mode change is walked back once
    per 60s SafetyGate cooldown. HOLD above the floor now means *e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
    [__main__.py, canio.py, config.py, control.py, ctl.py, daemon.py, drive_log.py]
2026-09-01 session9: passive "auto" setpoint as the shipped default
    The reconciler cutover booted armed at default_setpoint: hold, so a
    mid-drive restart on a healthy pack walked the car straight into HOLD.
    That is wrong: a restart should leave the car where the driver has it
    unless the SOC-HOLD floor engages or the driver has explicitly picked a
    setpoint.
    Add a third setpoint state: None internally, "auto" on the wire/config,
    now the shipped default. desired_mode() returns None when the setpoint is
    passive and the floor is clear ("no target, leave the car alone"); the
    floor still always wins. set_setpoint() still only accepts HOLD/MOUNTAIN
    (SW1 toggle) - there is no runtime path back to auto, only a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
    [config.py, daemon.py, reconciler.py, test_config.py, test_daemon_control.py, test_reconciler.py]
2026-09-03 session10: closed-loop mode-walk fix + in-car walk-test self-test
    Two related changes to make drive-mode switching land where it's told,
    and to let the driver verify that from the car with no laptop.
    Closed-loop mode walk
    - state.menu_cursor: 0x1F4 byte 4 (live menu cursor), decoded by the RX
    listener only while the menu-open bit (byte 5 bit 7) is set -- an idle
    frame carries byte 4 == 0x00 which would otherwise read as NORMAL.
    - daemon wires menu_cursor_source into ModeCycleController, so switch_to()
    runs the closed loop (tap, settle, stop the instant the cursor reads the
    target) instead of the open-loop index+1 walk that was only correct from
    a cold NORMAL menu. Th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
    [button_helper.py, canio.py, control.py, ctl.py, daemon.py, safety.py, state.py, test_button_helper.py]
2026-09-03 session10 fix: ungate the menu-cursor feed; LCD feedback on refused walk-test
    Walk-test failed on-vehicle: every non-NORMAL leg raised ModeSwitchFailed
    after the full 8 taps ("menu cursor never reached sport/mountain/hold").
    Root cause: _DecodeListener populated state.menu_cursor only on 0x1F4
    frames with byte-5 bit 7 (menu-open) set, and nulled it otherwise. That
    bit flickers off many times a second mid-walk on the injected path
    (docs/signals-confirmed.md, and the session-4 road notes), so the closed
    loop read None at nearly every check and never matched the target. NORMAL
    legs passed by luck -- 0x00 is byte 4's resting value.
    The on-road-validated path (session 4, PASS all four modes) us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
    [canio.py, daemon.py, state.py, test_canio.py, test_daemon_control.py]
2026-09-03 docs: voltpi boot-time reduction plan
    Tiered plan to cut battery-protection coverage latency from ~19-25s to
    ~6-8s after the car powers the Pi. Tier 1 (drop voltdmf.service's
    network-online.target dep) is the single biggest lever; tiers 2-3
    (disable cloud-init, NetworkManager-wait-online) are the rest of the
    no-risk win; tiers 4-6 (kernel/config.txt trims, service masking, Lite
    image + overlayroot) are follow-ups.
2026-09-03 session10: per-tap 0x1F4 trace for the walk-test
    The in-car walk-test still fails 2/4 legs after the ungated-cursor fix
    (03daa48), and the pass/fail pattern is self-contradictory: leg 1
    (target NORMAL, cold menu) fails after 8 taps while the restore leg
    (also target NORMAL) matches on tap 1. The byte-4 cursor map and the
    "steps ~40 ms after the tap" timing were both derived from physical
    button presses (sessions 3-4); the injected daemon walk has never been
    logged frame-by-frame, so every root-cause theory is a guess.
    Instrument instead of blind-patching:
    - state.menu_cursor_raw / state.menu_open_hint: raw 0x1F4 byte 4 (even
    when unmapped) + the byte-5 open hint, captured every frame.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
    [canio.py, daemon.py, modecycle.py, state.py, test_canio.py, test_modecycle.py]
2026-09-03 docs: boot-time plan — connectivity guarantee for the headless box
    The Pi is reachable only over Wi-Fi/Tailscale, so add a section making
    explicit that no tier disables Wi-Fi: tiers 1 & 3 remove boot *barriers*
    (network-online.target waits), not NetworkManager or the radio, and
    tiers 2-3 actually get the link up sooner. Hard rules: NM stays
    enabled/unmasked, keep cfg80211.ieee80211_regdom=US on cmdline, keep both
    wifi_failover profiles, don't mask wpa_supplicant/avahi without verifying,
    re-check SSH-in after every reboot. Move wpa_supplicant + avahi to a
    conditional "verify first" bucket in tier 5; add systemd-networkd-wait-online
    to the tier-3 barrier disables.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
2026-09-03 session10: focused interactive walk probe (test-mode + probe)
    The 5-leg auto-cycle walk-test is too coarse to debug the in-car
    mode-walk failures: it blind-taps up to 8x/leg, scores off 0x1F4 byte 1
    4s later, and never shows the byte-4 cursor trajectory in between.
    Add two control commands, driven over SSH:
    voltdmf-ctl test-mode on|off -- suspend/resume the reconciler for an
    interactive probe session. In memory; a restart resumes protection.
    SOC poll + trip log keep running; only the reconcile pass is skipped.
    voltdmf-ctl probe <mode> -- one operator-chosen closed-loop walk,
    densely traced. Own cooldown-free Park-tolerant SafetyGate + force,
    the per-tap 0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
    [control.py, ctl.py, daemon.py, test_control.py, test_ctl.py, test_daemon_control.py]
2026-09-03 boot-plan: fold in verified voltpi connectivity checks
    Checked live on voltpi 2026-09-03: /etc/netplan/ empty (NM keyfile owns
    wlan0 -- Tier 2 network-safe); wpa_supplicant.service enabled+active and
    NM-driven (do NOT mask -- confirmed load-bearing); networkd-wait-online
    already disabled (only NM-wait-online left for Tier 3).
2026-09-03 session10: fix the mode walk -- correct cursor decode + 2-frame press
    Two independent bugs, both measured on-vehicle 2026-09-03 rather than
    inferred. Either alone breaks the walk.
    1. PRESS_TRACK_FRAMES was 16 -- a HELD button, not a tap. The cluster
    key-repeats a held button, so each "tap" walked ~5-6 menu rows. Measured
    steps per press (tools/press_calibrate.py burst, 3 reps each):
    1 -> 1 2 -> 1 3 -> 1-2 4 -> 1 8 -> 2 16 -> ~5-6
    Now 2. This is why the menu spun at 50-75 ms/step and why a restore leg
    burned 8 taps with 0x1F4 byte 1 never leaving HOLD.
    2. The menu-cursor decode was wrong. The cursor is ONE field spanning 0x1F4
    bytes 4 AND 5; byte 5 bit 7 is t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
    [canio.py, daemon.py, modecycle.py, press_calibrate.py, set_mode.py, signals.py, state.py, test_canio.py]
2026-09-03 session10: PRESS_TRACK_FRAMES 2 -> 1; two frames double-step
    The 2-frame press was still wrong, just less wrong. On-car probing of the
    deployed 7fef9f3 caught it: a HOLD walk landed in 3 taps instead of 4, and
    the probe's dense sampler showed why -- on one tap the cursor read mountain
    at t=3.520 and hold at t=3.571. 51 ms apart, i.e. exactly one cluster
    key-repeat. Two frames (~50 ms of "held") sits right on the repeat boundary.
    Re-measured with tools/press_calibrate.py, more reps than the 3 that let this
    through the first time:
    2 frames -> 1 step, but double-steps ~1 run in 8 (3/24 overall)
    1 frame -> 1 step, 22/22, never a double
    1 frame does get dropped occasionally (~5-10%).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
    [canio.py, set_mode.py]
2026-09-03 session10: stop the press path racing the RX Notifier for 0x1E1
    Root cause of the dropped taps. The tracking-echo press reads the module's
    live 0x1E1 with self._bus.recv(), but in the daemon a can.Notifier is running
    on that SAME bus. Two threads recv()ing one socket means each frame goes to
    exactly one of them, so the press path loses most 0x1E1s to the Notifier,
    times out at _TRACK_FRAME_TIMEOUT_S, and falls through to the static payload
    the Gen 1 cluster ignores. That is a silently dropped tap.
    Measured on-vehicle 2026-09-03: ~21% of taps dropped in the daemon (38 taps
    for 30 needed across a 12-probe run) against 0/22 for the same press logic in
    tools/press_calibrate.py -- which has a si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
2026-09-04 canio: give the tracking-echo press its own 0x1E1-filtered socket
    The press has to echo the module's CURRENT 0x1E1 counter -- a stale one is
    the frozen-counter frame the cluster ignored in session 2. Two earlier
    sources for that frame both lost taps on-vehicle (2026-09-03, 12-probe runs):
    * recv() on the shared bus -- 21% dropped taps. SocketCAN hands each frame
    to exactly one reader, so the press raced the daemon's can.Notifier.
    * the frame stashed by the RX listener (71f0fc3) -- WORSE, 36% and a MISS.
    That falsified the pure-contention theory: reading the state always
    yields a frame, but the Notifier thread lags on a busy Global A bus, so
    the frame it stashed was often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
2026-09-04 safety: a failed walk reports the taps it actually sent, not 0
    request_verbose returned presses=0 for any exception from switch_to, so a
    ModeSwitchFailed -- the one outcome where the tap count is the evidence --
    always surfaced as "taps 0" in the probe result and journal. The 2026-09-03
    12-probe runs therefore under-counted total taps on exactly the failing
    rounds, skewing the dropped-tap rate low.
    ModeSwitchFailed now carries `taps`, and request_verbose reports it. `sent`
    stays False: taps went on the wire but the switch did not land.
    Claude-Session: https://claude.ai/code/session_01JtiQC6rERXoaKqE9P8nEKt
    [modecycle.py, safety.py, test_safety.py]
2026-09-04 docs+test: record the two-socket split and pin the tap-count contract
    DESIGN.md "Safety model" now explains why the press path owns a second,
    0x1E1-filtered socket -- with the two measured failures of sharing one (21%
    dropped taps racing the Notifier, 36% reading its stale decoded state) -- and
    notes it widens no privilege.
    test_modecycle asserts ModeSwitchFailed carries the tap count, which is what
    SafetyGate reports into the probe result.
    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
    [test_modecycle.py]
2026-09-04 canio: drain the echo socket's stale backlog before each press
    The two-socket split (bd21ec1) removed the contention but introduced a
    new failure that was worse than the one it fixed: nothing reads the echo
    socket between taps, so across the walk's ~1.6 s inter-tap gap it queues
    ~52 frames of 0x1E1, and recv() hands back the OLDEST of them.
    Measured on-vehicle 2026-09-04:
    idle 0.0 s -> first recv is fresh, 0 frames queued behind it
    idle 0.2 s -> first recv 170 ms old, 5 queued
    idle 0.8 s -> first recv 791 ms old, 26 queued
    idle 1.6 s -> first recv 1582 ms old, 52 queued
    A 1.6 s-old frame carries a counter ~52 counts behind the module, which
    is the frozen-counter ech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
    [canio.py, test_canio.py]
2026-09-04 canio: drain the echo socket before mirroring a 0x1E1 frame
    THE root cause, measured directly. Nothing reads the echo socket between
    taps, so across the walk's ~1.6 s inter-tap gap it accumulates a backlog and
    recv() returns the OLDEST frame in it. On-vehicle 2026-09-04, 0x1E1 at ~32Hz:
    idle 0.0 s -> first recv fresh, 0 queued behind it
    So every tap echoed a counter ~52 counts behind the module -- the
    frozen-counter frame the cluster ignores. The 12-probe run on the previous
    pin showed it plainly: 58% dropped taps, 2 MISSes,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
2026-09-04 daemon: probe_running must span the run, not just the queued window
    `probe_running` was `_probe_pending is not None`, and `_run_probe` clears
    `_probe_pending` on its first line. So the flag was True only between the
    control command and the loop's next pass, and False for the entire
    duration of the probe.
    A client doing the obvious thing -- issue probe, poll until not
    probe_running, read `probe` -- therefore reads the PREVIOUS probe's
    result. That is not hypothetical: it produced a full 12-row validation
    round on 2026-09-04 where rows reported LANDED with a byte1_after that
    did not match their own target, and the numbers were only caught because
    they were self-contradictory.
    _probe_active n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
    [daemon.py, test_daemon_control.py]
2026-09-04 docs: session 11 -- the mode walk lands 35/35 legs, and why
    Records the result (three consecutive 12-probe rounds, 35/35 landed, zero
    MISSes, worst case 4 taps against MAX_WALK_TAPS 12) and the four measured
    press-path designs behind it.
    The useful part for anyone reading this later is that all three failures
    were one root cause -- an echo mirroring a spent 0x1E1 counter -- and
    that isolating the socket made it WORSE before the drain made it work.
    Also records the two measurement bugs that produced confidently wrong
    numbers first, since both are easy to hit again.
    Claude-Session: https://claude.ai/code/session_01JtiQC6rERXoaKqE9P8nEKt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
2026-09-04 selector: replace the HOLD<->MOUNTAIN toggle with a 3-position SW1 cycle
    The driver-facing model is now one rotary detent per SW1 tap, wrapping on the
    fourth:
    1. hold hold the pack at 30% -- passive above the floor, so the car
    drives normally until the SOC-HOLD floor engages. Boot default.
    2. mountain enforce MOUNTAIN continuously (the floor still wins).
    3. off do nothing, floor disabled -- as if the device were unplugged.
    Position 1 is what the old `auto` setpoint already did, so this is mostly a
    rename plus a genuinely new `off` and a 33% -> 30% engage point (mid-2-bar;
    release stays at 41%, the 3-bar mark). The old "setpoint hold = enforce HOLD
    continuou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
    [button_helper.py, config.py, ctl.py, daemon.py, reconciler.py, test_config.py, test_ctl.py]
2026-09-04 reconciler: four-position selector, permanent SOC-floor latch, faster re-assert
    Splits the second detent (formerly plain "hold", enforce-continuously) out
    of the passive-until-floor detent, since "hold" was ambiguous once two hold
    behaviours existed: hold-soc (passive, floor engages at 30% and boot
    default) and hold-now (enforce HOLD from loop 1, no SOC reading needed).
    Both legacy names (auto, hold) still resolve to hold-soc in config so an
    un-converged host keeps booting.
    The SOC floor now latches for the rest of the key cycle instead of
    releasing at 41% -- "drain to 30%, then hold, and do not let it change".
    The b3 passive-proxy failsafe gets a startup grace (poll_stale_s) so it
    can't co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
    [button_helper.py, config.py, ctl.py, daemon.py, reconciler.py, safety.py, signals.py]
2026-09-04 lcddash: swap clock/uptime for SOC%, selector, and a live bus glyph
    The watch screen previously spent two of its four rows on a wall clock and
    an uptime counter -- useful for "is the daemon alive" but nothing else.
    Replace them with the diag SOC % (the exact number, not the cluster's
    5-bar approximation), the live VDMF selector position with its floor-latch
    flag, and shrink the bus state to a 2-char glyph that spins while the bus
    is active and blinks on a fault, freeing a full row for the selector that
    previously had no place on the panel at all.
    A trailing '~' marks the SOC % as not a live poll reading (stale poll, or
    the bar failsafe took over) -- Reconciler.poll_stale_s is now public so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
    [daemon.py, lcddash.py, reconciler.py, test_daemon_control.py, test_lcddash.py, test_reconciler.py]
2026-09-04 lcddash: DM label, SOC on row 4, full-word bus status, selector flash
    GM -> DM (Drive Mode) on the gear row, since GM was ambiguous next to the
    daemon's own selector. SOC moves to row 4 -- rows 2 and 4 had drifted into
    saying the same thing (selector position, restated as a status sentence),
    so row 4's old "what am I armed to do" text is dropped in favor of the raw
    SOC number; that text is still visible live via `voltdmf-ctl status`
    (last_action). The bus-state row swaps its 2-3 char glyph for the full
    word (ACTIVE/WARNING/PASSIVE/BUS-OFF/STOPPED/QUIET), still animated --
    ACTIVE spins a trailing tick, WARNING/BUS-OFF blink.
    The selector row now flashes the just-picked setting ("-> MOUNTAIN"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
    [daemon.py, lcddash.py, test_daemon_control.py, test_lcddash.py]
2026-09-06 reconciler: stop walking a menu that will not take the mode
    The 2026-09-04 drive: park on a nearly-flat pack, restart, and the car
    comes up running the range extender in NORMAL, having written the pack
    off for the key cycle. The centre stack then drops HOLD and MOUNTAIN
    from the energy-mode menu entirely, so every walk the reconciler tried
    spent 12 taps and failed -- once per 10s cooldown, for the whole drive.
    Two changes, one for the failure we can now name and one for every
    other one.
    **Detect the engine.** Mined offline from the captures already in
    captures/ -- session 8 (drain into forced charge-sustaining), session 9
    (a driver HOLD leg) and the 4.7 min errand as an EV-only control. Tw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
    [canio.py, ctl.py, daemon.py, engine_check.py, lcddash.py, reconciler.py, safety.py, signals.py]
2026-09-20 reconciler: fast-abort a menu walk when the module isn't responding
    Session 13 field report: the car has a retained-power-like window
    (ignition off, door not opened) where the cluster, the Pi, and
    cluster-related bus traffic all stay alive, and the reconciler tried
    to walk the mode menu into it. No confirmed signal distinguishes that
    window from true ignition-on yet, so this isn't an ignition gate --
    it's a blast-radius reduction: MENU_UNRESPONSIVE_TAPS aborts a doomed
    walk after 3 taps instead of the full 12 once the cursor has never
    once opened. A cursor that opens and then sticks still gets the full
    budget.
    Also ships tools/ignition_diff.py (three-window on/off-RAP/on capture,
    modeled on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
2026-09-20 boot: cut voltpi cold-boot time from ~26.6s to ~15.7s (Tiers 1.5-5)
    voltdmf.service was reaching active at @19.2s of a ~26.6s total boot,
    almost all of it dead time: DefaultDependencies=yes silently chained
    voltdmf's own units behind sysinit.target -> cloud-init -> the
    /boot/firmware fsck, then behind NetworkManager-wait-online even
    though the daemon is CAN + a local socket + a serial LCD, nothing
    IP-based.
    Tier 1.5 (this repo's half): drop the implicit sysinit/basic.target
    wait from voltdmf.service/.socket by adding DefaultDependencies=no,
    with Conflicts=/Before=shutdown.target manually re-added per
    systemd.special(7) so the daemon still gets an orderly stop (it holds
    an open SocketCAN soc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
2026-09-20 hardware: add parametric dash enclosure design (OpenSCAD)
    Three-part printable case (base/lid/foot) for the Pi 3B+/PiCAN2/
    SparkFun 20x4 LCD stack, sized for the dash mount left of the wheel
    above the vent. Fully parametric via the OpenSCAD Customizer -- see
    hardware/enclosure/README.md for the measure-first checklist,
    print/BOM/assembly steps, and known constraints before printing.
    [volt_dash_case.scad]
2026-09-20 safety: gate mode switches on confirmed ignition state (0x3ED)
    Session 13 found that the RAP window (ignition off, door not opened)
    keeps the bus alive and defeats the existing bus_active heuristic, so
    the reconciler kept trying to walk the menu with the car effectively
    off. Session 14's in-car ON/OFF/ON capture (reproduced across two
    independent cycles) found the real signal: 0x3ED is present with a
    constant payload only while the ignition is on, and vanishes entirely
    -- including through RAP -- the instant it goes off.
    Wires state.ignition_on into SafetyGate._precondition_failure() (the
    shared gate for both the reconciler and manual set-mode), resets the
    daemon's retry budget on ignition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
    [canio.py, daemon.py, lcddash.py, safety.py, signals.py, state.py, test_canio.py, test_daemon_control.py]
